Sasha7b9Work/Linia/doc/РД/Описание регистров.docx

Измеритель тока (блок коллектора)

Источник 3 кВ (блок коллектора)

Формирователь развёртки (блок коллектора)

ИЗМЕРИТЕЛЬ ТОКА (БЛОК КОЛЛЕКТОРА)

Диапазоны измерителя тока (сентябрь 2026)

| Вид развертки | Предел | Диапазон | № | Q2 : Q4 | Коэф-т отклонения | Ку | Q0, Q1 | Q7 | Дискрет
Реж. Большого тока | Только импульсы 10, 20, 50, 100 мкс | 400 A 2.5 мОм (5 мОм //5 мОм) | 400 А | 1 | 101 | 40 А/дел. | 1 | 00 | 0
| | | 200 А | 2 | | 20 А/дел. | 2 | 01
| | | 100 А | 3 | | 10 А/дел. | 4 | 10
| | | 50 А | 4 | | 5 А/дел. | 8 | 11
| | | 20 А | 5 | | 2 А/дел. | 20 | 01 | 1
| | | 10 А | 6 | | 1 А/дел. | 40 | 10
| | | 5 А | 7 | | 0,5 А/дел. | 80 | 11
| | 10 А (20 А) 50 мОм | | | запрещенный диапазон
Режим Высокого напряжения | SIN, АС, Импульсы ≥0,2 мс | | 10 А | 8 | 100 | 1 А/дел. | 2 | 01 | 0
| | | 5 А | 9 | | 0,5 А/дел. | 4 | 10
| | | 2 А | 10 | | 0,2 А/дел. | 10 | 00 | 1
| | | 1 А | 11 | | 0,1 А/дел. | 20 | 01
| | | 0,5 А | 12 | | 50 мА/дел. | 40 | 10
| | 200мА 5 Ом | 0,2 А | 13 | 011 | 20 мА/дел. | 1 | 00 | 0
| | | 0,1 А | 14 | | 10 мА/дел. | 2 | 01
| | | 50 мА | 15 | | 5 мА/дел. | 4 | 10
| | | 20 мА | 16 | | 2 мА/дел. | 10 | 00 | 1
| | | 10 мА | 17 | | 1 мА/дел. | 20 | 01
| | | 5 мА | 18 | | 0,5 мА/дел. | 40 | 10
| DC, SIN, АС, Имп.. ≥0,2 мс | 2мА 500 Ом | 2 мА | 19 | 010 | 0,2 мА/дел. | 1 | 00 | 0
| | | 1 мА | 20 | | 0,1 мА/дел. | 2 | 01
| | | 0,5 мА | 21 | | 50 мкА/дел. | 4 | 10
| | | 0,2 мА | 22 | | 20 мкА/дел. | 10 | 00 | 1
| | | 0,1 мА | 23 | | 10 мкА/дел. | 20 | 01
| | | 50 мкА | 24 | | 5 мкА/дел. | 40 | 10
| DC, SIN, АС | 20мкА 50 кОм | 20 мкА | 25 | 001 | 2 мкА/дел. | 1 | 00 | 0
| | | 10 мкА | 26 | | 1 мкА/дел. | 2 | 01
| | | 5 мкА | 27 | | 0,5 мкА/дел. | 4 | 10
| | | 2 мкА | 28 | | 0,2 мкА/дел. | 10 | 00 | 1
| | | 1 мкА | 29 | | 0,1 мкА/дел. | 20 | 01
| | | 0,5 мкА | 30 | | 50 нА/дел. | 40 | 10
| Только DC | 200нА 5 МОм | 0,2 мкА | 31 | 000 | 20 нА/дел. | 1 | 00 | 0
| | | 0,1 мкА | 32 | | 10 нА/дел. | 2 | 01
| | | 50 нА | 33 | | 5 нА/дел. | 4 | 10
| | | 20 нА | 34 | | 2 нА/дел. | 10 | 00 | 1
| | | 10 нА | 35 | | 1 нА/дел. | 20 | 01
| | | 5 нА | 36 | | 0,5 нА/дел. | 40 | 10

В диапаз. 10 А поддиапазон 20 А запрещен. В диапазоне напряжения 3 кВ макс. диапаз. тока 50 мА (5 Ом).

В диапаз. 300 В макс. диапазон тока – 0,5 А (50 мОм). В диапаз. 30 В макс. диапаз. тока – 10 А (50 мОм).

Напряжение на Rш ≤ 1В. Порог OVLI,1 = 3В. Стабилизаторы +8В и -8В

В диапазоне 400 А доп. поддиапазон 5 А (Ку = 80). В режиме DC максимальный диапазон тока 2 мА (500 Ом). Дополнительный ОУ (TLV) перед ADA4946.

В режиме DC необходима дополнительная фильтрация, поэтому Q6 д.б. установлен в 1.

С учетом запаса на калибровку, каждый предел измерения (400А, 20А, 0,2А … 200нА) соотв. коду 16ти разр. АЦП = 29440. Это позволяет рассчитать величину дискрета в каждом диапазоне.

Назначение разрядов регистров в измерителе тока.

Разряд | Значения разрядов и их комбинации | Функциональное назначение
Q0:Q1 коэффициент | 00 | Установка коэффициента *1.
| 01 | Установка коэффициента *2.
| 10 | Установка коэффициента *4.
| 11 | Установка коэффициента *8.
Q2:Q4 пределы | 000 | Предел: 200 нА.
| 001 | Предел: 20 мкА.
| 010 | Предел: 2 мА.
| 011 | Предел: 200 мА.
| 100 | Предел: 20 А.
| 101 | Предел: 200 А.
Q5 | 0 | Блокировка сигнала “OVLI,1” о превышении порогового уровня тока в режимах “Коллектор в обрыве” и “Стоп”. (В шине – сигнал “unOVLI,1”).
| 1 | Для всех остальных режимов.
Q6 | 0 | Для всех режимов кроме DC.
| 1 | Доп. ёмкость в режиме DC.
Q7 коэффициент | 0 | Установка коэффициента *1.
| 1 | Установка коэффициента *10.

ИСТОЧНИК 3кВ (БЛОК КОЛЛЕКТОРА)

Разряд | Значения разрядов и их комбинации | Функциональное назначение
Q0 полярность | 0 | Положительная полярность выходного сигнала.
| 1 | Отрицательная полярность выходного сигнала.
Q3:Q1 пределы | 000 | Обрыв коллектора
| 001 | Предел: ±30 В. (Rподгруз – 2шт. ~ по 15 кОм)(R13,R19)
| 010 | Предел: ±300 В. (Rподгруз – 2шт. ~ по 470 кОм)(R17,R18)
| 011 | Предел: ±3000 В. (Rподгруз – 1шт. ~ 18 МОм)(R33)
Q4 режим | 0 | Выбор режима AC.
| 1 | Выбор режима DC, SIN, IMP
Q5 фильтр | 0 | Сглаживающий фильтр отключен.
| 1 | Сглаживающий фильтр включен.
Q6 | 0 | Совместном включении диапазона источника 300 В и диапазона измерителя 200 мА ( 0 – выкл, 1 – вкл) (Вкл. Резистора защиты 15 Ом)
| 1
Q7 | 0 | Совместное включении диапазона источника 30 В и диапазона измерителя 200мА ( 0 – выкл, 1 – вкл) (Вкл. Резистора защиты 1,5 Ом)
| 1

1 - В режиме AC значение бита Q0 = 0.

2 - В режиме DC значение бита Q5 = 1, в остальных режимах Q5 = 0.

3 - Положения переключателя +50В / ±3000В / -50В устанавливаются вручную.

В положении ±3000В возможна программная установка ±30В, ±300В и ±3000В.

4 - В режиме "Обрыв коллектора" - разомкнуты все ВХОДНЫЕ реле и реле разряда конденсатора. (Q4 =0, Q0=0, Q3:Q1 = 000, Q5 = X)

ФОРМИРОВАТЕЛЬ РАЗВЁРТКИ (БЛОК КОЛЛЕКТОРА)

Q0 | | | | -
Q1 | | | | -
Q2 | | | | Множитель: x20
Q3 | | | | Множитель: x5
Q4 | | | | Множитель: x1
Q5 | | | | Множитель: ÷5
Q6 | | | | Множитель: ÷1.25
Q7 | | | | Множитель: ÷5 или ÷250
№ | диапазон | Коэффициент отклонения | Q7 :250, :5 | Q5Q6 :2;:1,25;:1 | Q4Q3Q2 x1;x5;x20 | Код ЦАП | Коэффициенты
1 | 5000V | 500V/дел | 0 | 00 | 100 | 819 | :250, :2, x1, :5
2 | 2000V | 200 V/дел | 0 | 11 | 100 | 1280 | :250, :1,25, x1, :3,2
3 | 1000V | 100 V/дел | 0 | 01 | 100 | 2048 | :250, :1, x1, :2
4 | 500V | 50 V/дел | 0 | 01 | 100 | 4095 | :250, :1, x1, :1
5 | 200V | 20 V/дел | 0 | 01 | 010 | 2048 | :250, :1, x5, :2
6 | 100V | 10 V/дел | 0 | 01 | 010 | 4095 | :250, :1, x5, :1
7 | 50V | 5 V/дел | 1 | 00 | 100 | 1638 | :5, :2, x1, :2,5
8 | 20V | 2 V/дел | 1 | 01 | 100 | 2048 | :5, :1, x1, :2
9 | 10V | 1 V/дел | 1 | 01 | 100 | 4095 | :5, :1, x1, :1
10 | 5V | 0,5 V/дел | 1 | 11 | 010 | 2048 | :5, :1,25, x5, :2
11 | 2V | 0,2 V/дел | 1 | 01 | 010 | 4095 | :5, :1, x5, :1
12 | 1V | 0,1 V/дел | 1 | 01 | 001 | 2048 | :5, :1, x20, :2
13 | 0,5V | 0,05 V/дел | 1 | 01 | 001 | 4095 | :5, :1, x20, :1

На диапазоне 5000 В максимально допустимое напряжение 3500 В!! (Шкала – 5 кВ)

Примечание:

Входной диапазон АЦП = 1,9 В (Uref = 4,098).

При КADA = 0,7 предельное значение измеряемого сигнала на входе ADA составляет 2,7 В.

Запас на цифровую калибровку равен 27% (Диапазон входной сигнала ADA 1,4 В, по отношению к диапазону АЦП 1,9 В, составляет 1,4/1,9×100% = 73%)

Дата изменения: 03.03.2026
