Sasha7b9Work/Linia/doc/РД/Описание.docx

Формирователь развёртки XP7 – блок коллектора

REG управляющий регистр

DDAC динамический – управление с Orange Pi

DAC измерителя напряжения

ADC измерителя напряжения

Измеритель тока XP6 – блок коллектора

REG управляющий регистр

DAC

ADC измеритель тока

Источник напряжения 3kV – блок коллектора

REG управляющий регистр

Источник напряжения 50V XP10 – блок коллектора

DDAC динамический – управление с Orange Pi

База XP4

REG управляющий регистр

DAC1

DAC2

ADC

Подложка XP5

REG управляющий регистр

DAC1

DAC2

ADC

Коммутатор XP12

REG управляющий регистр

Диапазоны АЦП

Измеритель тока (блок коллектора)

Режим большого тока:
