Sasha7b9Work/Linia/doc/РД/ИППП3/Aлгоритм   Линия-2/Cигналы упр.каждым блоком _2.docx

Сигналы управления

№ | Наименование блока | ADC | DAC | РегистрУпр.
1 | Источник напряжения 3kV | ─ | ─ | 24р.
2 | Коммутатор | ─ | ─ | 16 р.
3 | Формирователь развертки и Измеритель напряжения | 18 р. | 12 р.Дин. 12 р. | 24-32 р.
5 | Источник-измеритель (канал базы) | 16 р. | 12 р. 12 р. | 32 р.
6 | Источник-измеритель (дополнительный канал) | 16 р. | 12 р. 12 р. | 32 р.
7 | Измеритель тока Опторазвязка – 10 кВ (на микросхемах TFDU6103-TR3) – 6 линий связи. | 16 р. | ─ | 16 р.
8 | Источник напряжения 50В (Формирователь импульсов 200 А) | | 12р. Дин. | 8 р
9 | Энкодер, Старт, Стоп,Индикатор измерения, Индикатор Вкл., USB-2шт.
10 | Задняя панель: Старт, Сигнал “Измерение”, Годен/Негоден,Ethenet

1Источникнапряжения 3 кВ

1 GNDn 2 CLKRgV- 3 CLKRgV+ 4 GNDn 5 DATRgV- 6 DATRgV+ 7 GNDn 8 Enb_RgV 9 +5Vn 10 +5Vn | GNDn – GND неизолированная, +5Vn – +5V неизолированные, CLKRgV– тактовые импульсы регистра V DATRgV–данные в регистр V EnbRgV – разрешение записи в регистр источника напряжения 3 кВ.

Коммутатор

1 GNDn 2 CLK RgK- 3 CLK RgK+ 4 GNDn 5 DAT RgK- 6 DAT RgK+ 7 GNDn 8 EnbRgK 9 +5Vn 10 +5Vn 11 3000vE 12 200-E 13 200+E 14 20-E 15 20+E 16 | CLKRgК – тактовые импульсы регистра К DATRgК–данные в регистр К EnbRgK – разрешение записи в регистр коммутатора 3000vE, 200-E, 200+E, 20-E, 20+E – сигналы управления с переключателя

Плата Формирователя разверткии Измерителя напряжения

Формирователь развертки

1й разъем
1 | DAT DA1-
2 | DAT DA1+
3 | GNDn
4 | CLK DA1-
5 | CLK DA1+
6 | +5Vn
7 | DATRgDU-
8 | DATRgDU+
9 | +5Vn
10 | CLK RgDU -
11 | CLK RgDU +
12 | +5Vn
13 | LINE-
14 | LINE+
15 | GNDn
16 | ENS
17 | Enb DA1
18 | EnbRgF
19 | Enb DU
20 | LIMIT

Измеритель напряжения

Конт-роллер | 2й разъем в измерителе
| Изме-ритель | Сигналы
21 | 1 | OVLW
22 | 2 | GNDn
23 | 3 | RUN ADU-
24 | 4 | RUN ADU+
25 | 5
26 | 6 | +5Vn
27 | 7 | +5Vn
28 | 8 | GNDn
29 | 9 | DAT ADU-
30 | 0 | DAT ADU+
31 | 11 | GNDn
32 | 12 | CLKADU-
33 | 13 | CLKADU+
34 | 14 | GNDn
35 | 15 | RUN ADU-
36 | 16 | RUN ADU+
37
38
39
40

LINE - меандр 50 Гц (идет в контроллер),

OVLW ??- сигнал перегрузки по мощности с формирователя (идет в контроллер),

LIMIT - сигнал перегрузки общий, формируется контроллером (перегрузка любого из модулей).

ENS - используется для управления работой трансформатора на основе временной

диаграммы для каждого режима работы

DA1- Первый динамический DAC,

DATDA1- данные для DA1,

CLKDA1 -такт. импульсы для DA1,

ENBDA1 – выбор DA1

RgF- регистр формирователя

DU-DAC измерителя U,

DATRgDU - данные для регистраRgFиDU

CLKRgDU- такт.имп. для регистра RgFи DU,

EnbRgF – выбор RgF,

EnbDU - выбор DU

DATDU– данныеDU,

ADU – ADC в измерителеU

RUN ADU-пускADU

CLK ADU–такт.имп. ADU,

DATADU -данные отADU. (идет в контроллер)

Канал базы(Источник-измеритель)

1й разъем
1 | GNDn
2 | DATRgDB-
3 | DATRgDB+
4 | GNDn
| CLKRgDB-
6 | CLKRgDB+
7 | GNDn
8 | Enb D1В
9 | Enb D2В
10 | EnbRgВ
11 | +5Vn
12 | RUN-ADB
13 | RUN+ADB
14 | +5Vn
15 | CLKADB -
16 | CLKADB +
17 | +5Vn
18 | DATADB-
19 | DATADB+
20 | +5Vn

Конт-роллер | 2й разъем в базе
| База | Сигналы
21 | 1 | GNDn
22 | 2 | IMPb+/-v
23 | 3 | GNDn
24 | 4 | IMPb-
25 | 5 | IMPb+
26 | 6 | GNDn
27 | 7 | OVLВ
28 | 8 | LIMIT
29 | 9 | 3/50V
30 | 10

DATRgDBданные для регистра и DACов 1 и 2блока базы,

CLKRgDB– тактовые импульсы для регистра и DACов 1 и 2блока базы,

EnbD1В – выбор DAC 1 блока базы,

EnbD2В – выбор DAC 2 блока базы,

EnbRgВ– выбор регистра базы,

RUN+B– пускADC блока базы,

CLKADB– тактовые импульсы ADC блока базы,

DATADB – данные ADC из блока базы,

IMPb+/-v– импульсы в канале базы в режиме высокого напряжения положительные и отрицательные(0,2, 0,5 1,0 мс),

При отсутствии сигнала IMP+/-B , на этом проводе должен быть высокий уровень,

IMPВ- –параф.имп. в реж.Большого тока,

IMPВ+– параф.имп. в реж.Большого тока,

OVLB - сигнал перегрузки блока базы,

LIMITсигнал перегрузки общий, формируется контроллером (перегрузка одного из модулей).

3/50 – режим высокого напряжения /режим большого тока

Дополнительный канал (Подложки Источник-измеритель)

1 GNDn 2 DATRgDР- 3 DATRgDР+ 4 GNDn 5 CLKRgDР- 6 CLK RgDР+ 7 GNDn 8 Enb D1Р 9 Enb D2Р 10 EnbRgР 11 +5Vn 12 RUN-ADР 13 RUN+ADР 14 +5Vn 15 CLK ADР - 16 CLK ADР + 17 +5Vn 18 DATADР- 19 DATADР+ 20 +5Vn | Конт-роллер 2йразъем в подложке Под-ложка 21 1 GNDn 22 2 23 3 GNDn 24 4 25 5 26 6 GNDn 27 7 OVLР 28 8 LIMIТ 29 9 30 10 | DATRgDР данные для регистра и 1 и 2 DAC-овдополнительного блока, CLKRgDР – тактовые импульсы для регистра и 1 и 2DACовдоп. блока, EnbD1Р – выбор DAC 1 доп. блока, EnbD2Р – выбор DAC 2 доп.блока, EnbRgР – выбор регистра доп. блока, RUN+Р– пускADCдоп.блока, CLKADР– тактовые импульсы ADC доп. блока, DATADР – данные ADC издоп.блока, OVLР - сигнал перегрузки доп.блока, LIMITсигнал перегрузки общий, формируется контроллером (перегрузка одного из модулей).

Измеритель тока

1 GNDn 2 DAT RgI- 3 DAT RgI+ 4 GNDn 5 CLK RgI- 6 CLK RgI+ 7 GNDn 8 EnbRgI 9 RUN-ADI- 10 RUN+ADI+ 11 GNDn 12 CLK ADI- 13 CLK ADI+ 14 +5Vn 15 DAT ADI- 16 DAT ADI+ 17 +5Vn 18 OVLI,1 19 SPEED 20 +5Vn | DATRgI– данные для регистра CLKRgI– тактовые импульсы для регистра EnbRgI– выбор 2го динамического DACa, RUN-ADI–пуск АЦП измерителя тока CLKADI–такт. имп. АЦП измерителя тока DATADI–вых. данные АЦП измерителя тока OVLI,1–сигнал перегрузки по току (I,1) SPEED–сигнал включения высокой скорости передачи

Источник напряжения 50 В

1 | GNDn
2 | DATDA2-
3 | DATDA2+
4 | GNDn
5 | CLKDA2-
6 | CLKDA2+
7 | GNDn
8 | EnbDA2
9 | +5Vn
10 | IMPc-
11 | IMPc+
12 | +5Vn
13 | LIMIT
14 | OVLI,2
15 | 50E+
16 | 50E-
17 | EIMP
18
19 | +5Vn
20 | GNDn

DATDA2- – данные 2го динамического DACa,

CLKDA2- – тактовые импульсы2го динамического DACa,

EnbDA2 – выбор 2го динамического DACa,

IMPc- –параф.имп. в реж.Большого тока,

IMPc+ –параф.имп. в реж.Большого тока,

EIMP - В режиме Большого тока сигнал EIMP, длительностью от 5 до 10 мс, должен вырабатываться контроллером не реже чем через 5 ÷ 10 секунд в паузах между импульсами, которые в этом режиме должны составлять не менее 0,4 сек. То-есть 5÷10 мс в течение 400 мс. В режиме Высокого напряжения сигнал EIMPпостоянно остается низким (логич. ноль).

50E-,50E+ - формируются STM32F4

ПЕРЕДНЯЯ ПАНЕЛЬ

Энкодер 1 +5Vn 2 А 3 В 4 GNDn | Старт, Стоп, Индикаторы 1 Старт 2 GNDn 3 Стоп 4 GNDn 5 +Vdmeas 6 GNDn 7 GNDn 8 +VdВкл.сети | Кнопка «Сброс» | USB – 2шт.

Задняя панель:

Ethenet | 1 Старт 2 GNDn 3 Сигн. «Измерение» 4 GNDn 5 Годен/Негоден
