Sasha7b9Work/Linia/doc/РД/ИППП3/Aлгоритм   Линия-2/4_Сигналы Линии(фрагмент).docx

Основные сигналы схемы

1. Start, Stop - сигналы кнопок START, STOP – начало и завершение измерения ВАХ

Эти сигналы приходят с внешней панели прибора. Для работы в схеме

предусмотреть подтягивающие резисторы на питание 3.3 В ( ORANGE)

Энкодер расположен на передней панели. Он соединен с платой контроллера 2- сигнальными проводами и проводом GND. Выбрать свободные порты (4 pin.) GP40PIN для подключения кнопок и энкодера.

2. DAT_F0 - <DAT_F3 - выходные данные памяти FIFO

3. req_rd – запрос на чтение данных из памяти FIFO, формируется компьютером, когда FIFO полное

4. full (ff) – флаг FIFO , ff – FIFO полное. Если ff=0, то в FIFO записывать нельзя

5. empty(ef) – флаг FIFO, ef – сигнализирует что FIFO пустое. Если ef=1, то из FIFO

можно прочитать данные.

6. Tx ,Rx – сигналы передачи последовательного интерфейса (RS232). Используется для

передачи установок от Host контроллера Slave контроллеру, передачи

сообщений от Slave контроллера Host контроллеру.

Использовать 2 pin. GP40PIN

pin 8 – Tx;

pin. 10 – Rx.

7. SPI1_CLK, SPI1_MOSI – сигналы последовательного интерфейса (SPI), которые

используются для установки кодов 2-х динамических ЦАП,

устанавливаемых энкодером.

Использовать 2 pin. GP40PI

pin. 23 – SPI1_CLK;

pin. 19 – SPI1_MOSI

SPI2_CLK, SPI2_MOSI – сигналы последовательного интерфейса (SPI), которые

используются для установки кодов 2-го ЦАП,

устанавливаемого энкодером.

Использовать 2 pin. GP40PI

pin. 35 – SPI1_CLK;

pin. 31– SPI1_MOSI

8. Enb_PC – сигнал готовности для ПЛИС, все операции по установкам, выполняемых

Host контролером завершены. – лог. “1 “.

Использовать 1 pin. GP40PI

9. RDY – сигнал готовность передач по интерфейсу RS232. Лог. “1” – линия свободна,

можно передавать. Лог. “0” - один из контроллеров передает данные.

10. Run_ADC – сигнал запуска АЦП – ( отдельные сигналы 4-х АЦП)

11. Enb1 – Enb12 – сигнал выбора программируемых устройств блоков прибора.

Формируется STM32F4.

12. ENS – используется для управления работой трансформатора на основе временной

диаграммы( для каждого режима работы своя)

ENS – лог. “ 1 “ - выполняетя аналого- цифровое преобразование;

ENS – лог. “ 0 “ - аналого- цифровое преобразование завершено и можно

выполнять чтение массива;

13. LIMIT – сигнал ограничения, вырабатывается ПЛИС, для его формирования Slave

контроллер использует сигналы OVB, OVI, OVP, OVLP, OVLI. Сообщение о перегрузке посылается Host контроллеру и ПЛИС

14. LINE - (SBOR) – подается с формирователя в виде парофазного сигнала на ПЛИС.

Получен из сигнала “Сеть”.

15 . DAT_AD1 – DAT_ADC4 – выходы последовательных данных АЦП. Парофазные

сигналы поступают синхронно с тактовыми сигналами

чтения АЦП CLK_ADC

16. CLK_ADC1 - CLK_ADC4 - тактовый сигнал чтения АЦП. CLK_ADC – 19 импульсов

с задержкой 3 мкс. относительно сигнала RUN

17. req_wr – сигнал запроса записи в память FIFO (внутренний сигнал ПЛИС)

18. A0, A1 - адресные входы сдвиговых регистров ПЛИС для записи установок для

формирования временной диаграммы.

19. Clk_rg – тактовый сигнал для записи последовательных данных в сдвиговый регистр

ПЛИС

20. Wr_rg – сигнал записи данных из сдвигового регистра в регистр ПЛИС

21 Dat_rg – данные для записи в сдвиговый регистр

22. Enb_STM – сигнал готовности STM32, все операции программирования регистров и

ЦАП выполнены.

23. +50 200 A, -50 200 A, +50 20 A, -50 20 A, 3000 V – сигналы переключателя

24. opn/cls - сигнал датчика крышки

25. OVI - сигнал перегрузки модуля ~~источника~~ измерителя тока

26. OVB - сигнал перегрузки модуля базы

27. OVP - сигнал перегрузки модуля подложки

28. OVLP - сигнал перегрузки по мощности с формирователя

OVLI - сигнал перегрузки по по току с источника 200А

29. Запись данных в DAC и регистры блоков прибора выполняется по последовательному

интерфейсу сигналами CLK1_DAC, DAT1_DAC, CLK2_DAC, DAT2_DAC. Выбор программируемых узлов в блоке осуществляется сигналами разрешения E1- E12 ( лог. “1”).

Динамические DAC (2 DAC) управляются компьютером по шине SPI сигналами

SPI1_CLK, SPI1_MOSI, SPI2_CLK, SPI2_MOSI. (формирователь развертки и ~~формирователь импульсов~~ – Источник напряжения 200А)

Согласно регистровой схеме измерителя (табличный вариант) количество сигналов разрешения следующее:

- блок базы – 2 сигнала разрешения для выбора DAC, 1 сигнал разрешения для выбора

управляющего регистра;

- блок затвора – 2 сигнала разрешения для выбора DAC, 1 сигнал разрешения для

выбора управляющего регистра;

- формирователь развертки и измеритель напряжения - 2 сигнала разрешения для

выбора управляющего регистра;

- источник напряжения - 1 сигнал разрешения для выбора управляющего регистра;

- измеритель тока - 1 сигнал разрешения для выбора управляющего регистра;

- формирователь импульсов (Источник напряжения 200А) - 1 сигнал разрешения для выбора управляющего регистра;

- коммутатор - 1 сигнал разрешения для выбора управляющего регистра;

Всего требуется 12 сигналов разрешения E1- E12. Эти сигналы формируются

STM32F4.

Сигналы для импульсного режима

а) Режим Высокого напряжения в канале С:

- парные импульсы ENS Imp+ и ENS Imp- (развертка положительным напряжением в канале С)

- парные импульсы ENS Imp- и ENS Imp+ (развертка отрицательным напряжением в канале С).

Второй импульс в этих парах для размагничивания трансформатора.

б) Режим Высокого напряжения в канале В:

- IMP+B (развертка положительным напряжением в канале В),

- IMP-B (развертка отрицательным напряжением в канале В).

в) Режим Большого тока в канале С:

- парафазный сигнал IMP+ (развертка положительным напряжением в канале С)

- парафазный сигнал IMP- (развертка отрицательным напряжением в канале С).

В режиме Большого тока в паузах между импульсами (400 мс) необходим дополнительный сигнал EIMP (активный 0), длительностью от 5 до 10 мс, с интервалом 0,4 ÷ 10 сек. В режиме Высокого напряжения сигнал EIMP постоянный низкий уровень.

г) Режим Большого тока в канале В:

- парафазный сигнал IMВ+ (развертка положительным напряжением в канале В),

- парафазный сигнал IMВ- (развертка отрицательным напряжением в канале В).

EIMP ─ низкий уровень.

Регистровая схема измерителя (табличный вариант)

№ | Наименование блока | ADC | DAC | Регистр упр. | Импульсы синхронные с сигналом стробирования
1 | Источник напряжения | ─ | ─ | 24р.
2 | Коммутатор | ─ | ─ | 16 р.
3 | Формирователь развертки и Измеритель напряжения | 16 р. | 12 р. Динамич. 12 р. | 24-32 р.
5 | Источник-измеритель (канал базы) | 16 р. | 12 р. 12 р. | 32 р.
6 | Источник-измеритель (дополнительный канал) | 16 р. | 12 р. 12 р. | 32 р.
7 | Измеритель тока Опторазвязка – 10 кВ (на микросхемах TFDU6103-TR3) – 6 линий связи. | 16 р. | ─ | 16 р.
8 | Формирователь импульсов 200 А | | 12р Динамич. | 8 р | 100, 50, 20, 10мкс
