Sasha7b9Work/Linia/doc/РД/ИППП3/Aлгоритм   Линия-2/Cигналы упр.каждым блоком 20062025.docx

Сигналы управления

№ | Наименование блока | ADC | DAC | Регистр Упр.
1 | Источник напряжения 3kV | ─ | ─ | 24р.
2 | Коммутатор | ─ | ─ | 16 р.
3 | Формирователь развертки и Измеритель напряжения | 18 р. | 12 р. Дин. 12 р. | 24-32 р.
5 | Источник-измеритель (канал базы) | 16 р. | 12 р. 12 р. | 32 р.
6 | Источник-измеритель (дополнительный канал) | 16 р. | 12 р. 12 р. | 32 р.
7 | Измеритель тока | 16 р. | ─ | 16 р.
8 | Источник напряжения 50В | | 12р. Дин. | 8 р
9 | Энкодер, Старт, Стоп, Индикатор измерения, Индикатор Вкл., USB-2шт.
10 | Задняя панель: Старт, Сигнал “Измерение” , Годен/Негоден, Ethenet

12. ENS – используется для управления работой трансформатора на основе временной

диаграммы( для каждого режима работы своя)

~~ENS~~ ~~–~~ ~~лог~~~~.~~ ~~“ 1 “ -~~ ~~выполняетя аналого- цифровое преобразование~~~~;~~

~~ENS~~ ~~–~~ ~~лог~~~~.~~ ~~“ 0 “ -~~ ~~аналого- цифровое преобразование завершено и можно~~

~~выполнять чтение массива~~~~;~~

13. LIMIT – сигнал ограничения, вырабатывается ПЛИС, для его формирования Slave

контроллер использует сигналы OVB, OVI, OVP, OVLP, OVLI. Сообщение о перегрузке посылается Host контроллеру и ПЛИС

25. OVLI,1 - сигнал перегрузки ~~модуля и~~~~сточника~~ измерителя тока

26. OVLB - сигнал перегрузки модуля базы

27. OVLP - сигнал перегрузки модуля подложки

28. OVLW - сигнал перегрузки по мощности от формирователя развертки

OVLI,2 - сигнал перегрузки по по току от источника 50 B

LIMIT сигнал перегрузки общий, формируется ПЛИС (перегрузка одного из модулей) для мгновенного (аппаратного) выключения всех модулей (блоков).

Сигналы для импульсного режима

а) Режим Высокого напряжения в канале С:

- парные импульсы ENS Imp+ и ENS Imp- (развертка положительным напряжением в канале С)

- парные импульсы ENS Imp- и ENS Imp+ (развертка отрицательным напряжением в канале С).

Второй импульс в этих парах для размагничивания трансформатора.

б) Режим Высокого напряжения в канале В:

- IMP+B (импульс соответствует положительной волне напряжения в канале С),

- IMP-B (импульс соответствует отрицательной волне напряжения в канале С).

в) Режим Большого тока в канале С:

- парафазный сигнал IMP+ (развертка положительным напряжением в канале С)

- парафазный сигнал IMP- (развертка отрицательным напряжением в канале С).

В режиме Большого тока в паузах между импульсами (400 мс) необходим дополнительный сигнал EIMP (активный 0), длительностью от 5 до 10 мс, с интервалом 0,4 ÷ 10 сек. В режиме Высокого напряжения сигнал EIMP постоянный низкий уровень.

г) Режим Большого тока в канале В:

- парафазный сигнал IMВ+ (развертка положительным напряжением в канале В),

- парафазный сигнал IMВ- (развертка отрицательным напряжением в канале В).

EIMP ─ низкий уровень.

1 Источник напряжения 3 кВ

1 GNDn 2 CLK RgV- 3 CLK RgV+ 4 GNDn 5 DAT RgV- 6 DAT RgV+ 7 +3Vn 8 Enb_RgV 9 +5Vn 10 +5Vn | GNDn – GND неизолированная, +5Vn – +5V неизолированные, CLK RgV – тактовые импульсы регистра V DAT RgV – данные в регистр V Enb RgV – разрешение записи в регистр источника напряжения 3 кВ.

Коммутатор

1 GNDn 2 CLK RgK- 3 CLK RgK+ 4 GNDn 5 DAT RgK- 6 DAT RgK+ 7 +3Vn 8 Enb RgK 9 +5Vn 10 +5Vn 11 3000vE 12 200-E 13 200+E 14 20-E 15 20+E 16 | CLK RgК – тактовые импульсы регистра К DAT RgК – данные в регистр К Enb RgK – разрешение записи в регистр коммутатора 3000vE, 200-E, 200+E, 20-E, 20+E – сигналы управления с переключателя для управления режимами работы измерителя

Плата Формирователя развертки и Измерителя напряжения

Формирователь развертки

1й разъем
1 | DAT DA1-
2 | DAT DA1+
3 | GNDn
4 | CLK DA1-
5 | CLK DA1+
6 | +5Vn
7 | DAT RgDU-
8 | DAT RgDU+
9 | +5Vn
10 | CLK RgDU -
11 | CLK RgDU +
12 | +5Vn
13 | LINE-
14 | LINE+
15 | GNDn
16 | ENS
17 | Enb DA1
18 | Enb RgF
19 | Enb DU
20 | LIMIT

Измеритель напряжения

Конт-роллер | 2й разъем в измерителе
| Изме-ритель | Сигналы
21 | 1 | OVLW
22 | 2
23 | 3
24 | 4
25 | 5
26 | 6 | +3Vn
27 | 7 | +5Vn
28 | 8 | GNDn
29 | 9 | DAT ADU-
30 | 10 | DAT ADU+
31 | 11 | GNDn
32 | 12 | CLK ADU-
33 | 13 | CLK ADU+
34 | 14 | GNDn
35 | 15 | RUN ADU-
36 | 16 | RUN ADU+
37
38
39
40

LINE - меандр 50 Гц (идет в контроллер),

OVLW ?? - сигнал перегрузки по мощности с формирователя (идет в контроллер),

LIMIT - сигнал перегрузки общий, формируется контроллером (перегрузка любого из модулей).

ENS - используется для управления работой трансформатора на основе временной

диаграммы для каждого режима работы

DA1 - Первый динамический DAC,

DAT DA1 - данные для DA1 ,

CLK DA1 - такт. импульсы для DA1,

ENB DA1 – выбор DA1

RgF - регистр формирователя

DU - DAC измерителя U,

DAT RgDU - данные для регистра RgF и DU

CLK RgDU - такт. имп. для регистра RgF и DU,

Enb RgF – выбор RgF,

Enb DU - выбор DU

DAT DU – данные DU,

ADU – ADC в измерителе U

RUN ADU - пуск ADU

CLK ADU – такт. имп. ADU,

DAT ADU - данные от ADU. (идет в контроллер)

Канал базы (Источник-измеритель)

1й разъем
1 | GNDn
2 | DAT RgDB-
3 | DAT RgDB+
4 | GNDn
5 | CLK RgDB-
6 | CLK RgDB+
7 | GNDn
8 | Enb D1В
9 | Enb D2В
10 | Enb RgВ
11 | +5Vn
12 | RUN-ADB
13 | RUN+ADB
14 | +5Vn
15 | CLK ADB -
16 | CLK ADB +
17 | +5Vn
18 | DAT ADB-
19 | DAT ADB+
20 | +3Vn

Конт-роллер | 2й разъем в базе
| База | Сигналы
21 | 1 | GNDn
22 | 2 | IMPb+/-v
23 | 3 | GNDn
24 | 4 | IMPb-
25 | 5 | IMPb+
26 | 6 | GNDn
27 | 7 | OVLВ
28 | 8 | LIMIT
29 | 9 | 3/50V
30 | 10

DAT RgDB данные для регистра и DACов 1 и 2 блока базы,

CLK RgDB – тактовые импульсы для регистра и DACов 1 и 2 блока базы,

Enb D1В – выбор DAC 1 блока базы,

Enb D2В – выбор DAC 2 блока базы,

Enb RgВ – выбор регистра базы,

RUN+B – пуск ADC блока базы,

CLK ADB – тактовые импульсы ADC блока базы,

DAT ADB – данные ADC из блока базы,

IMPb+/-v – импульсы в канале базы в режиме высокого напряжения (однофазные)

─ IMP+B (импульс соответствует положительной волне напряжения в канале С),

─ IMP-B (импульс соответствует отрицательной волне напряжения в канале С). См. диаграммы.

При отсутствии сигнала IMPb+/-v , на этом проводе должен быть высокий уровень,

IMPВ- – парафазн. имп. в реж.Большого тока,

IMPВ+ – парафазн. имп. в реж.Большого тока,

OVLB - сигнал перегрузки блока базы,

LIMIT сигнал перегрузки общий, формируется контроллером (перегрузка одного из модулей).

3/50V – режим Высокого напряжения/режим Большого тока, формируется программно для выбора между IMPb+/-v и IMPb-( IMPb+)

Дополнительный канал (Подложки Источник-измеритель)

1 GNDn 2 DAT RgDР- 3 DAT RgDР+ 4 GNDn 5 CLK RgDР- 6 CLK RgDР+ 7 GNDn 8 Enb D1Р 9 Enb D2Р 10 Enb RgР 11 +5Vn 12 RUN-ADР 13 RUN+ADР 14 +5Vn 15 CLK ADР - 16 CLK ADР + 17 +5Vn 18 DAT ADР- 19 DAT ADР+ 20 +3Vn | Конт-роллер 2й разъем в подложке Под-ложка 21 1 GNDn 22 2 23 3 GNDn 24 4 25 5 26 6 GNDn 27 7 OVLР 28 8 LIMIТ 29 9 30 10 | DAT RgDР данные для регистра и 1 и 2 DAC-ов дополнительного блока, CLK RgDР – тактовые импульсы для регистра и 1 и 2 DACов доп. блока, Enb D1Р – выбор DAC 1 доп. блока, Enb D2Р – выбор DAC 2 доп. блока, Enb RgР – выбор регистра доп. блока, RUN+Р – пуск ADC доп. блока, CLK ADР – тактовые импульсы ADC доп. блока, DAT ADР – данные ADC из доп. блока, OVLР - сигнал перегрузки доп. блока, LIMIT сигнал перегрузки общий, формируется контроллером (перегрузка одного из модулей).

Измеритель тока

1 GNDn 2 DAT RgI- 3 DAT RgI+ 4 GNDn 5 CLK RgI- 6 CLK RgI+ 7 GNDn 8 Enb RgI 9 RUN-ADI- 10 RUN+ADI+ 11 GNDn 12 CLK ADI- 13 CLK ADI+ 14 +5Vn 15 DAT ADI- 16 DAT ADI+ 17 +5Vn 18 OVLI,1 19 SPEED 20 +3Vn | DAT RgI – данные для регистра CLK RgI – тактовые импульсы для регистра Enb RgI – выбор записи в регистр, RUN-ADI – пуск АЦП измерителя тока CLK ADI – такт. имп. АЦП измерителя тока DAT ADI – вых. данные АЦП измерителя тока OVLI,1 – сигнал перегрузки по току (I,1) SPEED – сигнал включения высокой скорости передачи

Источник напряжения 50 В (200 А)

1 | GNDn
2 | DAT DA2-
3 | DAT DA2+
4 | GNDn
5 | CLK DA2-
6 | CLK DA2+
7 | GNDn
8 | Enb DA2
9 | +5Vn
10 | IMPc-
11 | IMPc+
12 | +5Vn
13 | LIMIT
14 | OVLI,2
15 | 50E+
16 | 50E-
17 | EIMP
18
19 | +3Vn
20 | GNDn

DAT DA2- – данные 2го динамического DACa,

CLK DA2- – тактовые импульсы 2го динамического DACa,

Enb DA2 – выбор 2го динамического DACa,

IMPc- – параф.имп. в реж.Большого тока,

IMPc+ – параф.имп. в реж.Большого тока,

EIMP - В режиме Большого тока сигнал EIMP, длительностью порядка 20 мс, должен вырабатываться контроллером синхронно с импульсами, паузы между которыми в этом режиме должны составлять не менее 0,4 сек, как показано на рисунке ниже.

В режиме Высокого напряжения сигнал EIMP должен быть постоянно низким (логич. ноль).

ПЕРЕДНЯЯ ПАНЕЛЬ

Энкодер 1 +5Vn 2 А 3 В 4 GNDn | Старт, Стоп, Индикаторы 1 Старт 2 GNDn 3 Стоп 4 GNDn 5 +Vd meas 6 GNDn 7 GNDn 8 +Vd Вкл.сети | Кнопка «Сброс» | USB – 2шт.

Задняя панель:

Ethernet | 1 Старт 2 GNDn 3 Сигн. «Измерение» 4 GNDn 5 Годен/Негоден
