Sasha7b9Work/Linia/sources/ServerHTTP/readme.txt

Этот сервер нужно запускать на linux, чтобы он принимал сообщения от программы Linia.
