Sasha7b9Work/Linia/doc/_OrangePi/ОС/_Установка_старая/Загрузка по нажатию на ярлык/README.md

Linia2.desktop положить в /home/mnipi/Desktop
local.pkexec.linia2.policy - в /usr/share/polkit-1/actions/

Для автоматической загрузки при старте системы скопировать Linia2.desktop в /home/mnipi/.config.autostart
