Sasha7b9Work/Linia/doc/_OrangePi/ОС/_Установка_старая/links.txt

*** После установки ***
- Обновление загрузчика и прошивки
    # Вам понадобится другая SD-карта с рабочей системой
    sudo nand-sata-update
    sudo update-initramfs -u
- Патч для NVMe
    apt install orangepi5plus-nvme-fix
- !!! ВНИМИНИЕ !!! ни в коем случае не делать установку последнего ядра
    apt install linux-image-current-rockchip64
- Содержимое /etc/apt/sources.list.d/sources.list
    deb http://ports.ubuntu.com/ noble main restricted universe multiverse
    deb http://ports.ubuntu.com/ noble-updates main restricted universe multiverse
    deb http://ports.ubuntu.com/ noble-security main restricted universe multiverse
    Остальные не трогать (только ubuntu.sources вызывает сообщения об ошибках при apt update)

https://habr.com/ru/companies/timeweb/articles/861844/
https://github.com/schneid-l/u-boot-orangepi5
https://github.com/Joshua-Riek/ubuntu-rockchip
https://www.armbian.com/orange-pi-5-plus/
https://joshua-riek.github.io/ubuntu-rockchip-download/boards/orangepi-5-plus.html

*** Расширение раздела на весь диск ***
    apt install gparted

*** Запись образа *.img на карту ***
    balena etcher

*** Как сделать запуск приложения через ярлык под рутом ***
    sudo visudo

    добавить строку
    mnipi ALL = (root) NOPASSWD: /home/mnipi/Linia/sources/generated/Linia2/Linia2
    mnipi ALL = (root) NOPASSWD: /home/mnipi/Linia.sh

    в .desktop файл использовать
    Exec=sudo /home/mnipi/Linia/sources/generated/Linia2/Linia2
    
*** Включить spi, uart ***
    в утилите armbian-config включить соотвествующие интерфейсы
        rk3588-spi0-m2-cs0-cs1-spidev
        rk3588-uart6-m1
    Права на использование SPI, UART:
        1. usermod -a -G spi $USER
           usermod -a -G dialout $USER
           или
        2. sudo nano /etc/rc.local
            перед exit 0: добавить
           sudo chmod 666 /dev/gpiochip*
           sudo chmod 666 /dev/spidev*
    перезагрузить
    
*** Автологин ***
    XFCE:
    sudo nano /etc/lightdm/lightdm.conf
    [Seat:*]
    autologin-user=mnipi
    autologin-user-timeout=0

*** Автозапуск на старте ***
        создать файл ~/.config/autostart/linia.desktop:
    [Desktop Entry]
    Type=Application
    Name=linia
    Exec=sudo /home/mnipi/Linia.sh
    Hidden=false
    NoDisplay=false

        ~/Linia.sh:
    #!/bin/bash
    cd /home/mnipi/Linia/sources/generated/Linia2
    sudo ./Linia2

*** Ярлык ***
        ~/Desktop/Linia.destop:
    [Desktop Entry]
    Version=1.0
    Type=Application
    Name=Linia
    Comment=
    Exec=sudo /home/mnipi/Linia.sh
    Icon=
    Path=/home/mnipi/Linia/sources/generated/Linia2
    Terminal=true
    StartupNotify=false

*** Настройка сети без сохранения при выключении ***
    #!/bin/bash
    cat << EOF | sudo tee /etc/ssh/sshd_config > /dev/null
    Include /etc/ssh/sshd_config.d/*.conf
    Port 22
    AddressFamily inet
    ListenAddress 0.0.0.0
    PermitRootLogin yes
    PasswordAuthentication yes
    UsePAM yes
    AllowTcpForwarding yes
    X11Forwarding no
    AcceptEnv LANG LC_*
    Subsystem sftp /usr/lib/ssh/sftp-server
    EOF
    sudo ip addr flush dev enP3p49s0
    sudo ip link set enP3p49s0 up
    sudo ip addr add 192.168.1.100/24 dev enP3p49s0
    sudo ip route add default via 192.168.1.1
    echo "nameserver 8.8.8.8" | sudo tee /etc/resolv.conf > /dev/null
    sudo systemctl restart ssh
