Sasha7b9Work/Linia/doc/РД/Техническое задание на разработку ИППП4.docx

Категории тестируемых элементов:

диод – D:
ВАХ в прямом включении перехода Ia=F(Ua пр),
ВАХ в обратном включении перехода Ia = F(Ua обр);

резистор – R:
ВАХ резистора Ia=F(Ua);

конденсатор – С:
утечка конденсатора Ia=F(Ua);

трёхполюсный биполярный npn-транзистор (NPN):
IcVc - выходная характеристика транзистора Ic=F(Uc), при Ue=0, Ib от 1 до 10 мкА, 10 шагов, Uc от 1 до 10 В, Ic <= 75 mA,
Vce_for – пробивное напряжение коллектор-эмиттер в прямом включении (ОЭ) Ic=F(Uc), при Ue=0, база в обрыве (Ib=0), Uc от 0 до 50В, Ic<=30мкФ

трёхполюсный биполярный pnp-транзистор (PNP):
IcVc – Ib от -10 до -100 мкА,

трёхполюсный МОП-транзистор с n-каналом (NMOS);

трёхполюсный МОП-транзистор с p-каналом (PMOS);

четырёхполюсный биполярный npn-транзистор (NPN4);

четырёхполюсный биполярный pnp-транзистор (PNP4);

четырёхполюсный МОП-транзистор с n-каналом (NMOS4);

четырёхполюсный МОП-транзистор с p-каналом (PMOS4).
