Sasha7b9Work/Linia/doc/Отчёты/Подготовка Orange Pi 5 Plus к работе.docx

Подготовка платформы Orange Pi 5 Plus к работе.

В качестве операционной системы для установки выбрана Armbian Linux v6.12 на основе Ubuntu 24.04 XFCE от 22.11.2025. Причиной выбора явилось то, что данная система поддерживает всю необходимую функциональность платформы, обладает не самой плохой производительностью среди аналогичных операционных систем, а также допускает установку оболочки Chicago 95 для отображения графического интерфейса ПО «Линия 2» в минималистичном стиле Windows 95.

1. Возможности операционной системы Armbian на платформе Orange Pi 5 Plus.

Операционная система Armbian на платформе Orange Pi 5 Plus поддерживает все возможности Linux Ubuntu 24.04 Desktop, включая установку всех поддерживаемых приложений (Chrome, Open Office и т.д.).

Поддерживает имеющиеся на плате:

- 3 порта USB, допускающих подключение различных устройств с интерфейсом USB – мыши, клавиатуры, модули Wi-Fi и т.д.;

- разъём HDMI для подключения дисплея;

- разъём m2 для подключения диска SSD c интерфейсом NVME;

- слот для установки загрузочной карты micro-SD;

- разъём GPIO.

2. Установка операционной системы и ПО «Линия 2» на Orange Pi 5 Plus.

Для установки ОС на Orange Pi 5 Plus достаточно сделать копию с заранее подготовленной загрузочной карты micro-SD (с помощью программы Win32DiskImager) и установить её в слот на плате. После включения питания (и следующей после этого загрузки ОС) автоматически загружается ПО «Линия 2».

3. Подготовка загрузочной карты micro-SD.

Скачать загрузочный образ операционной системы со страницы Orange Pi 5 Plus сайта armbian.com (https://www.armbian.com/orange-pi-5-plus/, https://dl.armbian.com/orangepi5-plus/Noble_current_xfce).

С помощью программы Win32DiskImager записать образ на micro-SD карту объёмом 64 ГБ.

После включения питания начнётся загрузка системы.

После первой загрузки установить графическую оболочку Chicago 95. Для этого нужно выполнить следующую последовательность команд:

cd ~

git clone https://github.com/grassmunk/Chicago95

cd Chicago95

./installer.py

Установить ПО «Линия 2». Для этого нужно выполнить следующую последовательность команд:

cd ~

git clone https://github.com/Sasha7b9Work/Linia

cd Linia/sources/scripts/ThirdParty/lin/

./install_software.sh

./make_build.sh

cd ~

cd Linia/sources/scripts/cb_lin/

./install_soft.sh

./soft_arm64.sh

./full_build.sh

Загрузочная карта подготовлена и её можно использовать как для тиражирования, так и для работы.
