Sasha7b9Work/Linia/doc/РД/ИППП3/Aлгоритм   Линия-2/Aлгоритм измерения ВАХ диода .docx

Измерение ВАХ диода

В качестве примера приведена последовательность операций после появления сигнала ИЗМЕРЕНИЕ (кнопка «ИЗМЕРЕНИЕ» или внешний запуск).

Рассмотрим режим «Большой ток» (БТ).

На этапе подготовки к измерению необходимо:

1БТ - записать регистры блоков, например в следующем порядке:

- измеритель тока,

- формирователь развертки и измеритель напряжения (ЦАП, который входит в состав измерителя напряжения в качестве делителя сигнала, записывать одновременно с регистром),

- канал В,

- канал S,

- коммутатор

(в порядке обсуждения: коммутатор подключает гнезда В и S к выходам соответствующих каналов, только если заданы какие-нибудь параметры по этим каналам).

На этапе подготовки к измерениям в «динамические» ЦАПы (№1 в блоке формирователя развертки и №2 в блоке источника напряжения 50 В) ничего не записывают.

2БТ Проанализировать установленную полярность испытательных импульсов.

Если установлен диапазон +50В, то напряжение питания, регулируемое в этом режиме «динамическим» ЦАПом №1, должно на ≈15 В превышать напряжение испытательного импульса, формируемое ЦАПом №2.

Если установлен диапазон -50В, то напряжение питания, регулируемое в этом режиме «динамическим» ЦАПом №1, должно быть приблизительно на -25 В ниже отрицательного напряжения испытательного импульса, формируемого ЦАПом №2.

Определяют коды, которые должны быть записаны в «динамические» ЦАПы №1 и №2 для формирования 1го, 2го, 3го и всех последующих испытательных импульсов для получения искомой ВАХ диода, состоящей из 10ти, 20ти, 50ти или 100 точек, указанных оператором.

Величина дискрета для каждого из этих ЦАПов будет определена позже. Поскольку испытательные импульсы в режиме БТ формируют без синхронизации с сетью 50 Гц, можно сразу записать соответствующие коды в ЦАПы №1 и №2.

3БТ С этого момента начинают формировать интервал задержки между испытательными импульсами, величиной 0,4÷0,5сек, который используется для заряда конденсаторов до напряжения согласно ЦАП №1 и для охлаждения испытательной цепи и тестируемого диода.

После окончания интервала задержки ПЛИС должна сформировать импульс требуемой длительности из ряда 10 мкс, 20 мкс, 50 мкс, 100 мкс, и за 1 мкс до его окончания сигнал RUN для запуска 4-х АЦП.

После стробирования 1й точки ВАХ, в ЦАПы №1 и №2 записывают коды, соответствующие 2-му испытательному импульсу, а затем формируют интервал задержки между испытательными импульсами, величиной 0,4÷0,5сек для заряда конденсаторов.

Процесс измерения ВАХ по точкам длится до считывания с АЦП последней указанной оператором точки. Затем, измерения прекращают, если однократный режим, или начинают следующий цикл, если оператор выбрал многократный режим.

ЦАП_№2 ─ устанавливает напряжение канала С в режиме «Большого тока».

1 Проверить:

- соответствие диапазона измерения тока (канал С) выбранному типу развертки;
