Sasha7b9Work/Linia/doc/РД/ИППП3/Библиотека тестов/Структура  библиотеки.docx

Структура библиотеки стандартных тестов (Линия-2)

Режим Высокого напряжения
npn | | | pnp | | | n-МОП | | | р-МОП
Вид развертки | | | Вид развертки | | | Вид развертки | | | Вид развертки
SIN | DC | IMP | SIN | DC | IMP | SIN | DC | IMP | SIN | DC | IMP
Тесты | Тесты | Тесты | Тесты | Тесты | Тесты | Тесты | Тесты | Тесты | Тесты | Тесты | Тесты

Режим Высокого напряжения
БТИЗ(npn) | | | БТИЗ(pnp) | | | Двухполюсник
Вид развертки | | | Вид развертки | | | Вид развертки
SIN | DC | IMP | SIN | DC | IMP | SIN | DC | IMP
Тесты | Тесты | Тесты | Тесты | Тесты | Тесты | Тесты | Тесты | Тесты

Режим Большого тока
npn | pnp | n-МОП | р-МОП
Вид развертки | Вид развертки | Вид развертки | Вид развертки
IMP | IMP | IMP | IMP
Тесты | Тесты | Тесты | Тесты

Режим Большого тока
БТИЗ(npn) | БТИЗ(pnp) | Двухполюсник
Вид развертки | Вид развертки | Вид развертки
IMP | IMP | IMP
Тесты | Тесты | Тесты
