Sasha7b9Work/Linia/doc/РД/ИППП3/Aлгоритм   Линия-2/Aлгоритм  работы общий .docx

Алгоритм работы

1 Режимы работы и функциональные возможности анализатора

С точки зрения диапазонов и мощности испытательных сигналов, анализатор имеет два режима работы:

- режим «Высокого напряжения» (от 0 В до 3000 В), когда испытательный сигнал мощностью до 150 Вт формируют синхронно с переменным напряжением сети (50 Гц) с помощью трансформатора;

- режим «Большого тока» (от 0 В до 50 В) когда испытательный сигнал формируют в виде импульсов мощностью до 10 кВт с помощью конденсатора без привязки к сети (50 Гц).

В каждом из этих режимов анализатор обеспечивает два режима (алгоритма) проведения измерений:

- режим однократных измерений, запуск кнопкой «ИЗМЕРЕНИЕ» остановка по окончанию развертки. В этом режиме продолжительность измерения ВАХ минимальна, возможна автоматизация измерений (по внешнему запуску).

- режим многократных измерений (режим “Характериографа”), когда оператор визуально отслеживает изменение ВАХ при регулировке вручную напряжения испытательного сигнала, мощности, рассеиваемой на объекте испытаний в течение времени наблюдения, температуры объекта испытаний и т.д.

В режиме многократных измерений сигналы «СТАРТ», «Окончание развертки» и амплитуду испытательного сигнала канала С в режиме «Высокого напряжения» контроллер формирует по повороту рукоятки энкодера вправо или влево, возможен останов по нажатию на кнопку «СТОП».

В режиме однократных измерений сигнал «ИЗМЕРЕНИЕ» вырабатывается нажатием на кнопку «ИЗМЕРЕНИЕ» (внешним сигналом ПУСК), а в режиме многократных измерений его формирует контроллер при повороте ручки энкодера по часовой стрелке больше чем на 1 тик.

Нажатие на кнопку «СТОП» в режиме, как многократных измерений, так и однократных измерений ведет к прерыванию развертки ВАХ.

При этом:

- в режиме многократных измерений график и таблица должны соответствовать результатам предыдущего измерения ВАХ,

- в режиме однократных измерений график и таблица отображают точки ВАХ (фрагмент ВАХ) измеренные до прерывания развертки.

Поворот рукоятки энкодера по часовой стрелке ведет к увеличению напряжения канала С (увеличению кода в ЦАП №1 или ЦАП №2, см. далее). Поворот против часовой стрелки – соответственно к уменьшению напряжения канала С (уменьшению кода в ЦАП №1 или ЦАП №2).

При медленном вращении рукоятки напряжение канала С изменяется медленно, например на 0,5% (1%) от диапазона (код полного диапазона – 12-ть бит). При ускоренном вращении рукоятки напряжение изменяется быстрее, например на 2% (3%) от диапазона. При быстром вращении рукоятки напряжение изменяется большими шагами, например на 5% (10%) от диапазона. Величину шага определим экспериментально, по ощущениям оператора.

Кроме того, величина шага изменения напряжения в канале С (линейно) зависит от соотношения между установленным диапазоном источника напряжения и установленным диапазоном измерителя напряжения канала С. Ориентировочные значения в процентах, приведенные выше, относятся к случаю, когда значения этих диапазонов совпадают.

При уменьшении напряжения канала С (кода в в ЦАП №1 или ЦАП №2), за счет поворота ручки энкодера против часовой стрелки, до нуля развертку ВАХ заканчивают и измерение прекращают. На графике и в таблице – нули.

С точки зрения организации работы контроллера и компьютера, анализатор имеет два режима работы:

Режим «Ожидание» (режим ″отображения информации″), когда оператор работает с результатами предыдущего измерения (график, таблица, файл моделей измерения и т.д.), производит подключение/отключение объекта испытаний и установку параметров следующего измерения (теста). В этом режиме все каналы отключены от силовых гнезд C, В, S и формируют сигналы нулевого уровня.

Режим «Измерение» (режим ″накопления информации″) ─ измерение ВАХ объекта испытаний (диода или транзистора). [РЭ на ИППП-3 часть 2, главы 3, 4].

После включения питания анализатор находится в режиме ″Ожидание″.

В этом режиме возможна установка оператором «желаемых» диапазонов измерения в каналах С, В, S, и интересующего режима коммутатора с помощью соответствующих виртуальных панелей управления или путем выбора готового теста.

Указанные оператором «Желаемые» диапазоны и другие установки превратятся в «Реальные» только после записи соответствующих кодов в регистры и ЦАПы всех блоков согласно принципу «холодного переключения».

Моменты, когда возможна запись в регистры и в ЦАПы, определяет контроллер на основании сигналов «LINE» и «Сбор», с учетом задержки на время “дребезга” контактов.

Анализатор содержит 4 источника испытательных сигналов (канал С -200 Вт и 10 кВт, канал В – 20 Вт, канал S – 4 Вт), которые, при неправильном включении режима работы, способны вывести из строя не только объект испытаний, но и сам анализатор.

Поэтому алгоритм управления должен обеспечить:

- правильный выбор момента записи кодов в регистры и ЦАПы,

- проверку соответствия установленного режима анализатора и режимов каналов С, В, S,

- проверку отсутствия противоречий между «желаемыми» установками режимов измерителей и источников в каналах.

Принцип «холодного переключения»

Чтобы предотвратить разрушение анализатора, процесс записи новых кодов в регистры всех блоков должен удовлетворять принципу «холодного переключения», согласно которому переключение герконов (замыкание и размыкание) допустимо производить только при нулевом значении коммутируемого сигнала.

Поскольку момент записи в регистры и моменты начала (окончания) испытательного сигнала определяются контроллером, т.е. программно, принцип «холодного переключения» должен выполняться благодаря грамотной разработке и последующей увязке между собой отдельных частей программного обеспечения анализатора (ПЛИС, микропроцессор, компьютер).

Подобный принцип желательно использовать и при смене кода в ЦАПах любого канала – новое значение испытательного сигнала (новый код) устанавливают только при нулевом значении источника сигнала в канале С (на обмотках трансформатора, в паузе между импульсами), во всех режимах этого канала, включая режим DC. (В режиме DC постоянное напряжение сохраняется на сглаживающем конденсаторе.)

Длинные промежутки времени, когда можно производить запись в регистры и ЦАПы, расположены между короткими интервалами времени соответствующими сигналам «ENS» ( до 10 мс), когда только и может возникнуть испытательный сигнал.

Интервалы времени, когда можно производить запись, длятся от 40-60 мс в режиме «Высокого напряжения», до 400 мс в режиме «Большого тока». За это время можно записать все что надо во все регистры и ЦАПы.

После включения анализатора в сеть, в регистры и ЦАПы всех блоков необходимо записать нулевые коды, чтобы выходные напряжения всех источников (всех каналов) были равны нулю.

При появлении сигнала «ИЗМЕРЕНИЕ» вначале записывают коды, соответствующие режиму, установленному на виртуальной панели управления, в регистры всех каналов.

Можно предложить следующий порядок записи регистров:

- коммутатор,

- измеритель тока,

- формирователь развертки и измеритель напряжения,

- канал В,

- канал S.

- источник напряжения 3000В.

Запись кодов в ЦАПы выполняют через 4-5 мс после записи в регистры, поскольку дребезг контактов у герконов длится до 5 мс.

Порядок записи кодов в ЦАПы по сигналу «ИЗМЕРЕНИЕ» можно предложить следующий следующий:

1- измеритель напряжения, 2- формирователь развертки, 3- источник напряжения 50 В, 4- канал В, 5 - канал S.

После записи кодов в ЦАПы, через интервал не менее 1 мс в канале С (в канале В) можно начинать формирование развертки ВАХ с помощью сигналов:

- ENS Sin+/-, ENS АC, ENS DC+/-, ENS Imp+/-, IMPb+/-v, ─ в режиме «Высокого напряжения»,

- Impс+/-, Impb+/-i ─ в режиме «Большого тока».

Виды разверток в канале С рассмотрены далее.

Для формирования некоторых видов разверток, запись кодов в основные ЦАПы надо осуществлять в процессе измерения. К ним относятся следующие ЦАПы.

ЦАП_№1 в блоке формирователя развертки ─ устанавливает напряжение канала С в режиме «Высокого напряжения».

ЦАП_№2 в блоке источника напряжения 50 В ─ устанавливает напряжение канала С в режиме «Большого тока».

В режиме многократных измерений этими ЦАПами управляют вручную с помощью энкодера, а в режиме однократных измерений значения кодов формируют программно.

ЦАП_№3 в канале В ─ устанавливает ток базы или напряжение затвора тестируемого транзистора при измерении семейства ВАХ.

ЦАП_№4 в канале S ─ устанавливает ток или напряжение при измерении семейства ВАХ, связанного с воздействием на подложку или «карман» тестируемой полупроводниковой структуры.

В остальных ЦАПах (измеритель напряжения, канал В, канал S) изменение кодов в процессе измерения не предусмотрено.

Запись новых кодов в основные ЦАПы (№1, №2, №3, №4,) в процессе измерения выполняют только на тех интервалах времени, которые удовлетворяют определенным условиям:

- 1 испытательный сигнал в канале С имеет нулевое значение,

- 2 испытательный сигнал в канале В, при тестировании транзистора, имеет стационарное (не импульсное) значение, даже на импульсных развертках (см. Принцип «холодного переключения»).

В режиме «Высокого напряжения» такие интервалы соответствуют:

- отсутствию сигналов ENS Sin+/-, ENS АC, ENS Imp+/- на развертках Sin+, Sin-, AC, Imp+, Imp-,

- отсутствию сигнала СБОР на развертках DC+, DC-,

[файл _Fорм.испыт.сигн. Испр.диагр.(диод,тр-р) от 07.10.2025].

В режиме «Большого тока» такие интервалы соответствуют отсутствию сигналов IMPC+i / IMPC-i в режиме диода (10, 20, 50 и 100 мкс) и в режиме транзистора, импульсы в канале В IMPb+i / IMPb-i, например, как показано на рисунке ниже. [файл 3е доп.Имп.разв.для тест.транзистора от 10.10.2025].

Рисунок 1. Диаграммы сигналов IMPc +/-(10мс), IMPB+/- и EIMP (20мс) при тестировании ТРАНЗИСТОРА с помощью импульсной развертки в режиме «Большой ток». (Сигнал EIMP уже не актуален, но из рисунка пока не изъят)

А) При формировании ступенчатой развертки 2й очереди в каналах В и S необходимо записывать в соответствующий ЦАП новые значения кода в процессе проведения измерений.

Б) При некоторых видах разверток, например логарифмической развертки 2й очереди, упоминаемой далее, может понадобиться запись кода в один из регистров в процессе проведения измерений, когда анализатор работает в режиме однократных измерений или многократных измерений, а в канале С формируется любой из возможных видов развертки.

Для соблюдения принципа «холодного переключения» и учитывая сценарии А) и Б), общее правило записи новых кодов в регистры и ЦАПы будет следующим.

Величину задержки между окончанием испытательного сигнала в канале С и моментом начала записи кода в регистры и ЦАПы формируют для каждого вида развертки с помощью сигналов ENS или Сбор, в зависимости от того какой из них заканчивается при данной развертке позже.

Интервал между соседними одноименными сигналами ENS или Сбор для разных разверток колеблется от 40 мс до 400 мс.

Далее рассмотрены особенности построения алгоритма управления анализатором в различных режимах работы и при различных видах развертки.

2 Развертки ВАХ, общая информация.

Развертка, которая используется для измерения одной линии ВАХ, является разверткой 1й очереди. Развертка, которая позволяет измерить «семейство ВАХ», то есть несколько линий ВАХ полученных с помощью развертки 1й очереди, является разверткой 2й очереди.

По длительности одна ступень развертки 2й очереди соответствует полной развертке (полному циклу) 1й очереди. После окончания развертки 1й очереди включают следующую ступень развертки 2й очереди.

Как правило, развертку 1й очереди формируют в канале С, а развертку 2й очереди ─ в канале В.

Развертка 1й очереди в канале С может быть непрерывной, например в режиме SIN+\-(синусоидальная), или ступенчатой, например, в режиме DC или в импульсном режиме.

Ступенчатую развертку в канале В формируют программно, она может быть линейной или логарифмической (например при измерении β).

Ступенчатую развертку в канале С формируют линейную в режиме постоянного (сглаженного) и импульсного испытательного сигнала в режиме однократных измерений (программно) и ─ произвольную в режиме многократных измерений (вручную).

Развертку 2й очереди в каналах В и S, как правило, формируют ступенчатой, при этом все линии в семействе ВАХ раздельные и подтверждаются при повторных измерениях.

В некоторых случаях, например при измерении коэффициента β биполярных транзисторов, развертку 1й очереди целесообразно формировать в канале В, а развертку 2й очереди, при необходимости, в канале С.

3 Развертки в канале С в режиме «Высокого напряжения»

1 Полусинусоида (+SIN и -SIN) или пульсирующее напряжение используется в качестве развертки ВАХ при тестировании объектов средней мощности. Получают путем однополупериодного выпрямления напряжения сети 50 Гц после мощного выходного (понижающего/повышающего) трансформатора.

Достоинства ─ высокая скорость измерения ВАХ.

Недостатки – большое выделение тепла в объекте тестирования и в самом измерителе при увеличении мощности испытательного сигнала, – искажения ВАХ в виде «петли» при тестировании высокоомных объектов.

На рисунке 1 в качестве примера приведена развертка пульсирующим (выпрямленным) сигналом SIN+.

Рисунок 1. Развертка SIN+

Из диаграмм, приведенных на рис.1 в файле [_Fорм.испыт.сигн.Испр.диагр. (диод,тр-р) от 07.10.2025] видно, что для разверток SIN+, Sin- и AC сигнал ENS длится на 5 мс дольше, чем сигнал Сбор. Следовательно, для соблюдения принципа «холодного переключения», на этих развертках задержка записи в регистры (и в ЦАПы) должна быть организована с задержкой относительно среза сигнала ENS.

2 Постоянное напряжение (+DC и -DC) формируется путем сглаживания полусинусоиды с помощью конденсатора, как показано на рисунке 2. Ступенчатую развертку ВАХ постоянным напряжением осуществляют вручную с помощью энкодера или программно. Эту развертку используют при тестировании высокоомных объектов.

Достоинства ─ высокая точность, отсутствие искажений, в виде «петли».

Недостатки – большое выделение тепла в объекте тестирования и в самом измерителе при увеличении мощности испытательного сигнала.

При программном формировании развертки, контроллер рассчитывает величину шага исходя из заданных уровней «Старт» и «Стоп» и заданного количества шагов, например 100.

Измерение мгновенных значений напряжения при развертке DC осуществляют на сглаженном участке, см. рисунок 2, приблизительно через 2-2,5 мс после вершины синусоиды, это 140й – 150й RUN. Чтобы снизить влияние случайных помех и наводок запоминают 16-ть последовательных мгновенных значений, например от 140го до 156го, и усредняют их.

Рисунок 2. Ступенчатая развертка DC+, N – количество ступеней.

Для разверток DC+, DC-, когда сигнал ENS накрывает множество периодов сети, задержка записи в регистры (и в ЦАПы) должна быть организована с задержкой относительно среза сигнала Сбор, который является «внутренним» сигналом ПЛИС.

3 Импульсная развертка в канале С используется для тестирования мощных диодов или других двухполюсников.

Ступенчатую развертку ВАХ импульсным напряжением осуществляют вручную с помощью энкодера, в режиме многократного запуска, или программно в режиме однократного запуска (см РП на ИППП-3).

Достоинства ─ минимальное выделение тепла в объекте тестирования и в самом измерителе при увеличении мощности испытательного сигнала.

Недостатки – невысокая скорость измерения ВАХ (0,4 – 1 сек на точку), наличие динамических погрешностей из-за быстрого изменения формы испытательного сигнала в момент измерения.

В режиме «Высокого напряжения» импульсы в канале С формируют с помощью сигналов ENS Imp и трансформатора из напряжения сети, как показано на рисунке 3.

В данном случае, задержка записи в регистры (и в ЦАПы) должна быть организована относительно среза второго импульса ENS Imp+.

Рисунок 3. Диаграммы сигналов ENS Ipm+ в режиме «Высокого напряжения»

Начальный «Старт» и конечный «Стоп» фрагменты ступенчатой импульсной развертки в канале С показаны на рисунке 4.

При программном формировании развертки, контроллер рассчитывает величину шага (добавляемого к коду в ЦАПе) исходя из заданных уровней «Старт» и «Стоп» и заданного количества шагов, например 100.

Измерение мгновенных значений напряжения при импульсной развертке в канале С осуществляют через 100 мкс после вершины синусоиды (102 RUN).

Рисунок 4. Ступенчатая развертка Ipm+ в канале С в режиме «Высокого напряжения»,

N – количество ступеней.

Два режима работы анализатора ВАХ.

1 Режим «Ожидание» (режим ″отображения информации″): оператор работает с результатами предыдущего измерения (график, таблица, файл моделей измерения и т.д.) или производит подключение/отключение объекта испытаний и установку параметров следующего измерения (теста). В этом режиме все каналы должны формировать сигналы нулевого уровня и должны быть отключены от силовых гнезд C, В, S.

2 Режим «Измерение» (режим ″накопления информации″) ─ измерение ВАХ объекта испытаний (диода или транзистора). [РЭ на ИППП-3 часть 2, главы 3, 4].

После включения питания анализатор находится в режиме ″Ожидание″.

В этом режиме возможна установка «желаемых» диапазонов измерения в каналах С, В, S, и режима коммутатора с помощью соответствующих виртуальных панелей управления.

«Желаемые» диапазоны и другие установки превратятся в «Реальные» только после записи соответствующих кодов в регистры и ЦАПы каждого блока согласно принципу «холодного переключения».

Моменты, когда возможна запись в регистры и в ЦАПы, определяет контроллер на основании сигналов «LINE» и «Сбор», с учетом обязательной задержки начала измерений, после записи кодов в регистры, на время “дребезга” контактов.

Запись новых данных в «динамические» ЦАПы (2 шт) осуществляется в процессе (режиме) измерения, запись данных в остальные ЦАПы – только в режиме ″накопления информации″ («холодная запись»).

Моменты записи новых данных в «динамические» ЦАПы также определяет контроллер, поскольку длительность полного цикла формирования испытательного сигнала, включая паузу, также кратна периоду сети.

Режим “Измерение” включает два независимых режима измерения ВАХ:

- режим многократных измерений ВАХ (режим многократной развертки);

- режим однократных измерений ВАХ (режим однократной развёртки).

В режиме многократных измерений график ВАХ на экране анализатора динамически отслеживает плавную регулировку, ручкой “РЕГУЛИРОВКА Uc,%”, максимального напряжения развертки. В этом режиме можно визуально оценить поведение ВАХ в зависимости от максимального напряжения развертки и других влияющих факторов, например, времени, температуры и д.р. Режим многократных измерений включается поворотом ручки “РЕГУЛИРОВКА Uc,%”, по часовой стрелке.

Прекращение измерений в режиме многократных измерений происходит либо при уменьшении ручкой “РЕГУЛИРОВКА Uc,%”, максимального напряжения развертки до нулевого уровня, либо при нажатии на кнопку СТОП. В последнем случае на экране анализатора должно отображаться последнее измеренное значение ВАХ, которое может быть использовано для проведения расчетов, сохранения в электронном виде или передачи на внешний компьютер.

В режиме однократных измерений измерение ВАХ происходит либо при нажатии на кнопку “ИЗМЕРЕНИЕ”, либо по внешнему сигналу, поступающему на вход “ПУСК” анализатора. В этом режиме измерение ВАХ происходит быстрее, чем в режиме повторяющейся развертки. После окончания развертки анализатор переходит в режим “Ожидание”.

Запуск режима однократной развертки внешним сигналом позволит использовать анализатор в составе автоматизированной системы, включающей, например, зондовую установку. Результаты измерений сохраняются в отдельном файле.
