Sasha7b9Work/Linia/doc/РД/ИППП3/Aлгоритм   Линия-2/Концепц.постр.анализатора ВАХ.docx

2.1 Концепция построения и алгоритм работы анализатора ВАХ ПП

Концепция построения силового анализатора ВАХ ПП основана на трех базовых принципах:

- в режиме высокого напряжения (до нескольких тысяч Вольт), измерение ВАХ обеспечивается с помощью формирования испытательного сигнала синхронного с переменным напряжением сети (50 Гц) с помощью трансформатора;

- в режиме большого тока, (до нескольких сотен Ампер) измерение ВАХ обеспечивается с помощью формирования импульсов испытательного сигнала с помощью конденсатора;

- измерение ВАХ с помощью испытательного сигнала с ненулевым спектром, например, с помощью импульсов синусоидальной или иной формы, обеспечивается путем измерения мгновенных значений сигналов тока и напряжения, воздействующих на электроды объекта подверженного испытаниям (ОПИ).

Кроме того, в концепцию построения силового анализатора ВАХ ПП включены следующие условия.

Алгоритм работы силового анализатора основан на использовании переменного напряжения сети частотой 50ºГц для формирования испытательного сигнала развертки в диапазонах 30 В, 300 В и 3000 В с минимальными потерями энергии на промежуточные преобразования. Поэтому, все процессы формирования и измерения испытательных сигналов на электродах ОПИ должны быть синхронизированы с переменным напряжением сети.

Для исключения остаточного намагничивания сердечника трансформатора формирующего испытательный сигнал, изменение режима его работы производится с интервалом кратным периоду сети.

Переключение электромеханических реле и герконов осуществляется только при отсутствии сигналов тока или напряжения в замыкаемой (размыкаемой) цепи – так называемое “холодное переключение”.

Для выполнения этого условия, алгоритм работы анализатора должен включать следующие интервалы задержки:

- интервал задержки для синхронизации момента времени, начиная с которого разрешается переключение реле, с переменным напряжением сети, так как длительность полного цикла формирования испытательного сигнала должна быть кратна периоду сети.

- интервал задержки на время “дребезга” контактов реле.

- интервал задержки для синхронизации начала развертки (начала измерений) с переменным напряжением сети.

Общая продолжительность перечисленных интервалов задержки (на синхронизацию с сетью до переключения реле, на время “дребезга” контактов и на синхронизацию с сетью перед началом измерений) не может быть менее периода сети. То есть, при частоте 50τГц и длительности периода 20τмс, величина задержки составит от 20 до 40ºмс. Кроме того, в режиме DC, алгоритм работы анализатора должен учесть задержку, связанную с конечным значением времени нарастания напряжения в измерительной цепи, которое увеличивается с увеличением сопротивления внутреннего датчика тока и сопротивления ОПИ.

При неоднократном переключении реле в процессе измерения ВАХ, затраты времени, с учетом перечисленных интервалов задержки, значительно возрастают. Поэтому, согласно выработанной концепции, режим работы измерительных каналов, связанный с переключением реле, изменяют только до начала формирования развертки.

Это отличает алгоритм работы силового анализатора ВАХ ПП от алгоритма работы анализаторов ВАХ ПП малой мощности, формирующих сигнал развертки без привязки к частоте сети, и затрудняет реализацию в силовом анализаторе алгоритма автоматического выбора пределов измерения, связанного с неоднократным переключением герконов.

Временные диаграммы испытательного сигнала в канале С в разных режимах развертки, поясняющие алгоритм работы силового анализатора ВАХ, представлены на рисунке 2.2.

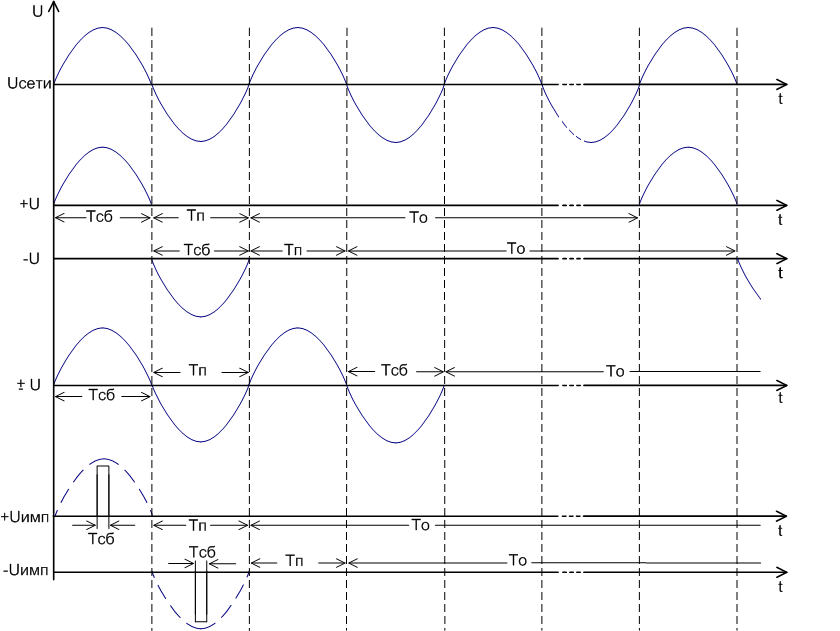
[picture p90: figure]

Здесь: Uсети – переменное напряжение сети; +U, -U – однополярные импульсы испытательного сигнала синусоидальной формы положительной и отрицательной полярности; ± U – двухполярный испытательный сигнал синусоидальной формы; +Uимп, -Uимп – однополярные импульсы испытательного сигнала прямоугольной формы положительной и отрицательной полярности; Тсб – интервал времени, в течение которого осуществляется сбор измерительной информации; Тп – длительность выпрямленной полуволны; То – интервал времени, в течение которого осуществляется обработка данных (время ожидания).

Рисунок 2.2 - Временные диаграммы испытательного сигнала в канале С в зависимости от режима развертки.

Силовой анализатор должен обеспечить защиту измерительной цепи и ОПИ от перегрузки по току, напряжению и мощности, а также обеспечить запоминание и сохранение измеренных данных (кривой ВАХ) и режима измерения, в случае пробоя ОПИ в процессе измерений.

При развертке ВАХ с помощью испытательного сигнала сложной формы, например, синусоидальным напряжением, выпрямленным синусоидальным напряжением, сглаженным напряжением с пульсациями или импульсами возрастающей амплитуды, измерение мгновенных значений сигналов тока и напряжения во всех каналах анализатора необходимо осуществлять в один и тот же момент времени.

Канал С содержит два широкополосных АЦП с устройствами выборки/хранения на входе, один из которых предназначен для измерения мгновенных значений напряжения развертки, а другой – мгновенных значений выходного тока, протекающего через ОПИ. Каналы В и S содержат по одному широкополосному АЦП с устройством выборки/хранения, который может использоваться для измерения либо тока, либо напряжения.

Каналы B и S формируют постоянное значение испытательного сигнала (тока или напряжения), при измерении единственной линии (графика) ВАХ, или ступенчато нарастающий испытательный сигнал, при измерении семейства ВАХ.

После включения питания и после окончания процесса измерения анализатор автоматически устанавливается в режим “Ожидание”, который предназначен для выбора и установки режимов его работы, подключения или отключения ОИ, работы с таблицей, с файлами и т.д. В этом режиме все каналы отключены от силовых гнезд C, В, S и формируют сигналы нулевого уровня.

Функциональная схема силового анализатора ВАХ, разработанная согласно принятой концепции, представлена на рисунке 2.3. В качестве ОПИ показан биполярный транзистор, подключенный к каналам C, B, E по двухпроводной схеме.

Рисунок 2.3 – Функциональная схема силового анализатора ВАХ ПП.

Силовой анализатор ВАХ ПП содержит три измерительных канала C, B, S и канал нулевого потенциала E (канал эмиттера). Это обеспечивает измерение ВАХ двух-, трех- и четырехполюсников. Формирование и измерение напряжений в измерительных каналах осуществляется относительно нулевого потенциала канала Е.

Режим “Измерение”, когда на гнездах C, В, S присутствует испытательный сигнал, может быть разделен на два независимых режима измерения ВАХ:

- режим характериографа или режим многократных измерений ВАХ (режим многократной развертки);

- режим однократных измерений ВАХ (режим однократной развёртки).

В режиме характериографа график ВАХ на экране анализатора динамически отслеживает плавную регулировку, ручкой “РЕГУЛИРОВКА Uc,%”, максимального напряжения развертки. В этом режиме можно визуально оценить поведение ВАХ в зависимости от максимального напряжения развертки и других влияющих факторов, например, времени, температуры и д.р. Режим характериографа включается поворотом ручки “РЕГУЛИРОВКА Uc,%”, по часовой стрелке.

Прекращение измерений в режиме характериографа происходит либо при уменьшении ручкой “РЕГУЛИРОВКА Uc,%”, максимального напряжения развертки до нулевого уровня, либо при нажатии на кнопку СТОП. В последнем случае на экране анализатора отображается последнее измеренное значение ВАХ, которое может быть использовано для проведения расчетов, сохранения в электронном виде или передачи на внешний компьютер.

В режиме однократных измерений измерение ВАХ происходит либо при нажатии на кнопку “ИЗМЕРЕНИЕ”, либо по внешнему сигналу, поступающему на вход “ПУСК” анализатора, после чего результат измерения отображается на экране анализатора. В этом режиме измерение ВАХ происходит быстрее, чем в режиме характериографа. После окончания развертки анализатор переходит в режим “Ожидание”.

2.2 Функциональная схема канала коллектора

Канал C (канал коллектора) включает формирователь развертки, источник напряжения 3000 В, выполненный на основе трансформатора, источник напряжения 50 В, выполненный на основе конденсатора и измерители мгновенных значений напряжения Uc и тока Ic, показанные в составе канала C на функциональной схеме анализатора рис. 2.3.

В зависимости от выбора режима измерения ВАХ, в частности, режима высокого напряжения или режима большого тока, источник напряжения реализует различные методы формирования испытательного сигнала.

При формировании испытательного сигнала в режиме высокого напряжения, источник напряжения реализует схему формирования испытательного сигнала с помощью трансформатора, а при формировании испытательного сигнала в режиме большого тока, – с помощью конденсатора. Эти режимы устанавливают с помощью переключателя типа “PUSH - PULL”, расположенного на передней панели анализатора.

Однополярный испытательный сигнал развертки в режиме высокого напряжения формируют в виде полуволн напряжения синусоидальной формы, в виде последовательности импульсов возрастающей амплитуды прямоугольной формы, разделенных интервалами длительностью не менее трех периодов сети, и в виде нарастающих ступеней постоянного напряжения с пульсациями. Постоянное напряжение получают выпрямлением переменного напряжения сети и сглаживания с помощью конденсатора.

В режиме большого тока канал С обеспечивает формирование испытательного сигнала развертки только в виде последовательности импульсов напряжения возрастающей амплитуды прямоугольной формы, разделенных интервалами длительностью не менее 0,5 секунды.

Развертка ВАХ формируется за счет изменения напряжения испытательного сигнала по некоторому закону в течение времени измерения ВАХ. Поэтому, испытательный сигнал в виде синусоиды или полусинусоиды, когда испытательное напряжение изменяется в процессе измерения от минимума до максимума и обеспечивает измерение координат множества точек ВАХ, представляет собой уже сформированную развертку.

Чтобы сформировать развертку ВАХ с помощью испытательного сигнала, представленного в виде постоянного напряжения, необходимо обеспечить изменение его уровня в течение времени измерения ВАХ, например, путем регулировки вручную или под управлением компьютера по линейному закону.

При формировании испытательного сигнала в виде импульсов прямоугольной формы, измерение мгновенных значений тока и напряжения, используемых в качестве координат измеряемой точки ВАХ, производится на плоском участке вершины импульса (перед её окончанием).

Развертку ВАХ импульсами прямоугольной формы обеспечивают путем формирования последовательности импульсов возрастающей амплитуды, путем её регулировки вручную или под управлением компьютера по линейному закону.

При измерении ВАХ, значения испытательного напряжения канала С воздействующего на ОПИ, и выходного тока канала С протекающего через ОПИ определяют с помощью цифровых измерителей напряжения и тока, согласно функциональной схеме канала С, представленной на рисунке 2.4.

Цепи питания изолированных узлов: ОВВ – общий высоковольтный, +ºВВ – положительный высоковольтный,ºВВ – отрицательный высоковольтный. Uр – напряжение развертки

Рисунок 2.4 – Функциональная схема канала С

Изолированный источник питания служит для питания изолированных узлов измерителя тока и содержит отдельный сетевой трансформатор с напряжением изоляции до 10ºкВ. Общий провод изолированного источника питания (ОВВ) подключен к выходу источника напряжения развертки, выходное напряжение Uр которого изменяется в диапазоне ±3000ºВ.

Повторитель напряжения, выполненный на ОУ, исключает погрешность падения напряжения на датчике тока за счет протекания входного тока измерителя напряжения и обеспечивает измерение напряжения непосредственно на коллекторе (стоке) ОПИ во всем диапазоне напряжений.

Источник напряжения развертки обеспечивает формирование испытательного сигнала при измерении ВАХ в режиме высокого напряжения (±3000ºВ, ±10ºА) или в режиме большого тока (±50ºВ, ±100ºА).

На рисунке 2.5 представлена структурная схема канала С, на которой частично раскрыто внутреннее устройство блоков, упомянутое ранее.

Рисунок 2.5 – Функциональная схема канала С

Независимо от вида формируемой развертки, трансформаторный источник напряжения обладает сравнительно большим внутренним сопротивлением и величина выходного напряжения воздействующего на ОПИ весьма заметно зависит от величины выходного тока, протекающего через ОПИ. Поэтому, значение испытательного напряжения при любом виде развертки устанавливают не в вольтах, а в процентах от верхнего предела установленного диапазона напряжения развертки.

Измеритель тока преобразует в цифровой код мгновенные значения падения напряжения, выделяющегося на датчике тока в результате протекания через него того же тока, который протекает через ОПИ. Измерение падения напряжения (тока) осуществляется относительно общего высоковольтного провода, объединенного с выходом источника напряжения развертки, как показано на рисунках 2.4, 2.5. Гальваническая изоляция (до 10ºкВ) измерителя тока обеспечивается с помощью оптоинтерфейса, который выполнен на 2-х изолированных платах.

Установку диапазона измерения тока в режиме высокого напряжения осуществляют согласно ряду 1, 100, 10000º… путем переключения датчиков тока (резисторов) с помощью электромеханических контактов (герконов). В режиме большого тока используется один шунт (диапазон 200 A), полярность тока через который определяется положением упомянутого ранее переключателя “PUSH - PULL”, как показано на рисунке 2.5

При формировании испытательного сигнала в режиме высокого напряжения, источник напряжения реализует схему формирования испытательного сигнала с помощью 2-х трансформаторов, приведенную на рисунках 2.5 иº2.6.

Первый трансформатор обеспечивает изоляцию испытательного сигнала и электронной схемы его регулирования от сети. Искажения синусоидальной формы, присущие сетевому напряжению, устраняют с помощью полосового фильтра см. рис. 2.6.

Сигнал синусоидальной формы поступает через электронный переключатель (рис. 2.6) на регулируемый усилитель мощности, который используется для плавной регулировки амплитуды испытательного напряжения и обеспечивает максимальную мощность испытательного сигнала до 250ºВА.

Рисунок 2.6 – Схема формирования испытательного сигнала напряжения

с помощью 2-х трансформаторов.

Электронный переключатель на входе регулируемого усилителя мощности позволяет воплотить концепцию защиты силового канала (канала коллектора) от перегрузки без применения комплекта переключаемых токоограничивающих резисторов, что существенно снижает материальные затраты.

Согласно разработанному методу ограничения выходного тока (мощности) испытательного сигнала напряжения, измеритель тока, кроме выполнения своей основной функции, сравнивает в аналоговом виде значение выходного тока с пороговым уровнем. При превышении выходным током канала С предельного значения установленного диапазона в 2,5 раза, электронный переключатель подключает вход усилителя к общему проводу, как показано на рисунке 2.6.

Задержка срабатывания цепи управления переключателем составляет около 2х микросекунд. Таким образом, источник напряжения канала С защищен как от последствий внезапного пробоя установленного ОПИ, так и от ошибочных действий оператора.

Разработанный метод используется также для защиты каналов В и S от высокого напряжения при внезапном пробое ОПИ, что очень важно при тестировании современных высоковольтных MOSFET и IGBT транзисторов. Для этого каналы В и S, снабжены соответствующими детекторами превышения предельного значения установленного диапазона напряжения.

Схема коммутации испытательного сигнала с помощь электромеханических реле в диапазонах напряжения 30 В, 300 В и 3000 В, показана на рисунке 2.6 и выполнена на однополюсных реле (герконах).

В режиме высокого напряжения, источник напряжения развертки формирует испытательный сигнал синусоидальной формы путем однополупериодного выпрямления переменного напряжения регулируемой амплитуды с выхода трансформатора, как показано на рисунке 2.6, что соответствует требованиям стандартов по методам испытаний силовых полупроводниковых приборов.

Для формирования однополярного испытательного сигнала в некотором диапазоне, замыкают соответствующий электромеханический ключ, а для формирования сигнала синусоидальной формы – оба ключа, подсоединенные к соответствующему отводу вторичной обмотки выходного трансформатора. Схема обеспечивает одновременное переключение диапазонов напряжения испытательного сигнала и переключение его полярности, что позволяет сократить количество используемых реле.

В режиме большого тока испытательный сигнал формируют с помощью конденсатора. Схема формирования испытательного сигнала напряжения, в виде импульсов положительной полярности, с помощью конденсатора представлена на рисункеº2.7.

Рисунок 2.7 – Схема формирования испытательного сигнала напряжения

с помощью конденсатора.

Напряжение со вторичной обмотки трансформатора выпрямляется с помощью диода VD и заряжает электролитический конденсатор С большой емкости. Разряд конденсатора током, протекающим через ОПИ, происходит с помощью мощного МОП транзистора, который работает в линейном режиме под управлением ОУ.

Прямоугольные импульсы регулируемой амплитуды положительной полярности, поступающие на вход ОУ и управляющие работой всего устройства, вырабатывает блок формирования, показанный на рисункеº2.6.

Благодаря обратной связи, ОУ поддерживает в течение импульса напряжение Uн на истоке МОП транзистора, а значит и на ОПИ, в соответствии с амплитудой выходного импульса блока формирования учитывая коэффициент усиления ОУ (К=R2/R1).

Таким образом, испытательный сигнал, воздействующий на ОПИ, формируют в виде прямоугольных импульсов, время нарастания которых определяется быстродействием ОУ и МОП транзистора, а параметры плоской вершины – соответствующими параметрами ОУ и генератора импульсов.

Максимальное значение тока Iн, протекающего через ОПИ, определяется емкостью конденсатора Сн, длительностью формируемого импульса, допустимой величиной изменения напряжения на конденсаторе в течение импульса (допустимой величиной разряда конденсатора) и параметрами МОП транзистора.

Особые требования предъявляются к параметрам электролитического конденсатора Сн, который должен обеспечить не только требуемое значение разрядного тока в течение длительности импульса при допустимом значении падения напряжения на внутреннем сопротивлении конденсатора, но и низкое тепловое сопротивление, для рассеивания выделяемой на нем тепловой энергии.

Выбор вида развертки в канале С осуществляют путем включения одного из семи переключателей:

Режим формирования испытательного сигнала напряжения в диапазоне напряжения ±50 В при выходном токе до 200 А с помощью конденсатора.

В этом режиме силовая цепь источника напряжения состоит из накопительного конденсатора, полевого МОП-транзистора и нагрузки, в качестве которой обычно выступает ОПИ.

В течение прямоугольного импульса напряжения, поступающего на затвор МОП транзистора, происходит разряд накопительного конденсатора. Точное значение напряжения на нагрузке обеспечивается с помощью глубокой ООС, которой охвачены МОП транзистор и ОУ с высоким коэффициентом усиления. Схема разработанного источника канала коллектора, формирующего мощные импульсы напряжения с помощью конденсатора, приведена ранее на рисунке 2.7.

Величина протекающего прямоугольного импульса тока определяется напряжением формируемого импульса и сопротивлением нагрузки. Для снижения рассеиваемой мощности в каждом из элементов силовой цепи источника напряжения и в нагрузке, которая также является элементом этой цепи, сокращают длительность импульсов и увеличивают их скважность. Например, скважность формируемых импульсов длительностью 100 мкс при длительности интервала между ними 1 с, составит 10000.

Максимальный постоянный ток используемого МОП транзистора (IXFN 180N20) в ключевом режиме равен 180 А, а его максимальный импульсный ток - 720 А. При этом, допустимая длительность импульса ограничена температурой кристалла, которая определяется рассеиваемой на транзисторе мощностью. То-есть, допустимое значение импульсного тока через транзистор зависит от длительности импульсов, их скважности и падения напряжения на канале транзистора в течение импульса.

При формировании с помощью МОП транзистора прямоугольных импульсов заданной амплитуды, транзистор работает не в ключевом, а в линейном режиме. Падение напряжения на канале МОП транзистора в течение импульса определяется разностью между напряжением питания и напряжением на нагрузке.

Для формирования, с помощью МОП транзистора прямоугольных импульсов напряжения заданной амплитуды и большой мощности (большого тока), необходимо дополнительно осуществлять регулировку напряжение питания транзистора, чтобы обеспечить снижение рассеиваемой на нем мощности, то есть более “комфортные” условия для МОП транзистора.

Напряжение питания транзистора необходимо регулировать так, чтобы обеспечить работу транзистора в линейном режиме, при формировании импульса напряжения заданной амплитуды на внешней нагрузке, конкретное сопротивление которой неизвестно. То есть, напряжение питания МОП транзистора должно, по сути дела, отслеживать и амплитуду импульсов напряжения, которую изменяют по известному закону для развертки измеряемой ВАХ, и амплитуду импульсов тока, которая определяется сопротивлением нагрузки в измеряемой точке ВАХ.

В общем случае, сопротивление нагрузки, например ОПИ, изменяется по нелинейному закону вплоть до короткого замыкания в случае пробоя или неправильного подключения. При этом, если разогрев кристалла транзистора за время импульса превысит допустимый порог, произойдет его необратимый пробой, и силовой анализатор, в состав которого входит этот транзистор, выйдет из строя.
