Sasha7b9Work/Linia/doc/РД/ИППП3/Aлгоритм   Линия-2/1b_Fорм.испыт.сигн. Испр.диагр.(диод,тр-р) .docx

1 Виды разверток ВАХ, форма испытательных сигналов, в режиме «Высокого напряжения» (±30 В, ±300 В, ±3000 В)

Постоянное напряжение (+DC и -DC), в виде ступенчатой развертки ВАХ используется при тестировании высокоомных объектов.

Достоинства ─ высокая точность, отсутствие искажений, в виде «петли».

Недостатки – большое выделение тепла в объекте тестирования и в самом измерителе при увеличении мощности испытательного сигнала.

Полусинусоида (+SIN и -SIN) или пульсирующее напряжение используется в качестве развертки ВАХ при тестировании объектов средней мощности. Получают путем однополупериодного выпрямления напряжения сети 50 Гц.

Достоинства ─ высокая скорость измерения (полная ВАХ за 10 мс), возможность увеличения максимального тока через объект (мгновенной мощности на объекте) за счет сокращения времени воздействия максимального тока (форма сигнала) и за счет увеличения скважности сигнала (однополупериодное выпрямление). Скважность испытательного сигнала дополнительно увеличивают за счет удлинения интервала между полусинусоидами, как в ИППП-3. Благодаря отображению запомненного графика ВАХ, это не приводит к мерцанию изображения.

Недостатки – размытие графика ВАХ наводками из сети, появление искажений ВАХ в виде «петли» (искажения сигналов тока и напряжения по фазе), особенно в диапазоне малых токов и больших напряжений.

Знакопеременный пульсирующий сигнал (АС) состоит из пары полусинусоид (+SIN и -SIN), которые суммируются путем поочередного однополупериодного выпрямления. Знакопеременная развертка ВАХ используется для тестирования стабилитронов. Этой развертке присущи те же достоинства и недостатки, что и предыдущей.

Импульсный испытательный сигнал (+IMP и -IMP) используется для ступенчатой развертки ВАХ по точкам.

Эта развертка позволяет:

- при формировании импульсов в канале С тестировать мощные диоды,

- при формировании импульсов в канале В тестировать мощные транзисторы

во всем диапазоне допустимых токов и напряжений, благодаря кратковременному выделению мощности. Длительность импульсов составляет:

- 0,2 мс в диапазоне 0 ÷ ±30 В,

- 0,5 мс в диапазоне 0 ÷ ±300 В,

- 1 мс в диапазоне 0 ÷ ±3000 В).

Недостатки – низкая скорость измерения ВАХ, поскольку за время воздействия импульса измеряется только одна точка ВАХ. Поэтому количество точек ВАХ в этом режиме ограничивают (20, 50 или 100 точек).

Импульсную развертку ВАХ используют в режиме «Высокого напряжения» и в режиме «Большого тока».

Развертка ВАХ в режиме «Большого тока» (±50 В, ±200 А)

В этом режиме используют импульсный испытательный сигнал (+IMP и -IMP), причем есть возможность выбора длительности импульсов исходя из мощности, а также скоростных и тепловых (скорость нагрева) особенностей тестируемого объекта из ряда: 10 мкс, 20 мкс, 50 мкс, 100 мкс.

При тестировании мощных диодов импульсы формируют в канале коллектора (С).

При тестировании биполярных (полевых) транзисторов – в канале базы (затвора).

2 Формирование сигналов питания первичной обмотки трансформатора в режиме «Высокое напряжение» с помощью контроллера

При всех видах развертки на первичную обмотку трансформатора подают, с помощью электронного ключа, отрезки синусоидального напряжения регулируемого по амплитуде и синхронного с напряжением сети 50 Гц.

Моменты времени, когда начинается и заканчивается каждый отрезок синусоидального напряжения, определяются сигналом «ENS» (Ворота), поступающим на вход управления электронным ключом.

Сигнал «ENS» должен вырабатываться контроллером согласно определенным правилам подачи напряжения питания на трансформатор, выполненный на электромагнитном сердечнике, для каждого вида развертки.

Правила подачи напряжения на первичную обмотку трансформатора.

1 Включать/выключать трансформатор (подавать сигнал на первичную обмотку или выключать этот сигнал) можно только в моменты, когда ток через трансформатор равен нулю. Эти моменты соответствуют максимальному напряжению на первичной обмотке.

2 Во избежание магнитного насыщения сердечника, положительный сигнал подаваемый на трансформатор должен компенсироваться точно таким же по форме отрицательным сигналом. Пример – синусоида.

Окончательная форма сигнала развертки и его полярность определяются для каждого вида развертки соответствующим выпрямительным диодом, установленным в источнике напряжения после трансформатора.

Правила формирования сигнала «ENS» (Ворота)

ENS определяет интервалы времени, в которые на объект тестирования подается испытательный сигнал. Для безопасности персонала, контактирующего с объектом, и сохранения работоспособности самого объекта при его подключении этот сигнал можно формировать, начиная с момента появления сигнала «СТАРТ» и можно прекращать после появления сигнала «СТОП».

Контроллер, для каждого вида развертки, должен вырабатывать сигнал «Сбор», в течение которого производится дискретизация (оцифровка и запоминание) испытательных сигналов на тестируемом объекте.

Сигналы «ENS» и «Сбор» формируют на основе меандра «Line» частотой 50 Гц (период 20 мс), который соответствует синусоидальному напряжению сети и вырабатывается формирователем напряжения развертки из гальванически развязанного напряжения сети амплитудой 40 В.

Длительность сигнала «Сбор» составляет 10 мс для всех видов разверток. Это должно обеспечить считывание и запоминание 200-т точек ВАХ.

Чтобы получить на сигнале длительностью 10 мс 200 выборок, выборки должны следовать через 10 мс/200 = 0,05 мс (50 мкс), при этом частота дискретизации будет составлять 1/0,05 мс = 20 кГц.

Отбор точек ВАХ, которые используются для формирования изображения на экране монитора и для отображения ВАХ в виде таблицы в режимах +DC, -DC выполняется программно, например от 115-й до 125-й.

В режимах +IMP, -IMP для формирования ВАХ используется 102-я выборка испытательного сигнала, соответствующая 102-му сигналу RUN.

Рисунок 1 Формирование разверток Sin+, Sin-, AC, DC+, DC- в режиме «Высокое напряжение» расположен на следующей странице.

Рисунок откорректирован 07.10.2025

Задачи контроллера по формированию импульсов в реж. «Высокое напряжение»

Откорректировано 07.10.2025

Интервал ENS определяет длительность испытательных импульсов на развертках +IMP, -IMP. В режиме высокого напряжения сигнал ENS должен «вырезать кусочек» (интервал) из синусоидального напряжения 50 Гц, причем этот интервал должен располагаться на вершине синусоиды, где напряжение велико, а скорость изменения сигнала мала. Этому условию для импульсов любой длительности в режиме высокого напряжения удовлетворяет момент появления 102-го сигнала RUN (5,1 мс от начала сигнала Сбор).

Амплитуду испытательного импульса определяют как мгновенное значение напряжения после установления вершины импульса, практически перед её окончанием. Сигнал RUN формируют с периодом 50 мкс, что вполне сопоставимо с длительностью испытательных импульсов (200 мкс), следовательно, требуется жесткая привязка сигнала ENS к сигналам RUN, моменты формирования которых заданы сигналами Сбор и Line.

Требования к соответствию момента окончания ENS и моменту запуска АЦП сигналом RUN сформулированы далее для режима Большого тока. Эти требования, для единообразия, целесообразно распространить и на режим Высокого напряжения.

Рисунок 2 Формирование разверток ENS Imp+ и ENS Imp- в режиме «Высокое напряжение».

Сигналы ENS Imp+ и ENS Imp-, показанные на рисунке могут поступать как в канал коллектора (С), при тестировании диодов, так и в канал базы (В), при тестировании транзисторов.

Рисунок 3 Растянутое изображение участка с выделенными номерами сигналов RUN.

Чтобы различать импульсные сигналы управления, в зависимости от места назначения (каналы С или В), от режима работы канала С (“Высокое напряжение” или “Большой ток”) и от полярности напряжения в канале С, приняты следующие наименования для этих сигналов:

- ENS Imp+ / ENS Imp- канал С, полярность +/-, режим Высокого напряжения,

- IMPC+i / IMPC-i канал С, полярность +/-, режим Большого тока,

- IMPb+v / IMPb-v канал B, полярность +/-, режим Высокого напряжения,

- IMPb+i / IMPb-i канал B, полярность +/-, режим Большого тока.

4 Задачи контроллера по формированию импульсов в канале С (коллектор, сток),

и в каналах В (база) и G (затвор) в режиме «Большого тока» (±50 В, ±200 А).

В режиме «Большого Тока» в канале С отсутствует синусоидальное напряжение, поэтому импульсы можно было бы формировать не привязываясь к сигналу «Line», однако алгоритм оцифровки и последующей обработки графика ВАХ в импульсном режиме целесообразно выполнить единообразно для режимов Высокого напряжения и Большого тока.

102-й момент дискретизации определяется 102-м сигналом RUN. Выборка напряжения на вершине испытательного импульса должна быть осуществлена перед его окончанием, чтобы напряжение вершины импульса, по возможности, установилось.

В режиме Большого тока длительность испытательных импульсов (100 мкс, 50 мкс, 20 мкс, 10 мкс) сравнима или меньше, чем интервал дискретизации (50 мкс) и сигнал ENS надо сформировать так, чтобы он закончился после того фронта 102-го сигнала RUN, который формирует запуск АЦП (сигн. СNV), например через 2,5 ÷ 3 мкс.

Для этого можно сформировать две последовательности сигналов RUN. Первую по началу сигнала Сбор (RUN 1), а вторую (RUN 2), путем задержки RUN 1 на 2,5 ÷ 3мкс. В дальнейшем RUN 2 использовать для запуска АЦП, а RUN 1 – для формирования ENS в импульсном режиме.

Рисунок 4 Формирование сигналов ENS Imp+ (ENS Imp-) в режиме «Большой ток».

Рисунок 5 Растянутое изображение участка с выделенными номерами сигналов RUN

в режиме «Большой ток».
