Sasha7b9Work/Linia/doc/РД/ИППП3/Aлгоритм   Линия-2/3е доп.Имп.разв.для тест.транзистора.docx

3е дополнение по формированию импульсной развертки

Формирование импульсной развертки для тестирования транзисторов

в режиме «ВЫСОКОЕ НАПРЯЖЕНИЕ»

При тестировании транзисторов с помощью импульсной развертки в режиме «Высокое напряжение», формирование импульсов (тока или напряжения) осуществляется в канале В, при этом в канале С формируют мощный пульсирующий сигнал (выпрямленная синусоида). Соответствие полярности этих сигналов задают в канале В (прямая или обратная).

Момент измерения ВАХ должен соответствовать вершине синусоиды, где скорость изменения испытательного сигнала близка к нулю. Если сигнал «СБОР» формировать так же, как при развертке синусоидальным сигналом (200 точек ВАХ на полу-синусоиде), то ее вершине приблизительно будет соответствовать 100-й сигнал RUN.

Чтобы этот же сигнал RUN (100-й) попал на установившееся значение вершины импульса (т.е. перед ее окончанием) интервал (задержка) между соответствующим фронтом LINE и моментом формирования импульса в канале В (IPMb+v или IPMb-v) должен удовлетворять следующему условию:

- при длительности 200 мкс, задержка д.б. равна 5 мс - 0,2 мс + 0,005 мс = 4,805 мс;

- при длительности 500 мкс, задержка д.б. равна 5 мс - 0,5 мс + 0,005 мс = 4,505 мс;

- при длительности 1 мс, задержка д.б. равна 5 мс - 1 мс + 0,005 мс = 4,005 мс.

Эти же значения задержки были указаны в файле «2е дополн. по формир.имп.разв.» от 23.09.2025г при формировании импульсов в канале С, при тестировании Диода.

Сигнал IPMb+v (IPMb-v) для канала В при тестировании транзистора отличается от сдвоенного сигнала ENS Imp+ (ENS Imp-) для канала С при тестировании диода тем, в канале В не требуется присутствие второго (размагничивающего) импульса. Диаграммы этих сигналов при тестировании транзистора представлены на рисунках 1 и 2.

Рисунок 1. Диаграммы сигналов IPMb+v и ENS Imp+ при тестировании npn транзистора с помощью импульсной развертки в режиме «Высокое напряжение».

Рисунок 2. Диаграммы сигналов IPMb-v и ENS Imp- при тестировании pnp транзистора с помощью импульсной развертки в режиме «Высокое напряжение».

Таким образом, при использовании импульсной развертки для тестирования транзистора в режиме «Высокое напряжение», необходимо формировать развертку сразу в двух каналах. В канале В – импульсную, а в канале С – пульсирующую синусоидальную.

Формирование импульсной развертки для тестирования транзисторов

в режиме «БОЛЬШОЙ ТОК»

По договоренности с Тимофеем.

В режиме Большого тока, для транзистора и для диода.

Импульсы микросекундного диапазона (10 – 100 мкс) должны заканчиваться через 1 мкс после переднего (нарастающего) фронта сигнала RUN.

При тестировании транзисторов в режиме «Большого Тока» в канале С формируют постоянное напряжение, поэтому испытательные импульсы IMPВ- и IMPВ+ для канала В можно не привязываясь к сигналу «Line».

~~Это позволяет формировать испытательный импульс следующим образом:~~

~~- при длительности импульса 10~~ ~~мкс~~~~, передний фронт (~~~~Rising~~ ~~Edge~~~~) сигнала~~ ~~RUN~~ ~~должен начинаться через 8,5~~ ~~мкс~~ ~~после фронта формируемого импульса;~~

~~- при длительности импульса 20~~ ~~мкс~~~~, фронт сигнала~~ ~~RUN~~ ~~должен начинаться через 18,5~~ ~~мкс~~ ~~после фронта формируемого импульса;~~

~~- при длительности импульса 50~~ ~~мкс~~~~, фронт сигнала~~ ~~RUN~~ ~~должен начинаться через~~ ~~48,5~~ ~~мкс~~ ~~после фронта формируемого импульса;~~

~~- при длительности импульса 100~~ ~~мкс~~~~, фронт сигнала~~ ~~RUN~~ ~~должен начинаться через 98,5~~ ~~мкс~~ ~~после фронта формируемого импульса.~~

Данное правило распространяется на формирование импульсов в канале В и в канале С (формирователь развертки).

Интервал между импульсами в режиме «Большого тока» не менее 400 мс (возможны доп. значения 600 мс, 800 мс, 1000 мс). Сигнал EIMP формируют согласно диаграммам, представленным на рисунках 3 и 4.

Эти же значения задержки были указаны в файле «2е дополн. по формир.имп.разв.» от 23.09.2025г при формировании импульсов в канале С, при тестировании Диода.

Рисунок 3. Диаграммы сигналов IMPc +/- (10мкс ÷ 100мкс) и EIMP (20мс) при тестировании ДИОДА с помощью импульсной развертки в режиме «Большой ток».

Рисунок 4. Диаграммы сигналов IMPc +/- (10мс), IMPB+/- и EIMP (20мс) при тестировании ТРАНЗИСТОРА с помощью импульсной развертки в режиме «Большой ток».
