Sasha7b9Work/Linia/doc/РД/ИППП3/Aлгоритм   Линия-2/Foрм.имп. контроллером, уточн.1 и 2.docx

Уточнение задач контроллера по формированию

импульсных разверток (от 23.04.25).

В файле (Fорм.испыт.сигн.с пом.контроллера) были изложены задачи по формированию импульсных разверток в канале С.

Импульсы в канале С используются при тестировании двухполюсников (диодов). При тестировании транзисторов в режиме импульсной развертки, импульсы должны формироваться в канале базы (затвора).

1 В режиме «Высокого напряжения».

Для формирования импульсного испытательного сигнала в канале базы (затвора) контроллер должен сформировать специальные импульсы для этих каналов, соответствующие по длительности и по положению на временной оси («Line») импульсам ENS Imp+ и ENS Imp-, но без дополнительных сигналов (импульсов) предназначенных для размагничивания сердечника трансформатора.

Импульсные сигналы, для каналов базы и затвора можно назвать Imp+B, Imp-B и Imp+G, Imp-G, опуская приставку ENS, поскольку здесь отсутствуют размагничивающие импульсы. Сигналы Imp+B, Imp-B (не парафазные) поступают на плату базы, а сигналы Imp+G, Imp-G (не парафазные) ─ на плату затвора.

Все упомянутые сигналы представлены на рисунке 2 в файле (Fорм.испыт.сигн.с пом.контроллера). Длительность импульсов (на рисунке ENS Imp+ и ENS Imp-) в этом режиме определяется выбранным диапазоном выходного напряжения, т.е. программно:

- в диапазоне ±30 В длительность д.б. 0,2 мс,

- в диапазоне ±300 В длительность д.б. 0,5 мс,

- в диапазоне ±300 В длительность д.б. 1,0 мс.

2 В режиме «Большого тока».

В режиме Большого тока длительность испытательных импульсов 100 мкс, 50 мкс, 20 мкс, 10 мкс устанавливается программно оператором.

Этот сигнал должен поступать в виде парафазного сигнала на 3 платы:

- источник большого тока,

- канал базы,

- канал затвора.

Импульсный сигнал, формируемый в этом режиме, можно обозначить просто IMP, поскольку сигнал ENS в этом режиме не формируется.

Правила формирования этого сигнала, с привязкой к сигналу RUN, изложены ранее в файле (Fорм.испыт.сигн.с пом.контроллера) рисунки 4 и 5.

Важным условием является то, что этот сигнал должен заканчиваться через 2,5 ÷ 3 мкс после того фронта RUN, который формирует запуск АЦП (сигнал СNV).

Уточнение 2 от 24.04.2025.

В режиме «тестирование диода» импульсы 100 мкс, 50 мкс, 20 мкс, 10 мкс (активн.1) должны поступать только на плату «источника большого тока».

В режиме «тестирование транзистора» импульсы 100 мкс, 50 мкс, 20 мкс, 10 мкс (активн.1) должны поступать на плату «канал базы» и на плату «канал затвора». При этом на плату «источника большого тока» на проводе, по которому в другом режиме передавались импульсы, должен присутствовать высокий уровень «лог.1».

Режимы «тестирование диода» и «тестирование транзистора» задаются программно.
