Sasha7b9Work/Linia/doc/РД/_Archiv/Что такое Линия 2/Oписание структ.измер.,Регистр.схема.docx

Описание структуры измерителя.

Измеритель содержит программноуправляемые узлы:

- канал (С) коллектора,

- канал (В) базы,

- дополнительный (S) канал (подложки),

- коммутатор,

- блок питания и устройство подключения (уст-во контактирующее).

Канал коллектора (стока)

Обеспечивает проведение измерений в двух режимах режим «Высокого напряжения» (0 В – ±3000 В, 0,05 А- 5 А) и режим «Большого тока» (0-±50 В, ±200 А).

В режиме «Высокого напряжения» три диапазона напряжения:

- 0 В – ±30 В (Iмакс 5 А),

- 0 В – ±300 В (Iмакс 0,5 А) и

- 0 В – ±3000 В (Iмакс 0,05 А).

В этом режиме, согласно ТЗ, измеритель должен обеспечить питание тестируемого объекта напряжением:

1) Пульсирующим напряжением (полученным путем однополупериодного выпрямления переменного напряжения частотой 50 Гц).

2) Постоянным напряжением (полученным путем однополупериодного выпрямления напряжения частотой 50 Гц с его последующим сглаживанием с помощью конденсатора),

3) Импульсным напряжением.

Все сигналы положительной и отрицательной полярностей значением от 0 до 3000 В.

Кроме того, измеритель должен обеспечить питание тестируемого объекта синусоидальным (знакопеременным) напряжением частотой 50 Гц в том же диапазоне напряжений и токов – в ТЗ это требование пропущено (отсутствует).

В режиме «Большого тока»: диапазон напряжения 0÷ +50 В и 0÷ -50 В с максимальным током ±200 А, соответственно (согласно ТЗ).

В канале коллектора разбиение диапазонов тока и напряжения измерителей на поддиапазоны осуществляется в соотношении 1: 2: 5: 10 и т.д.

Канал коллектора (стока) содержит:

- Формирователь развертки (1/2 платы),

- Измеритель напряжения (1/2 платы),

- Источник напряжения (3÷4 платы),

- Измеритель тока (3 платы),

- Формирователь импульсов (2 платы).

Конструктивно Формирователь развертки и Измеритель напряжения выполнены на одной плате.

Формирователь развертки – формирует вид (форму) развертывающего напряжения для питания выходного трансформатора в режиме «ВЫСОКОЕ НАПРЯЖЕНИЕ».

Источник напряжения усиливает сигнал сформированный формирователем развертки для питания выходного трансформатора (~200 Вт), к выходам которого подсоединена схема формирующая испытательный сигнал путем выбора диапазона напряжения (30 В, 300 В или 3000 В), полярности (+/-) выпрямленного сигнала и подключения сглаживающего (накопительного) конденсатора для получения испытательного сигнала в виде постоянного напряжения.

Таким образом: Формирователь развертки, и источник напряжения обеспечивают параметры испытательного сигнала в режиме «Высокого напряжения».

_____________________________________________________________________________________________________________________________

Формирователь импульсов обеспечивает параметры испытательного сигнала в режиме «Большого тока» в виде импульсов напряжения амплитудой от 0 до ±50 В с максимальным током до 200 А.

Энергию для формирования мощных импульсов длительностью 100 мкс, 50 мкс, 20 мкс и 10 мкс запасают с помощью двух батарей электролитических конденсаторов, по 4400 мкФ с максимальным напряжением 200 В (В43640А2228М000).

Сила (величина) тока через нагрузку определяется сопротивлением нагрузки и амплитудой формируемого импульса.

___________________________________________________________________________________________________________________________________________

Измеритель напряжения осуществляет измерение в диапазоне от 0,5 В до 5000 В, который разбит на поддиапазоны в соотношении 1:2:5:10.

______________________________________________________________________________________________________________________________________

Измеритель тока гальванически развязан относительно других цепей (7-10 кВ).

Измеритель тока выполнен в экранированной коробке, выложенной изнутри изоляционным пластиком.

В ИППП3 опторазвязка выполнена на микросхемах TFDU6103-TR3 (6 каналов связи). Оптопары расположены попарно на расстоянии 2,5 см друг от друга.

Аналоговая часть измерителя выполнена на одной плате и соединена с коллектором (стоком) тестируемого транзистора, рабочее напряжение на плате достигает ±3000 В относительно корпуса. На двух платах, разнесенных на 2,5 см, выполнен опто- интерфейс, который обеспечивает связь с контроллером

Гальваническая развязка цепей питания измерителя тока (10 кВ) обеспечивается с помощью специального трансформатора, который запитан от сети переменного тока ~230 В, 50 Гц.

Измеритель напряжения и Измеритель тока работают в обоих режимах (режим «Высокого напряжения» и режим «Большого тока»).

Канал базы (затвора)

Обеспечивает проведение измерений:

- в режиме формирования сигнала тока, при тестировании биполярных транзисторов,

- и в режиме формирования сигнала напряжения, при тестировании полевых транзисторов.

В режиме формирования сигнала тока обеспечивает:

1) Формирование силы постоянного тока положительной и отрицательной полярностей значением от 0 до 2 А (5 А в импульсе);

2) Измерение мгновенных значений выходного напряжения с базовой погрешностью до ±2 %. Диапазоны выходного сигнала и диапазоны измерения в соотношении 1: 10: 100.

При этом максимальное выходное напряжение не превышает 8÷10 В ?????

В режиме формирования сигнала напряжения обеспечивает:

1) Формирование напряжения постоянного тока положительной и отрицательной полярностей значением от 0 до 10 В (30 В )(5 А в импульсе);

2) Измерение мгновенных значений выходного тока с базовой погрешностью до ±2 %. Диапазоны выходного сигнала и диапазоны измерения в соотношении 1: 10: 100.

При этом максимальный выходной ток не превышает 2 А (5 А в импульсе) при напряжении до 4 В и не превышает 0,1 А при напряжении до 30 В.

Из ТЗ п. 7.2.4 Измеритель обеспечивает защиту тестируемого объекта от повреждения при превышении установленного диапазона измеряемого тока или напряжения в канале базы!!!!!

Дополнительный канал (подложки)

Обеспечивает проведение измерений:

- в режиме формирования сигнала тока,

- и в режиме формирования сигнала напряжения.

В режиме формирования сигнала тока обеспечивает:

- формирование силы постоянного тока положительной и отрицательной полярностей значением от 0 до 20 мА (в диапазоне напряжения 0-30 В);

- измерение мгновенных значений выходного напряжения с базовой погрешностью до ±2 %. Диапазоны выходного сигнала и диапазоны измерения в соотношении 1: 10: 100.

Выходное напряжение до 30 В.

В режиме формирования сигнала напряжения обеспечивает:

- формирование напряжения постоянного тока положительной и отрицательной полярностей значением от 0 до 30 В (в диапазоне тока 0-20 мА);

- измерение мгновенных значений выходного тока с базовой погрешностью до ±2 %. Диапазоны выходного сигнала и диапазоны измерения в соотношении 1: 10: 100.

Выходной ток не превышает 20 мА при напряжении до 30 В.

Измеритель обеспечивает защиту тестируемого объекта от повреждения при превышении установленного диапазона измеряемого тока или напряжения в дополнительном канале

Коммутатор

Обеспечивает выбор режима измерения параметров транзистора путем соответствующей коммутации каналов С и В к выводам объекта тестирования.

Регистровая схема измерителя Линия 2

1 ФОРМИРОВАТЕЛЬ РАЗВЕРТКИ

а) ЦАП AD5443 Функция – регулирование выходного напряжения канала С.

б) Управляющий регистр – 8 разрядов Лог. уровни 0 и +5 В.

Формирователь развертки – предназначен для формирования вида (формы) развертывающего напряжения для питания выходного трансформатора в режиме «ВЫСОКОЕ НАПРЯЖЕНИЕ».

В режиме «ВЫСОКОЕ НАПРЯЖЕНИЕ» выходное напряжение Регулируемого трансформатора преобразуют с помощью Источника напряжения в испытательный сигнал канала коллектора (С), путем выбора диапазона и полярности выпрямления.

2 ИЗМЕРИТЕЛЬ НАПРЯЖЕНИЯ (Диапазоны измерения от 0,5 В до 5000 В (1:2:5:10)).

а) АЦП AD7691

б) ЦАП AD5443. Функция – переключение диапазонов измерения.

в) Управляющий регистр – 8÷16 разрядов. Логические уровни 0 и +5 В.

3 ИСТОЧНИК НАПРЯЖЕНИЯ.

а) Управляющий регистр – 16 разрядов. Логические уровни 0 и +5 В.

Содержит мощный усилитель сигнала, сформированного формирователем развертки, для питания выходного трансформатора и схему выбора диапазона и полярности выпрямленного сигнала выходного трансформатора.

4 ИЗМЕРИТЕЛЬ ТОКА (опторазвязка 7 кВ)

а) АЦП AD7691

в) Управляющий регистр – 16 разрядов. Лог. уровни 0 и +5 В.

Измеритель тока выполнен в экранированной коробке, выложенной изнутри изоляционным пластиком.

В ИППП3 опторазвязка выполнена на микросхемах TFDU6103-TR3 (6 каналов связи). Микросхемы попарно расположены на расстоянии на 2,5 см напротив друг друга.

Аналоговая часть измерителя выполнена на одной плате и соединена с выводом коллектора (стока) тестируемого транзистора. Рабочее напряжение на плате достигает ±3000 В относительно корпуса.

На двух платах в ИППП3 выполнен опторазвязанный интерфейс, который обеспечивает связь с АЦП AD7691 синхронно с другими преобразователями в каналах С, В и S. Платы интерфейса разнесены между собой на 2,5 см.

Гальваническая развязка цепей питания измерителя тока (10 кВ) обеспечивается с помощью специального трансформатора, который запитан от сети переменного тока ~230 В, 50 Гц.

5 ФОРМИРОВАТЕЛЬ ИМПУЛЬСОВ (2 платы).

а) ЦАП AD5531 Функция – регулирование напряжения выходных импульсов канала С в режиме Большого тока

б) Управляющий регистр – 8 разрядов. Лог. уровни 0 и +5 В.

Кроме того, контроллер должен сформировать импульсы длительностью 100 мкс, 50 мкс, 20 мкс и 10 мкс .

Они должны быть привязаны к определенному моменту стробирования АЦП, например, к моменту под номером 102 в последовательности из 200 стробирований.

Эти импульсы должны быть сформированы так, чтобы соответствующий момент стробирования появлялся за 1 мкс до их окончания.

Формирователь импульсов предназначен для формирования испытательного сигнала в режиме «Большого тока» в виде импульсов напряжения амплитудой от 0 до ±50 В.

Энергия для формирования мощных импульсов длительностью 100 мкс, 50 мкс, 20 мкс и 10 мкс запасается с помощью двух батарей электролитических конденсаторов, по 4400 мкФ с максимальным напряжением 200 В (В43640А2228М000).

Максимальный ток через внешнюю нагрузку, например тестируемый транзистор, до ±200 А в соответствии с полярностью формируемого импульса.

Сила (величина) тока через нагрузку определяется сопротивлением нагрузки и амплитудой формируемого импульса.

6 КАНАЛ БАЗЫ. Выполнен как источник-измеритель.

а) АЦП AD7691

б) ЦАП AD5531 Функция – установка выходного тока или напряжения.

в) ЦАП AD5300 Функция – установка допустимого порога выходного сигнала напряжения (тока).

г) Управляющий регистр – 24÷32 разряда. Логические уровни 0 и +5 В.

7 КАНАЛ ЗАТВОРА (ДОПОЛНИТЕЛЬНЫЙ КАНАЛ (S)). Выполнен как источник-измеритель.

С точки зрения регистровой схемы дополнительный канал полностью аналогичен каналу базы.

а) АЦП AD7691

б) ЦАП AD5531 Функция – установка выходного напряжения или тока.

в) ЦАП AD5300.

Функция – установка допустимого порога выходного сигнала тока (напряжения).

г) Управляющий регистр – 24÷32 разряда. Логические уровни 0 и +5 В.

8 КОММУТАТОР

Коммутатор выполнен на герконах, управляемых сигналами от контроллера согласно выбранному режиму измерения.

а) Управляющий регистр – 8 разрядов. Логические уровни 0 и +5 В.

Используемые микросхемы

AD7691 Напряжение питания и VREF +5 В.

(тот же что и был в ИППП-3)

18-битный аналого-цифровой преобразователь последовательного приближения .

- Разрешение 18 бит без пропущенных кодов
- Максим. Частота выборки: 250 kSPS
- Линейность (INL): ±0,75 LSB тип., ±1,5 LSB макс. (±6 ppm от полной шкалы)
- Динамический диапазон: 102 дБ при 250 kSPS
- Динамический диапазон при передискретизации: 125 дБ при 1 kSPS
- Разрешение без шума: 20 бит при 1 kSPS
- Эффективное разрешение: 22,7 бит при 1 kSPS
- SINAD: 101,5 дБ тип. на 1 кГц
- Коэффициент гармонических искажений (THD): −125 дБ тип. на 1 кГц
- Истинно дифференциальный входной сигнал: ±VREF
- Входной диапазон: 0 В – VREF при VREF до VDD на обоих входах
- Отсутствие задержки конвейерной обработки
- Питание от одного источника: 2,3 В – 5 В
- Совместимость с логическими уровнями 1,8 В / 2,5 В / 3 В / 5 В
- Запатентованный последовательный интерфейс
- Совместимость с SPI/QSPI/MICROWIRE™/DSP
- Возможность каскадного соединения нескольких АЦП
- Опциональный индикатор занятости (busy)
- Энергопотребление:
  - 1,35 мВт при 2,5 В и 100 kSPS
  - 4 мВт при 5 В и 100 kSPS
  - 1,4 мкВт при 2,5 В и 100 SPS
  - Ток в режиме ожидания: 1 нА

AD7691 — это 18-битный аналого-цифровой преобразователь (АЦП) с зарядовым перераспределением и последовательным приближением, работающий от одного источника питания с напряжением от 2,3 В до 5 В. Он содержит высокоскоростной маломощный 18-битный АЦП, внутренний тактовый генератор для преобразования и универсальный последовательный интерфейс.

При фронте CNV происходит выборка разности напряжений между входами IN+ и IN−, которые изменяются в противофазе в пределах от 0 В до VREF. Опорное напряжение VREF подается извне и может достигать значения напряжения питания. Энергопотребление устройства линейно зависит от скорости выборки.

Последовательный интерфейс, совместимый с SPI, поддерживает каскадное соединение нескольких АЦП на одной 3-проводной шине через вход SDI, а также предоставляет опциональный индикатор занятости. Устройство поддерживает интерфейсы с логическими уровнями 1,8 В, 2,5 В, 3 В и 5 В через отдельное питание VIO.

AD5443 Основная функция – регулировка выходного напряжения канала С

(тот же что и был в ИППП-3)

12-битный цифро-аналоговый преобразователь с выходом по току обеспечивает режим 4хквадрантного умножения с полосой пропускания 10 МГц.

- Питание от 2,5 В до 5,5 В
- Последовательный интерфейс до 50 МГц
- Умножительная полоса пропускания 10 МГц
- Частота обновления 2,5 MSPS
- Линейность (INL) ±1 младший значащий бит (LSB) для 12-битного ЦАП
- Входное опорное напряжение ±10 В
- Низкая энергия выбросов < 2 нВ·с
- Рабочий температурный диапазон −40°C … +125°C
- Компактный 10-выводный корпус MSOP
- Пин-совместимость с 8-, 10- и 12-битными ЦАП с выходом по току
- Гарантированная монотонность
- Четырехквадрантное умножение
- Сброс при включении питания и защита от пониженного напряжения (brownout detection)
- Поддержка каскадного соединения (daisy-chain mode)
- Функция чтения данных (readback)
- Типичное потребление энергии — 0,4 мкА

Устройство работает от источника питания с напряжением от 2,5 В до 5,5 В.

ЦАП использует двойной буфер и 3-проводной последовательный интерфейс, совместимый со стандартами SPI, QSPI™, MICROWIRE и большинством DSP-интерфейсов. Функция чтения данных (readback) дает возможность считывания содержимого регистра ЦАП через вывод SDO.

При включении питания внутренний сдвиговый регистр и защелки заполняются нулями, и выходное значение устанавливается в нулевой уровень. Полный масштаб выходного тока определяется внешним опорным напряжением VREF. Встроенный обратный резистор RFB обеспечивает температурную стабильность и формирует выходное напряжение при использовании с внешним высокоточным преобразователем ток-напряжение.

AD5300 (тот же что и был в ИППП-3)

Одноканальный 8-битный ЦАП

- Микромощный режим: 140 мкА при 5 В
- Пониженное энергопотребление: 200 нА при 5 В, 50 нА при 3 В
- Питание от 2,7 В до 5,5 В
- Гарантированная монотонность по конструкции
- Опорное напряжение формируется от источника питания
- Сброс при включении питания (Power-On Reset) в 0 В
- Три режима пониженного энергопотребления
- Низкопотребляющий последовательный интерфейс с входами на триггерах Шмитта
- Встроенный выходной буфер-усилитель, работающий в режиме rail-to-rail
- Возможность прерывания по сигналу SYNC

AD5300 — это одноканальный 8-битный цифро-аналоговый преобразователь (ЦАП) с буферизированным выходом по напряжению, работающий от одиночного источника питания 2,7 В – 5,5 В и потребляющий 115 мкА при 3 В. Встроенный высокоточный выходной усилитель позволяет достигать полного размаха выходного сигнала (rail-to-rail).

AD5300 использует 3-проводной последовательный интерфейс, работающий с тактовой частотой до 30 МГц и совместимый со стандартами SPI®, QSPI™, MICROWIRE™ и DSP.

Опорное напряжение формируется от источника питания, что обеспечивает максимальный динамический диапазон выходного сигнала. Встроенная схема сброса при включении питания гарантирует, что выходное напряжение ЦАП устанавливается в 0 В и остается на этом уровне до первой корректной записи данных в устройство.

Функция понижения энергопотребления позволяет снизить потребляемый ток до 200 нА при 5 В и предоставляет возможность программного выбора выходной нагрузки в этом режиме. Переключение в режим пониженного энергопотребления осуществляется через последовательный интерфейс.

При напряжении 5 В потребляемая мощность составляет 0,7 мВт, а в режиме энергосбережения — всего 1 мкВт.

AD5531 (тот же что и был в ИППП-3)

14-битный цифро-аналоговый преобразователь

- Последовательный ввод,
- Максимальный диапазон выходного напряжения ±10 В
- Чтение данных (readback) SPI-интерфейс
- Функция сброса (Clear) на заданное пользователем напряжение.

AD5531 — это 14-битный цифро-аналоговый преобразователь (ЦАП) с последовательным вводом и выходным напряжением. Он использует универсальный 3-проводной интерфейс, совместимый со стандартами SPI®, QSPI™, MICROWIRE™ и DSP. Данные передаются в устройство в 16-битном последовательном формате. Последовательные данные доступны на выводе SDO.

Функция чтения данных (readback) позволяет считывать содержимое регистра ЦАП через вывод SDO. Выход ЦАП буферизуется усилителем с коэффициентом усиления 2 и привязывается к потенциалу на выводе DUTGND.

Сигнал LDAC можно использовать для асинхронного обновления выходного значения ЦАП. Вывод PD (power-down) позволяет перевести ЦАП в режим пониженного энергопотребления, а вывод CLR позволяет сбросить выходное напряжение к заданному пользователем уровню — потенциалу на DUTGND.

ADG433 Четырехканальный аналоговый коммутатор SPST

(те же что и были в ИППП-3)

### Особенности:

- Максимальное напряжение питания: 44 В
- Аналоговый диапазон сигналов: ±15 В
- Низкое сопротивление открытого канала: <24 Ом
- Минимальное энергопотребление: 3,9 мкВт
- Низкий ток утечки: <0,25 нА
- Высокая скорость переключения:
  - Время включения (tON): <165 нс
  - Время выключения (tOFF): <130 нс
- Переключение с разрывом (break-before-make)
- Совместимость с TTL/CMOS логикой

### Применения:

- Автоматизированное тестовое оборудование
- Высокоточные системы сбора данных
- Системы выборки и хранения (sample & hold)

ADG433 — это монолитный CMOS-коммутатор, содержащий четыре независимых ключа с архитектурой SPST (однополюсный, однонаправленный). Устройство изготовлено по усовершенствованному процессу LC²MOS, который обеспечивает низкое энергопотребление при высокой скорости переключения и низком сопротивлении открытого канала.

Профиль сопротивления остается практически неизменным во всем диапазоне аналоговых сигналов, что обеспечивает высокую линейность и низкие искажения.

ADG433 содержит четыре независимых ключа SPST с разной логикой управления. Два ключа включаются логическим 0, а два других работают по инверсной логике (включаются логической 1).

Каждый ключ одинаково хорошо проводит сигнал в обоих направлениях в состоянии ON и блокирует сигнал в состоянии OFF. В конструкции реализовано переключение с разрывом (break-before-make), предотвращающее перекрытие сигналов при работе в составе мультиплексоров.

ADG433 обладает низким уровнем инжекции заряда, что минимизирует скачки напряжения при изменении состояния цифровых входов.
