Sasha7b9Work/Linia/doc/РД/ИППП3/Aлгоритм   Линия-2/Концепц.постр.анализатора ВАХ 2.docx

2.1 Концепция построения и алгоритм работы анализатора ВАХ ПП

Концепция построения силового анализатора ВАХ ПП основана на трех базовых принципах:

- в режиме высокого напряжения (до нескольких тысяч Вольт), измерение ВАХ обеспечивается с помощью формирования испытательного сигнала синхронного с переменным напряжением сети (50 Гц) с помощью трансформатора;

- в режиме большого тока, (до нескольких сотен Ампер) измерение ВАХ обеспечивается с помощью формирования импульсов испытательного сигнала с помощью конденсатора;

- измерение ВАХ с помощью испытательного сигнала с ненулевым спектром, например, с помощью импульсов синусоидальной или иной формы, обеспечивается путем измерения мгновенных значений сигналов тока и напряжения, воздействующих на электроды ПОТ.

Кроме того, в концепцию построения силового анализатора ВАХ ПП включены следующие условия.

Алгоритм работы силового анализатора основан на использовании переменного напряжения сети частотой 50ºГц для формирования мощного испытательного сигнала развертки с минимальными потерями энергии на промежуточные преобразования. Поэтому, все процессы формирования и измерения испытательных сигналов на электродах ПОТ должны быть синхронизированы с переменным напряжением сети.

Для исключения остаточного намагничивания сердечника трансформатора формирующего испытательный сигнал, изменение режима его работы производится с интервалом кратным периоду сети.

Переключение электромеханических реле и герконов осуществляется только при отсутствии сигналов тока или напряжения в замыкаемой (размыкаемой) цепи – так называемое “холодное переключение”.

Для выполнения этого условия, алгоритм работы анализатора должен включать следующие интервалы задержки. Интервал задержки для синхронизации момента времени, начиная с которого разрешается переключение реле, с переменным напряжением сети, так как длительность полного цикла формирования испытательного сигнала должна быть кратна периоду сети. Интервал задержки на время “дребезга” контактов реле. Интервал задержки для синхронизации начала развертки (начала измерений) с переменным напряжением сети.

Общая продолжительность перечисленных интервалов задержки (на синхронизацию с сетью до переключения реле, на время “дребезга” контактов и на синхронизацию с сетью перед началом измерений) не может быть менее периода сети. То есть, при частоте 50τГц и длительности периода 20τмс, величина задержки составит от 20 до 40ºмс. Кроме того, алгоритм работы анализатора должен учесть задержку, связанную с конечным значением времени нарастания напряжения в измерительной цепи, которое увеличивается с увеличением сопротивления внутреннего датчика тока (токового шунта) и сопротивления ПОТ.

При неоднократном переключении реле в процессе измерения ВАХ, затраты времени, с учетом перечисленных интервалов задержки, значительно возрастают. Поэтому, согласно выработанной концепции, режим работы измерительных каналов, связанный с переключением реле, изменяют только до начала формирования развертки.

Это отличает алгоритм работы силового анализатора ВАХ ПП от алгоритма работы анализаторов ВАХ ПП малой мощности, формирующих сигнал развертки без привязки к частоте сети, и затрудняет реализацию в силовом анализаторе алгоритма автоматического выбора пределов измерения, связанного с неоднократным переключением герконов.

Временные диаграммы испытательного сигнала в канале С в разных режимах развертки, поясняющие алгоритм работы силового анализатора ВАХ, представлены на рисунке 2.2.


Здесь: Uсети – переменное напряжение сети; +U, -U – однополярные импульсы испытательного сигнала синусоидальной формы положительной и отрицательной полярности; ± U – двухполярный испытательный сигнал синусоидальной формы; +Uимп, -Uимп – однополярные импульсы испытательного сигнала прямоугольной формы положительной и отрицательной полярности; Тсб – интервал времени, в течение которого осуществляется сбор измерительной информации; Тп – длительность выпрямленной полуволны; То – интервал времени, в течение которого осуществляется обработка данных (время ожидания).

Рисунок 2.2 - Временные диаграммы испытательного сигнала в канале С в зависимости от режима развертки.

Силовой анализатор должен обеспечить защиту измерительной цепи и ПОТ от перегрузки по току, напряжению и мощности, а также обеспечить запоминание и сохранение измеренных данных (кривой ВАХ) и режима измерения, в случае короткого замыкания измерительной цепи, например, в результате пробоя ПОТ в процессе измерений.

При развертке ВАХ с помощью испытательного сигнала сложной формы, например, синусоидальным напряжением, выпрямленным синусоидальным напряжением, сглаженным напряжением с пульсациями или импульсами возрастающей амплитуды, измерение мгновенных значений сигналов тока и напряжения во всех каналах анализатора необходимо осуществлять в один и тот же момент времени.

Канал С содержит два широкополосных АЦП с устройствами выборки/хранения на входе, один из которых предназначен для измерения мгновенных значений напряжения развертки, а другой – мгновенных значений выходного тока, протекающего через ПОТ. Каналы В и S содержат по одному широкополосному АЦП с устройством выборки/хранения, который может использоваться для измерения либо тока, либо напряжения.

Каналы B и S формируют постоянное значение испытательного сигнала (тока или напряжения), при измерении единственной линии (графика) ВАХ, или ступенчатонарастающий испытательный сигнал, при измерении семейства ВАХ.

После включения питания и после окончания процесса измерения анализатор автоматически устанавливается в режим “Ожидание”, который предназначен для выбора и установки режимов его работы, подключения или отключения ПОТ, работы с таблицей, с файлами и т.д. В этом режиме все каналы отключены от силовых гнезд C, В, S и формируют сигналы нулевого уровня.

Функциональная схема силового анализатора ВАХ, разработанная согласно принятой концепции, представлена на рисунке 2.3. В качестве ПОТ показан биполярный транзистор, подключенный к каналам C, B, E по двухпроводной схеме.

Рисунок 2.3 – Функциональная схема силового анализатора ВАХ ПП.

Силовой анализатор ВАХ ПП содержит три измерительных канала C, B, S и канал нулевого потенциала E (канал эмиттера). Это обеспечивает измерение ВАХ двух-, трех- и четырехполюсников. Формирование и измерение напряжений в измерительных каналах осуществляется относительно нулевого потенциала канала Е.

Режим “Измерение”, когда на гнездах C, В, S присутствует испытательный сигнал, может быть разделен на два независимых режима измерения ВАХ:

- режим многократных измерений ВАХ (режим многократной развертки);

- режим однократных измерений ВАХ (режим однократной развёртки).

В режиме многократных измерений график ВАХ на экране анализатора динамически отслеживает плавную регулировку, ручкой “РЕГУЛИРОВКА Uc,%”, максимального напряжения развертки. В этом режиме можно визуально оценить поведение ВАХ в зависимости от максимального напряжения развертки и других влияющих факторов, например, времени, температуры и д.р. Режим многократных измерений включается поворотом ручки “РЕГУЛИРОВКА Uc,%”, по часовой стрелке.

Прекращение измерений в режиме многократных измерений происходит либо при уменьшении ручкой “РЕГУЛИРОВКА Uc,%”, максимального напряжения развертки до нулевого уровня, либо при нажатии на кнопку СТОП. В последнем случае на экране анализатора отображается последнее измеренное значение ВАХ, которое может быть использовано для проведения расчетов, сохранения в электронном виде или передачи на внешний компьютер.

В режиме однократных измерений измерение ВАХ происходит либо при нажатии на кнопку “ИЗМЕРЕНИЕ”, либо по внешнему сигналу, поступающему на вход “ПУСК” анализатора. В этом режиме измерение ВАХ происходит быстрее, чем в режиме повторяющейся развертки. После окончания развертки анализатор переходит в режим “Ожидание”.

2.2 Функциональная схема канала коллектора

Канал C (канал коллектора) включает формирователь развертки, источник напряжения развертки, выполненный на основе трансформатора, и измерители мгновенных значений напряжения Uc и тока Ic, показанные в составе канала C на функциональной схеме анализатора рисунок 2.3.

В зависимости от выбора режима измерения ВАХ, в частности, режима высокого напряжения или режима большого тока, источник напряжения реализует различные методы формирования испытательного сигнала.

При формировании испытательного сигнала в режиме высокого напряжения, источник напряжения реализует схему формирования испытательного сигнала с помощью трансформатора, а при формировании испытательного сигнала в режиме большого тока, – с помощью конденсатора. Эти режимы переключают с помощью переключателя, показанного на рисунке 2.3.

Однополярный испытательный сигнал в режиме высокого напряжения формируют в виде полуволн напряжения синусоидальной формы, в виде импульсов возрастающей амплитуды прямоугольной формы, разделенных интервалами длительностью не менее трех периодов сети, и в виде постоянного напряжения с пульсациями, полученного путем выпрямления переменного напряжения и сглаживания его с помощью конденсатора.

В режиме большого тока канал С обеспечивает формирование испытательного сигнала только в виде импульсов напряжения возрастающей амплитуды прямоугольной формы.

Развертка ВАХ формируется за счет изменения напряжения испытательного сигнала по некоторому закону в течение времени измерения ВАХ. Поэтому, испытательный сигнал в виде синусоиды или полусинусоиды, когда испытательное напряжение изменяется в процессе измерения от минимума до максимума и обеспечивается измерение координат множества точек ВАХ, представляет собой уже сформированную развертку ВАХ.

Чтобы сформировать развертку ВАХ с помощью испытательного сигнала, представленного в виде постоянного напряжения с пульсациями, необходимо обеспечить изменение его уровня в течение времени измерения ВАХ, например, путем регулировки вручную или под управлением компьютера по некоторому закону.

При формировании испытательного сигнала в виде импульсов прямоугольной формы, измерение мгновенных значений тока и напряжения, используемых в качестве координат измеряемой точки ВАХ, производится на плоском участке вершины импульса перед её окончанием.

Развертку ВАХ импульсами прямоугольной формы обеспечивают путем формирования последовательности импульсов возрастающей или ниспадающей амплитуды, путем её регулировки вручную или под управлением компьютера по некоторому закону.

При измерении ВАХ, значения испытательного напряжения канала С воздействующего на ПОТ, и выходного тока канала С протекающего через ПОТ определяют с помощью цифровых измерителей напряжения и тока, согласно функциональной схеме канала С, представленной на рисунке 2.4.

Цепи питания изолированных узлов: ОВВ – общий высоковольтный, +ºВВ – положительный высоковольтный,ºВВ – отрицательный высоковольтный. Uр – напряжение развертки

Рисунок 2.4 – Функциональная схема канала С

Изолированный источник питания служит для питания изолированных узлов измерителя тока и содержит отдельный сетевой трансформатор с напряжением изоляции до 10ºкВ. Общий провод изолированного источника питания (ОВВ) подключен к выходу источника напряжения развертки, выходное напряжение Uр которого изменяется в диапазоне ±3000ºВ.

Повторитель напряжения, выполненный на ОУ, исключает погрешность падения напряжения на датчике тока за счет протекания входного тока измерителя напряжения и обеспечивает измерение напряжения непосредственно на коллекторе (стоке) ПОТ во всем диапазоне напряжений.

Независимо от вида формируемой развертки, трансформаторный источник напряжения обладает сравнительно большим внутренним сопротивлением, поэтому величина выходного напряжения воздействующего на ПОТ весьма заметно зависит от величины выходного тока, протекающего через ПОТ. Поэтому, значение испытательного напряжения при любом виде развертки устанавливают не в вольтах, а в процентах от верхнего предела установленного диапазона напряжения развертки.

Измеритель тока преобразует в цифровой код мгновенные значения падения напряжения, выделяющегося на датчике тока в результате протекания через него того же тока, который протекает через ПОТ. Измерение падения напряжения (тока) осуществляется относительно общего высоковольтного провода, объединенного с выходом источника напряжения развертки, как показано на рисунке 2.4. Гальваническая изоляция (10ºкВ) измерителя тока обеспечивается с помощью оптоинтерфейса, который выполнен на 2-х изолированных платах.

Установку диапазона измерения тока согласно ряду 1, 100, 10000º… осуществляют с помощью датчика тока, выполненного в виде набора резисторов, переключаемых с помощью электромеханических контактов (герконов).

Источник напряжения развертки обеспечивает формирование испытательного сигнала при измерении ВАХ в режиме высокого напряжения (±3000ºВ, ±10ºА) или в режиме большого тока (±50ºВ, ±100ºА).

При формировании испытательного сигнала в режиме высокого напряжения, источник напряжения реализует схему формирования испытательного сигнала с помощью трансформатора, представленную на рисункеº2.5.

В качестве напряжения синусоидальной развертки с частотой сети используется напряжение вторичной обмотки сетевого (изолирующего) трансформатора. Искажения формы, присущие сетевому напряжению, устранены с помощью полосового фильтра.

При проведении измерений, сигнал синусоидальной формы поступает через электронный переключатель на регулируемый усилитель мощности, который используется для плавной регулировки амплитуды испытательного напряжения и обеспечивает максимальную мощность испытательного сигнала до 200ºВА.

Рисунок 2.5 – Схема формирования испытательного сигнала напряжения

с помощью трансформатора.

Электронный переключатель на входе регулируемого усилителя мощности позволяет воплотить разработанную концепцию силового анализатора в части защиты силового канала (канала коллектора) от перегрузки, то есть без применения комплекта переключаемых токоограничивающих резисторов, и реализует новый метод ограничения выходного тока (мощности) испытательного сигнала напряжения.

Согласно разработанному методу, измеритель тока, кроме выполнения своей основной функции, сравнивает в аналоговом виде значение выходного тока с пороговым уровнем, который превышает предельное значение установленного диапазона в два раза. При превышении выходным током канала С предельного значения установленного диапазона в два раза, электронный переключатель подключает вход усилителя к общему проводу, как показано на рисунке 2.5.

Задержка срабатывания цепи управления переключателем составляет несколько микросекунд. Таким образом, источник напряжения канала С защищен как от последствий внезапного пробоя установленного ПОТ, так и от ошибочных действий оператора.

Кроме того, разработанный метод обеспечивает защиту от превышения выходным током допустимого уровня не только в канале С, но и в каналах В и S, что было недостижимо с помощью токоограничивающих резисторов. Для этого каналы В и S, снабжены детекторами превышения предельного значения установленного диапазона выходного напряжения, соответствующего канала.

В режиме высокого напряжения, источник напряжения развертки формирует испытательный сигнал синусоидальной формы путем однополупериодного выпрямления переменного напряжения регулируемой амплитуды с выхода трансформатора, как показано на рисунке 2.5, что соответствует требованиям стандартов по методам испытаний силовых полупроводниковых приборов.

Для формирования однополярного испытательного сигнала в некотором диапазоне, замыкают соответствующий электромеханический ключ, а для формирования сигнала синусоидальной формы – оба ключа, подсоединенные к соответствующему отводу вторичной обмотки выходного трансформатора.

В режиме большого тока испытательный сигнал формируют с помощью конденсатора. Схема формирования испытательного сигнала напряжения, в виде импульсов положительной полярности, с помощью конденсатора представлена на рисункеº2.6.

Рисунок 2.6 – Схема формирования испытательного сигнала напряжения

с помощью конденсатора.

Схема коммутации испытательного сигнала с помощь электромеханических реле в диапазонах напряжения 100ºВ, 500ºВ и 3000ºВ, показана на рисунке 2.5 и выполнена на однополюсных реле (герконах).

Разработанная схема коммутации обеспечивает одновременное переключение диапазонов напряжения испытательного сигнала и переключение его полярности, что позволяет сократить количество используемых реле и исключить протекание тока через включенные последовательно два и более реле.

Напряжение со вторичной обмотки трансформатора выпрямляется с помощью диода VD и заряжает электролитический конденсатор С большой емкости. Разряд конденсатора током, протекающим через ПОТ, происходит с помощью мощного МОП транзистора, который работает не в ключевом, а в линейном режиме под управление ОУ.

Прямоугольные импульсы регулируемой амплитуды положительной полярности, поступающие на вход ОУ и управляющие работой всего устройства, вырабатывает генератор импульсов, показанный на рисункеº2.6.

Благодаря обратной связи, ОУ поддерживает в течение импульса напряжение Uн на истоке транзистора, а значит и на ПОТ, равным амплитуде выходного импульса генератора импульсов.

Таким образом, испытательный сигнал, воздействующий на ПОТ, формируется в виде прямоугольных импульсов, время нарастания которых определяется быстродействием ОУ и МОП транзистора, а параметры плоской вершины – соответствующими параметрами ОУ и генератора импульсов.

Максимальное значение тока Iн, протекающего через ПОТ, определяется емкостью конденсатора С, длительностью формируемого импульса, допустимой величиной изменения напряжения на конденсаторе в течение импульса (допустимой величиной разряда конденсатора) и параметрами МОП транзистора.

Особые требования предъявляются к параметрам электролитического конденсатора С, который должен обеспечить не только требуемое значение разрядного тока в течение длительности импульса при допустимом значении падения напряжения на внутреннем сопротивлении конденсатора, но и низкое тепловое сопротивление, для рассеивания выделяемой на нем тепловой энергии.

Описанный выше режим работы электролитического конденсатора не соответствует стандартным режимам, в которых параметры и надежность конденсаторов гарантируется изготовителем, поэтому, для обеспечения надежности силового анализатора ВАХ при работе в режиме большого тока, требуется проведение экспериментальных исследований с последующим проведением испытаний на надежность для определения предельных значений выходного тока анализатора.

На рисунках 2Х, 2.Н, 2.Г, 2.Ж представлена разработанная схема электрическая принципиальная источника напряжения развертки, который определяет функциональные возможности канала коллектора.

Выбор вида развертки в канале С осуществляют путем включения одного из семи переключателей:

Режим формирования испытательного сигнала напряжения в диапазоне выходного тока до 200 А с помощью конденсатора.

В этом режиме силовая цепь источника напряжения состоит из накопительного конденсатора, полевого МОП-транзистора и нагрузки, в качестве которой обычно выступает объект тестирования.

В течение прямоугольного импульса напряжения, поступающего на затвор МОП транзистора, происходит разряд накопительного конденсатора. Точное значение напряжения на нагрузке обеспечивается с помощью глубокой ООС, которой охвачены МОП транзистор и ОУ с высоким коэффициентом усиления, используемый для формирования прямоугольных импульсов напряжения на затворе транзистора. Схема разработанного источника канала коллектора, формирующего мощные импульсы напряжения с помощью конденсатора, приведена ранее на рисунке 2.6.

Величина протекающего в цепи прямоугольного импульса тока определяется напряжением формируемого импульса и сопротивлением нагрузки. Для снижения рассеиваемой мощности в каждом из элементов силовой цепи источника напряжения и в нагрузке, которая также является элементом этой цепи, сокращают длительность импульсов и увеличивают их скважность. Например, скважность формируемых импульсов длительностью 100 мкс при длительности интервала между ними кратного периоду сети (50 Гц) и равного 60 мс, составит 600.

Максимальный постоянный ток используемого МОП транзистора (IXFN 180N20) в ключевом режиме равен 180 А, а его максимальный импульсный ток - 720 А. При этом, допустимая длительность импульса ограничена температурой кристалла, которая определяется рассеиваемой на транзисторе мощностью. То-есть, допустимое значение импульсного тока через транзистор зависит от длительности импульсов, их скважности и падения напряжения на канале транзистора в течение импульса.

При формировании с помощью МОП транзистора прямоугольных импульсов заданной амплитуды, транзистор работает не в ключевом, а в линейном режиме. Падение напряжения на канале МОП транзистора в течение импульса определяется разностью между напряжением питания и напряжением на нагрузке.

Для формирования, с помощью МОП транзистора прямоугольных импульсов напряжения заданной амплитуды и большой мощности (большого тока), необходимо дополнительно осуществлять регулировку напряжение питания транзистора, чтобы обеспечить снижение рассеиваемой на нем мощности, то есть более “комфортные” условия для МОП транзистора.

Напряжение питания транзистора необходимо регулировать так, чтобы обеспечить работу транзистора в линейном режиме, при формировании импульса напряжения заданной амплитуды на внешней нагрузке, конкретное сопротивление которой неизвестно. То есть, напряжение питания МОП транзистора должно, по сути дела, отслеживать и амплитуду импульсов напряжения, которую изменяют по известному закону для развертки измеряемой ВАХ, и амплитуду импульсов тока, которая определяется сопротивлением нагрузки в измеряемой точке ВАХ.

В общем случае, сопротивление нагрузки, например ПОТ, изменяется по нелинейному закону вплоть до короткого замыкания в случае пробоя или неправильного подключения. При этом, если разогрев кристалла транзистора за время импульса превысит допустимый порог, произойдет его необратимый пробой, и силовой анализатор, в состав которого входит этот транзистор, выйдет из строя.

Для исключения перегрузок элементов силовой цепи, проверка максимального значения выходного тока коллекторного источника и максимальной мощности, рассеиваемой на нагрузке во время импульса, проводилась в режиме ручной регулировки, как напряжения на нагрузке, так и напряжения на канале МОП транзистора. Измерение этих напряжений осуществлялось непосредственно в процессе ручной регулировки с помощью двухканального цифрового осциллографа С1-157/1 в режиме ждущего запуска.

В качестве первой нагрузки были использованы два, включенных параллельно проволочных резистора С5-43В-25 Вт–0.68 Ом, с суммарным сопротивлением 0,34 Ом и суммарной мощностью 50 Вт, а в качестве другой - тонкопленочный резистор МР9100 сопротивлением 0,1 Ом и мощностью 100 Вт, установленный на радиаторе. Длительность импульсов выбрана равной 220 мкс, длительность паузы между импульсами составляла 40 мс (два периода сети 20 мс). При этом, скважность формируемых импульсов составила около 181.

Регулировка напряжения питания силового транзистора осуществлялась с помощь рукоятки “РЕГУЛИРОВКА Uc, %”, расположенной на передней панели анализатора..

Численные результаты измерений для первой нагрузки 0,34 Ом представлены в таблице 5.2, а численные результаты измерений для второй нагрузки 0,1 Ом - в таблице 5.3.

При этом, численные значения установленного напряжения питания в процентах (Uпит, %) считаны с экрана анализатора, а значение напряжения питания в вольтах (Uпит, В) и напряжение на нагрузке Uн в вольтах определены по шкале нанесенной на экран осциллографа С1-157/1. В качестве напряжения питания Uпит указано его начальное значение, так как за время импульса происходит разряд накопительного конденсатора, величина которого пропорциональна величине тока и длительности импульса и обратнопропорциональна емкости накопительного конденсатора.

Напряжение на канале силового МОП транзистора Uтр соответствует разности напряжения питания и напряжения на нагрузке и рассчитано по следующей формуле Uтр = Uпит – Uн. Значение тока через транзистор Iт, мощности, рассеиваемой на транзисторе Ртр и мощности рассеиваемой на нагрузке Рн во время импульса также получены расчетным путем.

Таблица 5.2

Uпит, % | Uпит, В | Uн, В | Uтр, В | Iт, А | Ртр., Вт | Рн, Вт
35 | 20 | 10 | 10 | 29,4 | 294 | 294
40 | 23 | 15 | 5 | 44,1 | 220 | 661
50 | 29,5 | 20 | 10 | 58,8 | 588 | 1176
60 | 35,5 | 25 | 10 | 73,5 | 735 | 1837
70 | 42,5 | 30 | 12 | 88,2 | 1058 | 2646
85 | 49 | 40 | 10 | 117,6 | 1176 | 4704
100 | 57 | 50 | 10 | 147 | 1470 | 7350

Таблица 5.3

Uпит, % | Uпит, В | Uн, В | Uтр, В | Iт, А | Ртр., Вт | Рн, Вт
25 | 11 | 5 | 7 | 50 | 350 | 250
40 | 18 | 11 | 7 | 110 | 770 | 1210
70 | 31 | 20 | 11 | 200 | 2200 | 4000
95 | 40 | 30 | 10 | 300 | 3000 | 9000

Как видно из таблиц 5.1 и 5.2 максимальная амплитуда импульсов выходного тока составила 300 А, что превышает требования технического задания. Мощность рассеиваемая на транзисторе зависит от установленного значения напряжения питания и при максимальном токе составила 3000 Вт. При скважности импульсов равной 181, транзистор установленный на алюминиевой планке, выполняющей также роль радиатора, нагрелся на 8ºС. Изменение температуры определено с помощью цифрового мультиметра DT9208A, снабженного термопарой.

Максимальная мощность испытательного сигнала в импульсе, при амплитудном значении 30 В на нагрузке 0,1 Ом, составила 9000 Вт, что превышает требования технического задания.

При всех значениях тока, время установления импульса напряжения на нагрузке равнялось приблизительно 20 мкс что соответствует параметрам импульса поступающего на затвор транзистора, сформированным с помощью RC-цепочки на входе ОУ. Неравномерность вершины импульса, за счет глубокой ООС, оказалась лучше, чем можно было различить по горизонтальным линиям шкалы, нанесенным на экран ЭЛТ цифрового осциллографа.

В качестве накопительного конденсатора, обеспечивающего большое значение тока формируемых импульсов, используется электролитический конденсатор ALS3-472MF200 емкостью 4700 мкФ и напряжением 200 В.

Максимальное значение переменного тока частотой десять килогерц через этот конденсатор составляет около 19,1 А, при величине внутреннего сопротивления до 33 мОм.

Предметом экспериментальных исследований источника коллекторного напряжения в режиме формирования импульсов напряжения с помощью конденсатора, кроме максимальной величины выходного тока, является также надежность элементов силовой цепи (МОП транзистора и конденсатора) при работе в предельных режимах по току, напряжению и мощности в импульсе. Например, режим работы электролитических конденсаторов существенно отличается от стандартных режимов, в которых изготовители гарантируют их надежность.

Однако, проверка, а тем более исследование надежности силовых элементов, связаны с большими затратами времени. Поэтому, в связи с переносом изготовления макета анализатора на целый год, экспериментальные исследования надежности элементов силовой цепи, не проводились.

Команды оператора

Измерительные

каналы

Компьютер

Дисплей

Программное обеспечение

Анализатор ВАХ

Панель управления, манипулятор “мышь”

Рисунок 2.1 – Обобщенная структурная схема анализатора ВАХ ПП
