Sasha7b9Work/Linia/doc/РД/ИППП3/Aлгоритм   Линия-2/3_ Fорм.исп.сиг.с пом.кон. 29.05_.docx

Дополнение к «Fорм.испыт.сигн.с пом.контроллера от16.04.2025»

От 29.05.2025.

В файле (Fорм.испыт.сигн.с пом.контроллера) изложены задачи по формированию импульсных разверток. Здесь приведены дополнительные требования.

В режиме Высокого напряжения в канале С работает модуль «Источн. напряжения 3 кV».

В режиме Большого тока в канале С работает модуль «Источн. напряжения 200А».

При тестировании диодов импульсы формируют в канале С.

При тестировании транзисторов ─ импульсы формируют в канале В.

Режим Высокого напряжения

Правила формирования в режиме Высокого напряжения парных импульсов в канале С ENS Imp+ и ENS Imp- при развертке положительным напряжением и парных импульсов ENS Imp- и ENS Imp+ при развертке отрицательным напряжением приведены ранее ( файл Fорм.испыт.сигн.с пом.контроллера). Второй импульс, в данном случае, является размагничивающим.

В режиме Высокого напряжения, при формировании импульсной развертки по каналу В, в канале С должно формироваться пульсирующее (выпрямленное) напряжение выбранной полярности. Причем, импульсы в канале В должны соответствовать вершине синусоиды этой полярности. Размагничивающие импульсы в канал базы поступать не должны!!!

На рис.1 приведены временные диаграммы сигналов “ENS Sin+” и “ IMPb+v ” при формировании импульсной развертки (положительной полярности) по каналу В.

Рис.1 Временные диаграммы сигналов “ENS Sin+” и “ IMPb+v ”

Положение импульса IMPb+v на временной оси и его длительность соответствуют положению ENS Imp+, а положение IMPb-v на временной оси и его длительность – импульсу ENS Imp-, соответственно (см. файл Fорм.испыт.сигн.с пом.контроллера).

На рис.2 приведены временные диаграммы сигналов “ENS Sin-” и “ IMPb-v ” при формировании импульсной развертки (отрицательной полярности) по каналу В.

Рис.2 Временные диаграммы сигналов “ENS Sin-” и “ IMPb-v ”

Длительность импульсов IMPb+v и IMPb-v в режиме Высокого напряжения определяется установленным диапазоном выходного напряжения:

- в диапазоне ±30 В - 0,2 мс,

- в диапазоне ±300 В - 0,5 мс,

- в диапазоне ±3000 В - 1,0 мс.

Эти импульсы передают по одному проводу, фронт/спад импульсов в кабеле можно затянуть с помощью резистора 1 кОм, для уменьшения электромагнитного излучения.

Режим Большого тока

В режиме Большого тока длительность испытательных импульсов 100 мкс, 50 мкс, 20 мкс, 10 мкс устанавливает оператор.

Управляющий импульс должен поступать в виде парафазного сигнала на 2 блока:

- источник напряжения 200 А (канал коллектора) («IMPс+», «IMPс-»),

- канал базы («IMPb+», «IMPb-»).

Правила формирования этих сигналов, с привязкой к сигналу RUN, изложены ранее в файле (Fорм.испыт.сигн.с пом.контроллера) рисунки 4 и 5. Однако, название этих сигналов (ENS Imp+ и ENS Imp-) для режима Большого тока в файле было указано неправильно, из-за аналогии с режимом Высокого напряжения.

Далее эти сигналы будут называться («IMPс+», «IMPс-») для канала С и («IMPb+», «IMPb-») для канала В.

Важным условием является то, что эти сигналы должны заканчиваться через 2,5 ÷ 3 мкс после того фронта RUN, который формирует запуск АЦП (сигнал СNV).

В режиме «тестирование диода» импульсы 100 мкс, 50 мкс, 20 мкс, 10 мкс (активн.1) поступают только на плату «Источника большого тока», при этом на канал базы вместо импульсов должен поступать уровень «лог.1», соответствующий вершине импульса.

В режиме «тестирование транзистора» импульсы 100 мкс, 50 мкс, 20 мкс, 10 мкс (активн.1) поступают только на канал базы. В режиме Большого тока, при формировании импульсной развертки по каналу В, в канале С должно формироваться постоянное напряжение выбранной полярности. Для этого на «Источник напряжения 200 А» вместо импульсов должен поступать уровень «лог.1», соответствующий вершине импульса.

Режимы «тестирование диода» и «тестирование транзистора» задает оператор.

На рис.3 показана структурная схема подачи импульсных сигналов на каналы С и В и приведены требования к выходному уровню на линиях передачи при выключении импульсного режима в канале С и в канале В (вершине импульса соответствует уровень логической “1”).

Рис 3 Структура импульсных сигналов для каналов С и В и требования к выходному уровню на линии передачи при выключении импульсного режима в канале С и в канале В

После разработки схемы Э3 канала В, требования к выходному уровню на линии передачи при выключении импульсного режима, могут быть уточнены.

Требования к скважности испытательных сигналов.

В режиме Высокого напряжения, когда мгновенная мощность испытательного сигнала не превышает 150 Вт, испытательный сигнал достаточно формировать с интервалом не менее 1,5 периода сети (30÷40 мс), как было показано на рисунках 1 и 2 в файле (Fорм.испыт.сигн.с пом.контроллера).

В режиме Большого тока, когда мгновенная мощность испытательного сигнала достигает 10 кВт, испытательный сигнал целесообразно формировать с интервалом 20 периодов сети (0,4 сек), чтобы обеспечить достаточно большую скважность.

Баланс нуля мощного ОУ в Источнике напряжения 200 А

В Источнике напряжения 200 А использована аналоговая схема балансировки нуля мощного ОУ, основанная на запоминании выходного напряжения источника при отсутствии импульсов на входе.

Для функционирования этой схемы от контроллера необходим дополнительный сигнал EIMP (активный низкий уровень), включающий на короткое время режим запоминания.

В режиме Большого тока сигнал EIMP, длительностью от 5 до 10 мс, должен вырабатываться контроллером не реже чем через 5 ÷ 10 секунд в паузах между импульсами, которые в этом режиме должны составлять не менее 0,4 сек. То-есть 5÷10 мс в течение 400 мс.

В режиме Высокого напряжения сигнал EIMP постоянно остается низким (логич. ноль).
