Sasha7b9Work/Linia/doc/РД/ИППП3/Aлгоритм   Линия-2/Алг.изм.диода реж. БТ 8.10.26/Aлг. измер. ВАХ диода в реж.БТ.docx

Измерение ВАХ диода в режиме «БТ»

а) В процессе установки оператором режима измерения ВАХ, до появления сигнала ИЗМЕРЕНИЕ, необходимо вести анализ:

- выбранного типа развертки и соответственно ему отображать на панели управления только доступные диапазоны измерения тока в канале С (см. файл- Табл. Изм.Тока Линия2 (10.09.26)),

- выбранного диапазона источника напряжения 3 кВ и выбранного диапазона измерения тока в канале С и в соответствии с ними, готовить данные для записи в регистр источника напряжения 3 кВ (см. файл -Регистр.Табл.Ист. 3кВ..044 (11.09.26)).

В качестве примера приведена последовательность операций после появления сигнала ИЗМЕРЕНИЕ (рукоятка «U%» - режим характериографа - ручное управление амплитудой развертки – многократное измерение ВАХ, кнопка «ИЗМЕРЕНИЕ» или внешний запуск – автоматическое управление амплитудой развертки – однократное измерение ВАХ).

На этапе подготовки к измерению необходимо:

1БТ - записать регистры блоков согласно режиму измерения установленному оператором на этапе а), например, в следующем порядке:

- регистр?, определяющий режим работы ПЛИС,

- измеритель тока,

- формирователь развертки и измеритель напряжения (ЦАП, который входит в состав измерителя напряжения в качестве делителя сигнала, записывать вместе с регистром),

- регистр источника 3 кВ,

- канал В,

- канал S,

- коммутатор

(в порядке обсуждения: коммутатор подключает гнезда В и S к выходам соответствующих каналов, только если заданы какие-нибудь параметры по этим каналам).

На этапе подготовки к измерениям, в «динамические» ЦАПы (№1 в блоке формирователя развертки и №2 в блоке источника напряжения 50 В) ничего не записывают.

2БТ - проанализировать установленную полярность испытательных импульсов.

Если установлен диапазон +50В, то напряжение питания, регулируемое в этом режиме «динамическим» ЦАПом №1, должно на ≈15 В превышать напряжение испытательного импульса, формируемое ЦАПом №2.

(ЦАП №1 проградуирован в % от максимального напряжения установленного диапазона. Код максимального напряжения каждого из диапазонов 30 В, 300 В, 300 В устанавливают при калибровке. Эти коды д.б. записаны в калибровочном файле)

Если установлен диапазон -50В, то напряжение питания, регулируемое в этом режиме «динамическим» ЦАПом №1, должно быть приблизительно на -25 В ниже отрицательного напряжения испытательного импульса, формируемого ЦАПом №2.

Начальные коды ЦАПа №1 для обоих случаев (15 В и 22 В) будут определены экспериментально. Правило изменения кода в ЦАПе №1 в соответствии с кодом в ЦАПе №2 будет выработано позже.

(ЦАП №2 проградуирован в вольтах, максимальное напряжение 50 В. Код максимального напряжения устанавливают при калибровке. Этот код д.б. записан в калибровочном файле)

Определяют коды, которые должны быть записаны в «динамические» ЦАПы №1 и №2 для формирования 1го, 2го, 3го и всех последующих испытательных импульсов, т.е. формируют импульсную ступенчатую развертку для получения искомой ВАХ диода, состоящей из 10ти, 20ти, 50ти или 100 точек, указанных оператором.

Величина дискрета для каждого из динамических ЦАПов будет определена позже.

Сначала записывают код в динамический ЦАП №1.

Этот код должен быть записан не ранее чем через 5 мс после окончания записи кода в регистр источника 3 кВ, (чтобы учесть дребезг контактов герконов см. алгоритм работы общий).

В режиме «БТ» ПЛИС должна формировать сигнал ENS соответствующий режиму +DC или -DC, который обеспечивает непрерывную работу трансформатора, что необходимо для заряда накопительных электролитов в источнике 50 В. (см. файл «5_ Испр.диаграм.-Сигналы Limit»)

Поскольку этот сигнал непрерывный, запись кода в динамический ЦАП №1 можно проводить без привязки к фронту/срезу сигнала ENS.

Через 400 мс после записи кода в ЦАП №1 (за это время должны полностью зарядиться электролитические конденсаторы и появится напряжение на выходном каскаде источника 50 В) можно вести запись кода в ЦАП №2, который установит выходное напряжение источника 50 В.

3БТ - Испытательные импульсы в режиме «БТ» формируют без синхронизации с сетью 50 Гц, поэтому после записи кода в ЦАП №2, можно, после времени установления напряжения в блоке 50 В (50-100 нс), формировать с помощью ПЛИС 1й импульс требуемой длительности из ряда 10 мкс, 20 мкс, 50 мкс, 100 мкс, и за 1 мкс до его окончания сигнал RUN для запуска 4-х АЦП.

После стробирования сигналом RUN 1й точки ВАХ, в ЦАПы №1 и №2 записывают коды, соответствующие 2-му испытательному импульсу и формируют интервал задержки между испытательными импульсами, величиной 0,4÷0,5сек для заряда конденсаторов.

Процесс измерения ВАХ по точкам длится до считывания с АЦП последней указанной оператором точки. Затем, измерения прекращают, если был установлен однократный режим, или начинают следующий цикл, если выбран многократный режим (характериографа).
