Sasha7b9Work/Linia/sources/scripts/arm64/_old/README.md

git# Сборка для Orange Pi 5 Plus (ARM64)

Данная директория содержит скрипты для сборки проекта Linia на одноплатном компьютере Orange Pi 5 Plus с процессором RK3588 (ARM64) под управлением Ubuntu 24.04 и KDE Neon Plasma.

## Последовательность сборки

### 1. Установка зависимостей
```bash
cd sources/scripts/arm64
chmod +x install_soft_arm64.sh
./install_soft_arm64.sh
```

### 2. Полная сборка проекта
```bash
chmod +x full_build_arm64.sh
./full_build_arm64.sh
```

### 3. Запуск приложения

⚠️ **Важно**: Linia2 - это GUI приложение, требующее графическое окружение!

#### Проверка готовности системы:
```bash
chmod +x diagnose_gui.sh
./diagnose_gui.sh
```

#### Автоматический запуск с настройкой дисплея:
```bash
chmod +x run_with_display.sh
./run_with_display.sh
```

#### Ручной запуск:
```bash
cd ../../generated/Linia2
./Linia2
```

#### Если возникает ошибка "Unable to initialize GTK+":

1. **Для локального запуска**: войдите в графическую сессию KDE
2. **Для SSH подключения**:
   ```bash
   ssh -X пользователь@orangepi_ip
   # или для trusted connections:
   ssh -Y пользователь@orangepi_ip
   ```
3. **Для VNC**: установите VNC сервер для удаленного доступа к рабочему столу
4. **Виртуальный дисплей** (для headless серверов):
   ```bash
   sudo apt install xvfb
   export DISPLAY=:99
   Xvfb :99 -screen 0 1024x768x16 &
   cd ../../generated/Linia2 && ./Linia2
   ```

## Устранение проблем

### Общие проблемы сборки
Если при сборке возникают ошибки, проверьте:

1. Установлены ли все зависимости:
   ```bash
   ./install_soft_arm64.sh
   ```

2. Корректность путей к библиотекам
3. Достаточность свободного места на диске

## Особенности ARM64 сборки

- Используется флаг `-march=armv8-a` для оптимизации под ARM64
- Автоматическое определение путей к библиотекам для aarch64
- Поддержка нескольких архитектур в одном CMakeLists.txt
- Отладочная информация о найденных библиотеках

## Проверка архитектуры

Скрипты автоматически определяют архитектуру системы и выводят предупреждения при несоответствии.

## Требования к системе

- Ubuntu 24.04 (или совместимая)
- KDE Neon Plasma
- ARM64/aarch64 архитектура
- Минимум 4 ГБ ОЗУ для сборки
- 2 ГБ свободного места на диске
