Sasha7b9Work/Linia/doc/РД/_Archiv/Что такое Линия 2/Разработка КОНЦЕПЦИИ Ист.напряж..docx

Вопросы Грицеву от 19.03.2025

Варианты конструкции канала С

1 Принцип построения ряда резисторов защиты (сколько штук) ??

2 Диапазоны напряжения в реж. Высокого напряжения (ВН) – 3000 В, 300 В, 30 В.

При мощности трансф. ~150 Вт получим максимальные токи: 50 мА, 0,5 А, 5 А.

Макс.ток герконов ≤2 А при U 7000÷10000 В (реле), ≤5 А при U 250 В, ≤3 А при U 7500 В это значит, что в диапазоне ±30 В придется устанавливать по 2 геркона параллельно!!

(При мощности трансф. ~210 Вт получим максимальные токи: 75 мА, 750 мА, 7,5 А.).

3 Разбиение диапазонов тока в реж. ВН может быть: от 10 нА до 5 А ?? (при макс. усилении Uш в измерителе тока – 40 раз). Диапазона тока 10 А в реж. ВН нет?????

4 Макс. напряжение в реж. Большого тока – 50 В, макс. ток 200 А (500 А)??

5 Диапазоны тока в реж. Большого тока (БТ): 200 А и 20 А (усиление Uш в 10 раз), или

500 А, 200 А (усиление Uш в 2,5 раза) и 5 А (усиление Uш в 100 раз)???

6 Если выбрать максимальный диапазон тока в реж. ВВ - 10 А (на 10 А придется параллелить по 3 геркона, а от трансформатора потребуется мощность 300 Вт), или можно добавить диапазон 15 В (в Л2-56 – 16 В) и 8 доп. герконов (по 4 шт ||).

7
