Sasha7b9Work/Linia/doc/MCU/doc/РД/Schematic/kont_lineJ_1.pdf

C40

C26

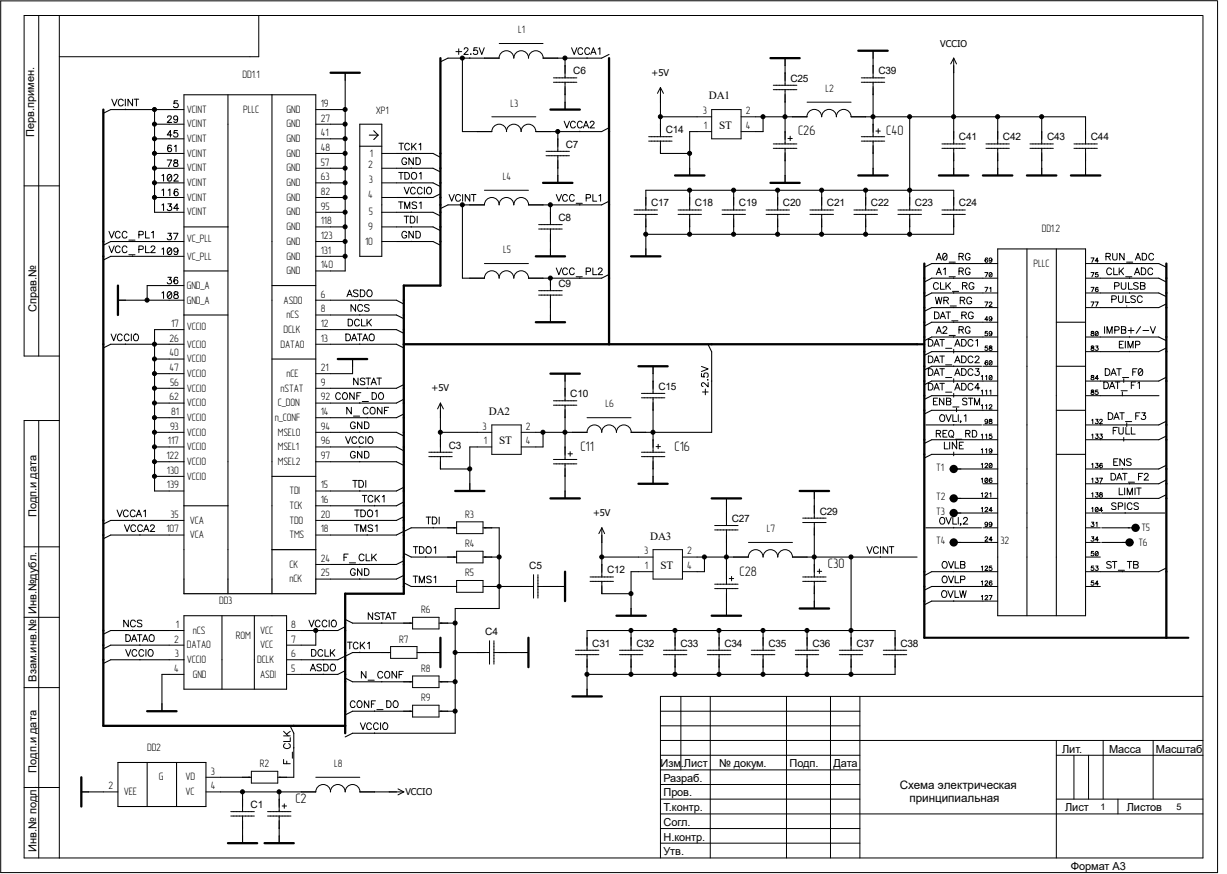
[picture p97: page 1]

VCINT VCINT VCINT VCINT | GND GND GND GND GND GND

VC_PLL | | 123

T6 Подп.и дата Взам.инв.№ Справ.№

17 | | 8
VCCIO VCCIO VCCIO VCCIO VCCIO VCCIO VCCIO VCCIO VCCIO VCCIO VCCIO | 12
26 40 | | 13

47 | nCE nSTAT C_DON n_CONF MSEL0 MSEL1 MSEL2
56 | | 9
62 | | 92
81 | | 14
93 | | 94

Схема электрическая принципиальная | Лит. | Масса | Масштаб

Изм.Лист | № докум. | Подп. | Дата
Разраб.
Пров.
Т.контр. | | | | Лист 1 | Листов 5
Согл.
Н.контр.
Утв.

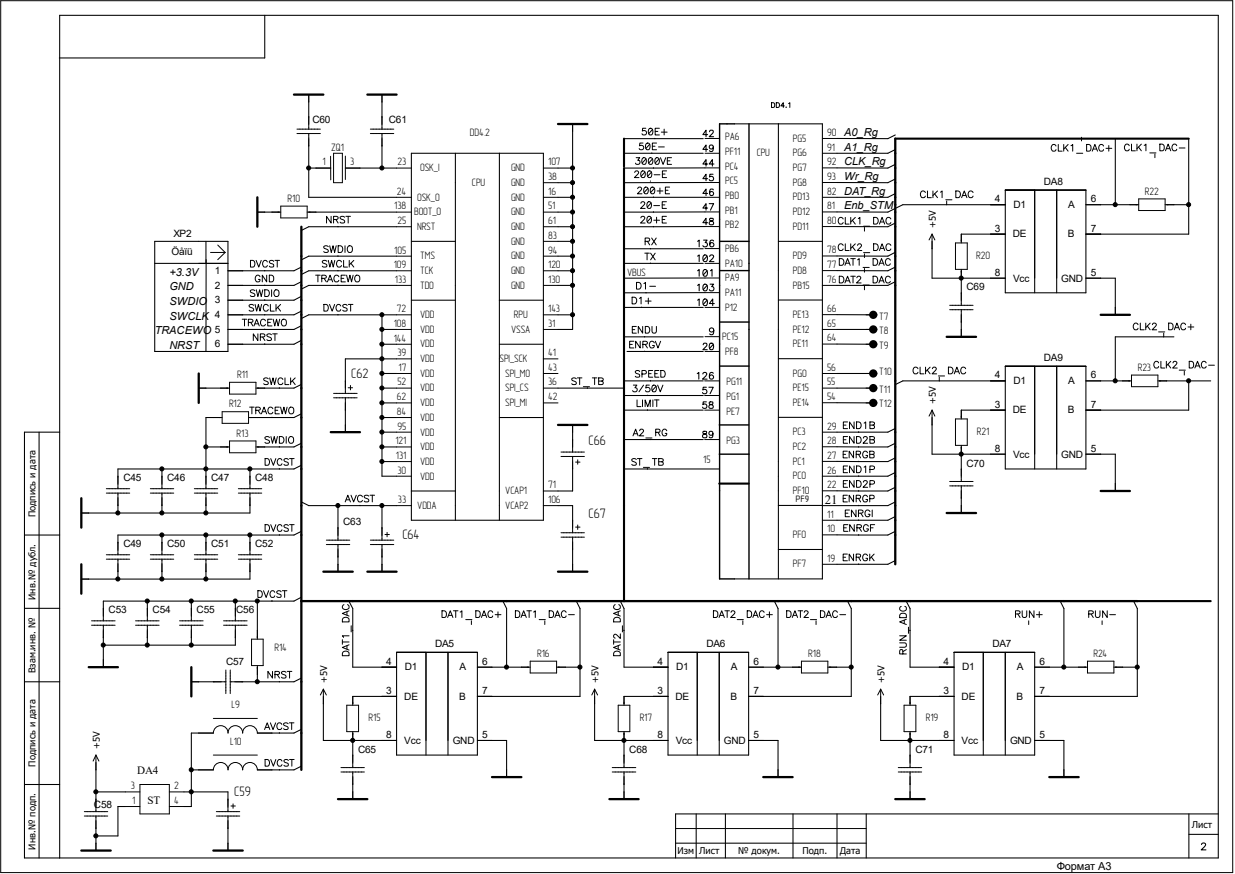
[picture p98: page 2]

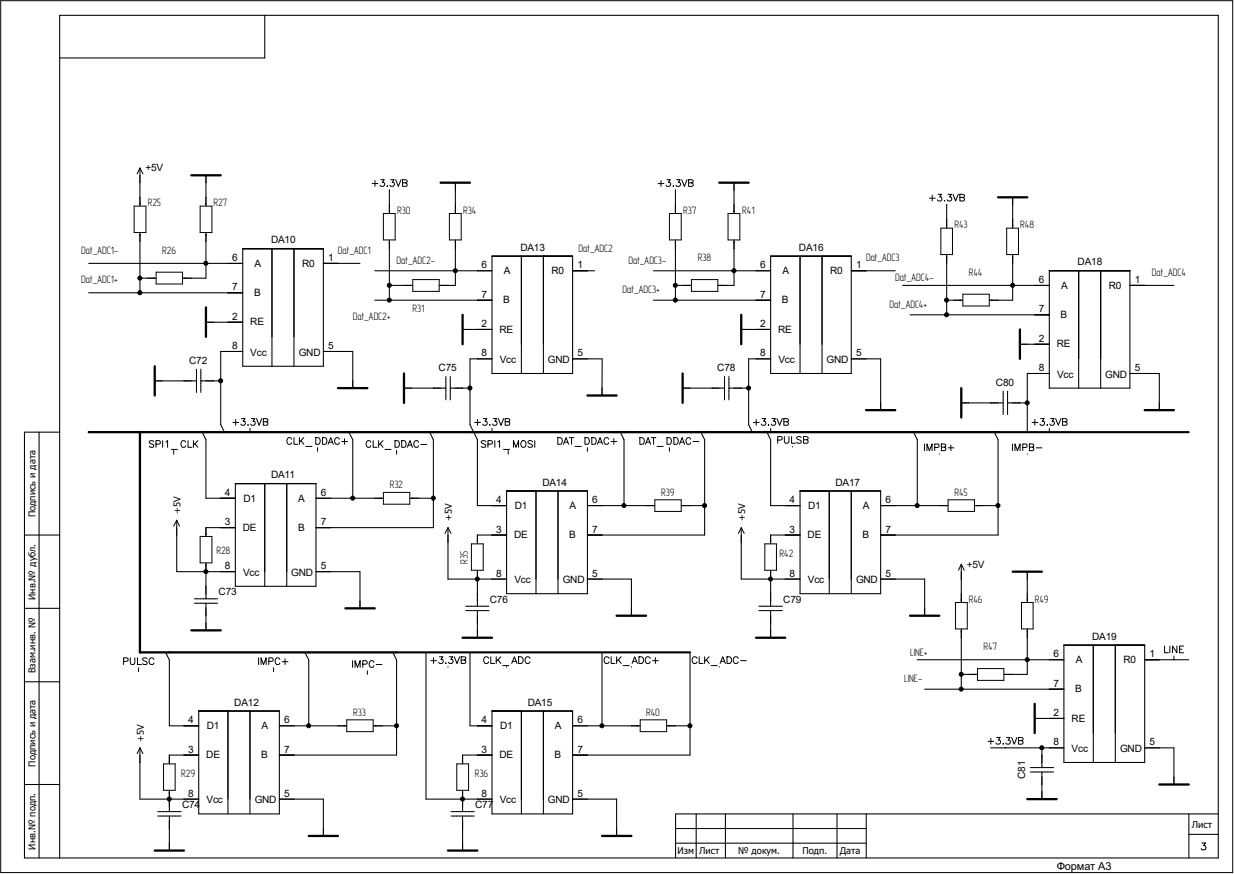
[picture p99: page 3]

XP3.2
XP3.1

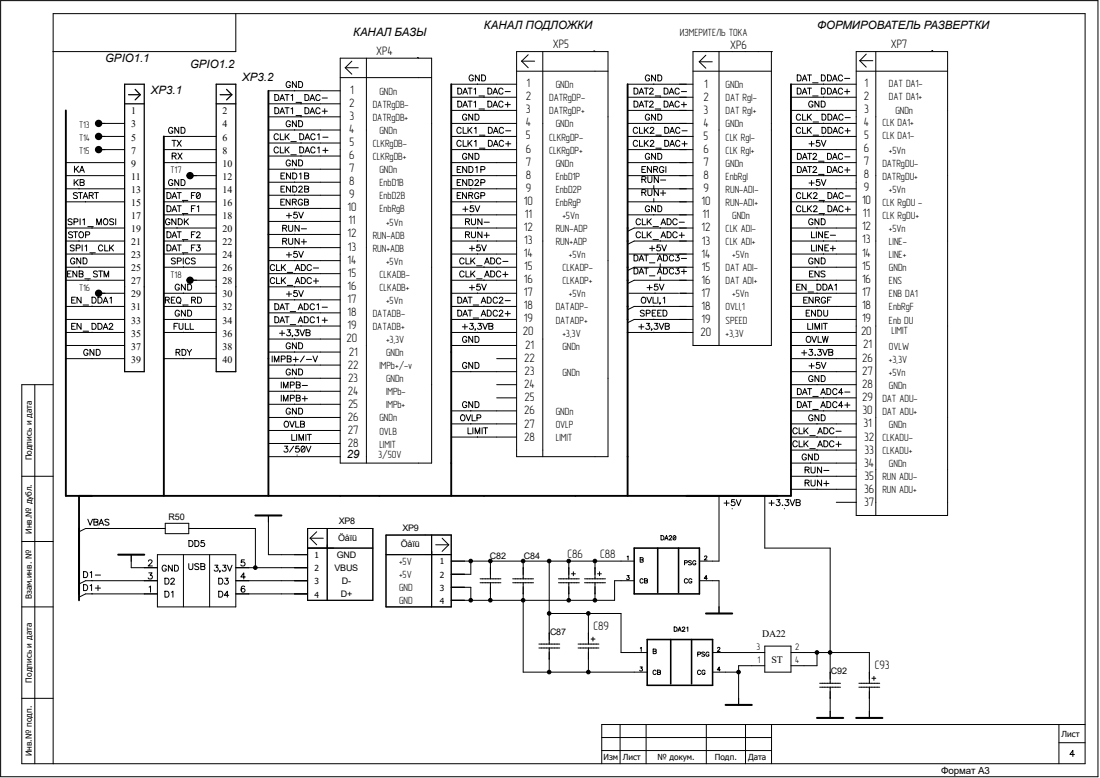
[picture p100: page 4]

Формат А3 Инв.№ подп. Подпись и дата Взам.инв. № Подпись и дата Инв.№ дубл.

Öåïü
4312 | GND VBUS D-D+

+5V +5V GND GND | 4312

XP13

XP10

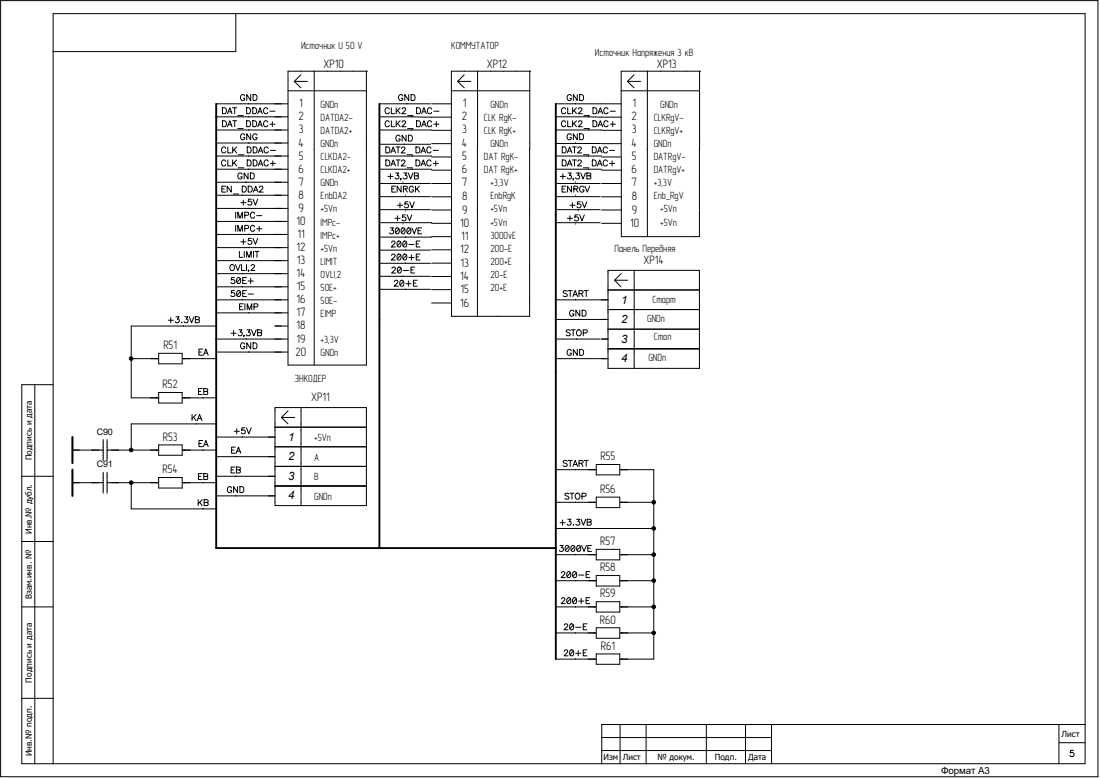
[picture p101: page 5]

Старт
GNDn
Стоп
