Sasha7b9Work/Linia/doc/_Контроллер/РД/Schematic/Контроллер_2026-08-21.pdf

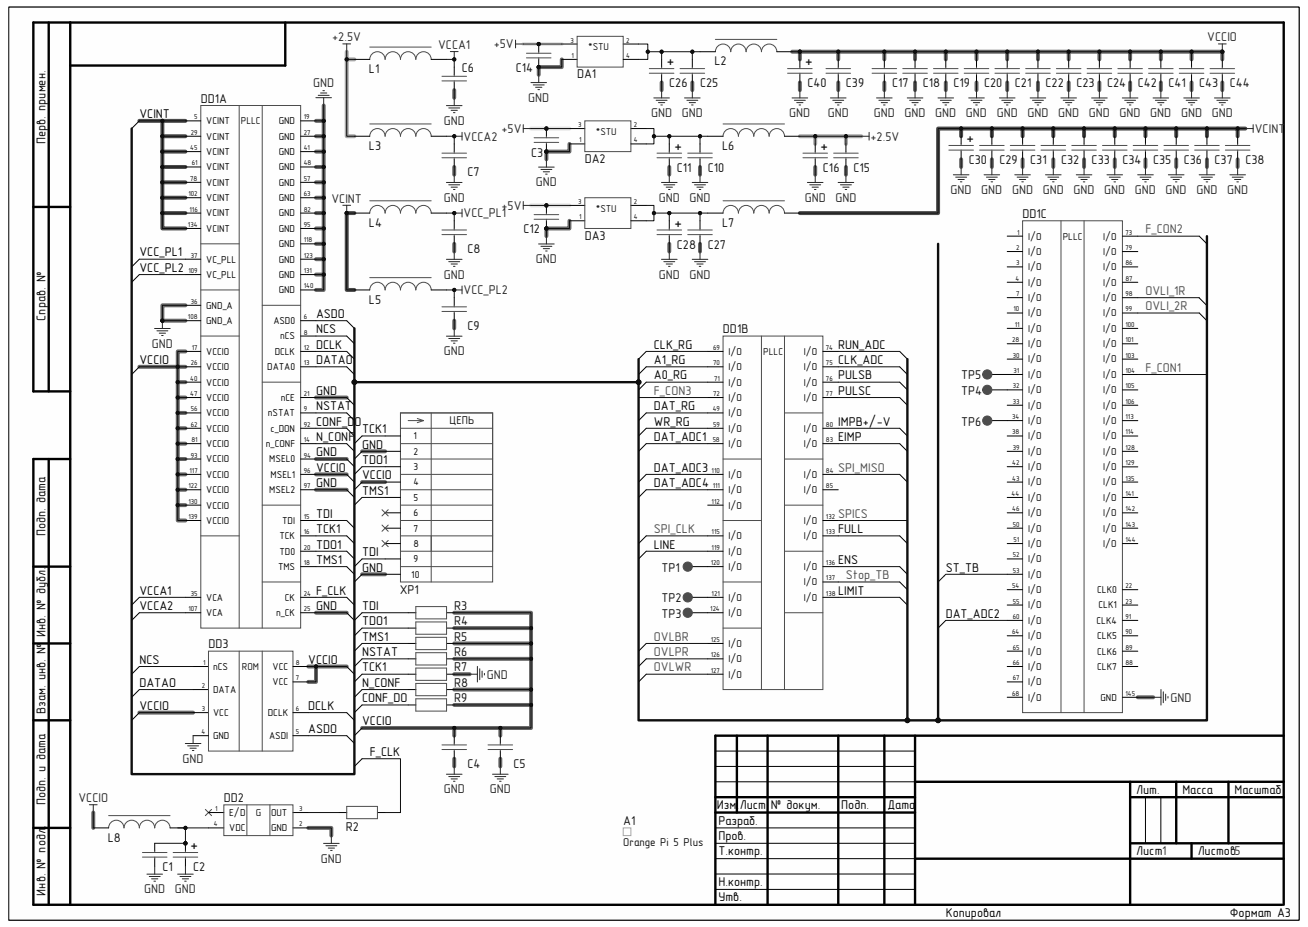
[picture p102: page 1]

Формат А3 Инв. № подл. Подп. и дата Взам. инв. № Инв. № дубл. Подп. дата Справ. № Перв. примен.

Лит. | Масса | Масштаб

Изм.Лист | № докум. | Подп. | Дата
Разраб.

Н.контр.
Утв.

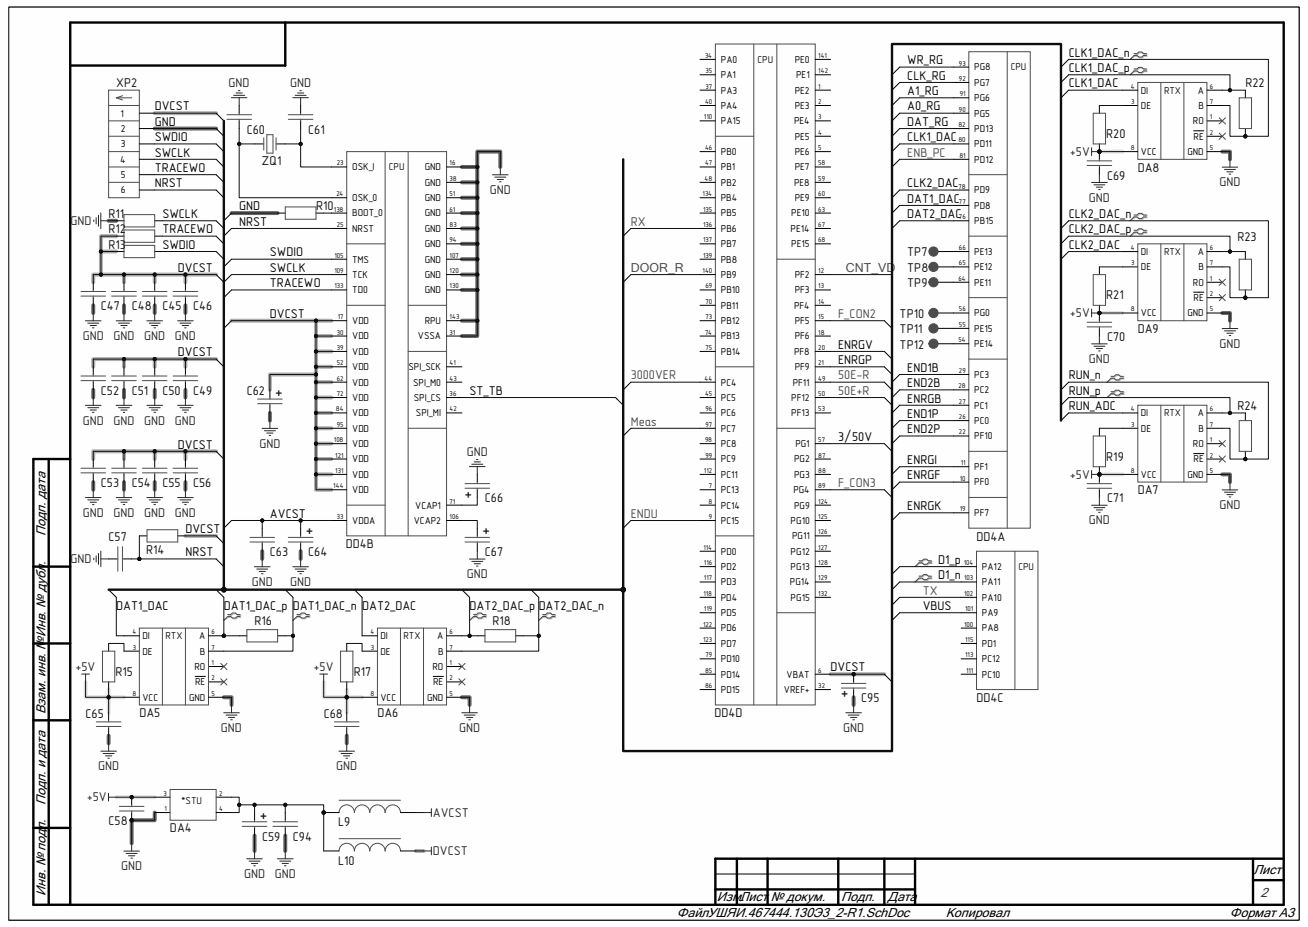
[picture p103: page 2]

Формат А3 Инв. № подл. Подп. и дата Взам. инв. №Инв. № дубл. Подп. дата

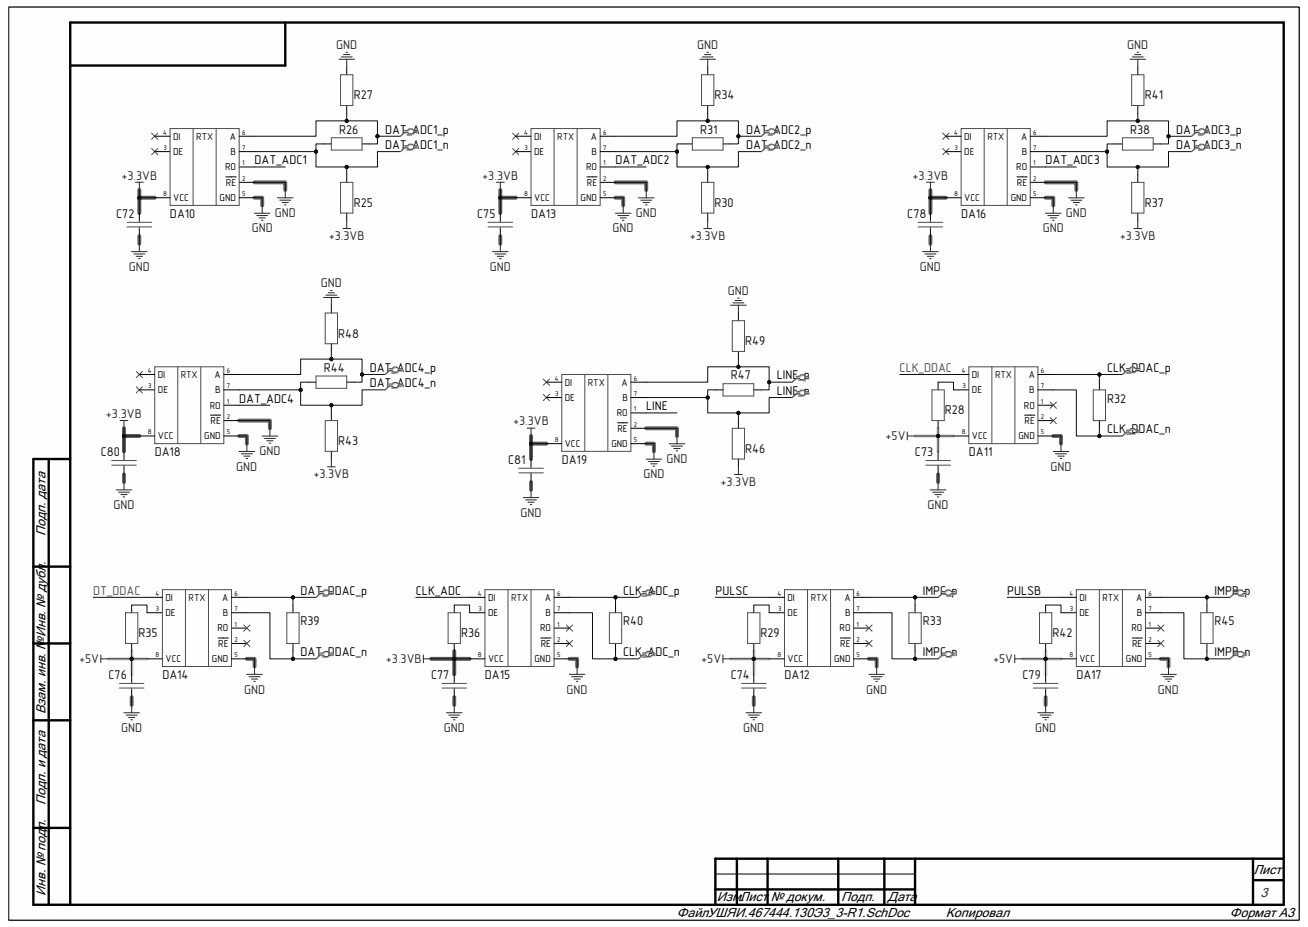
[picture p104: page 3]

Формат А3 Инв. № подл. Подп. и дата Взам. инв. №Инв. № дубл. Подп. дата

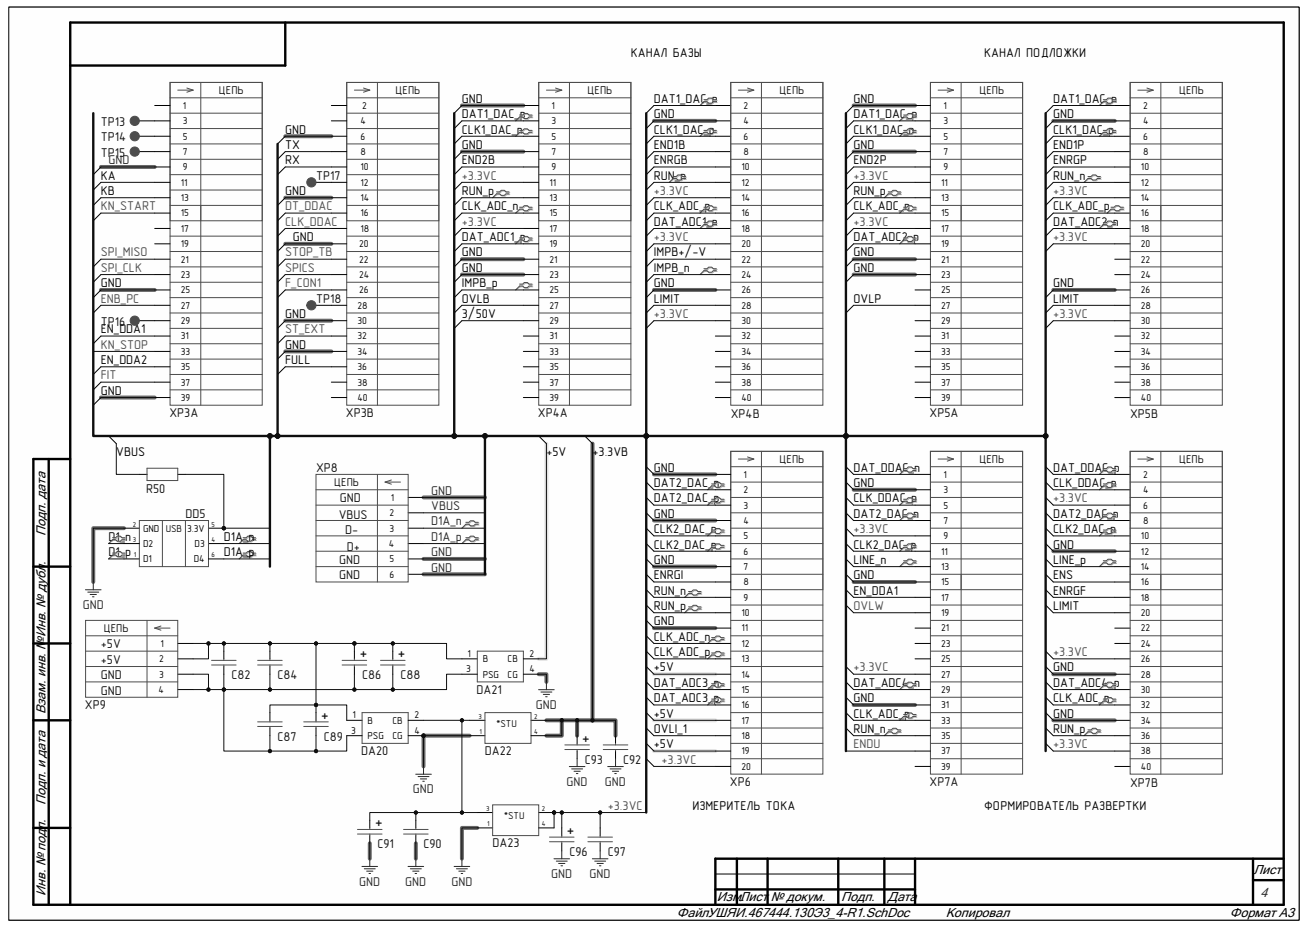
[picture p105: page 4]

Формат А3 Инв. № подл. Подп. и дата Взам. инв. №Инв. № дубл. Подп. дата

XP11 12345

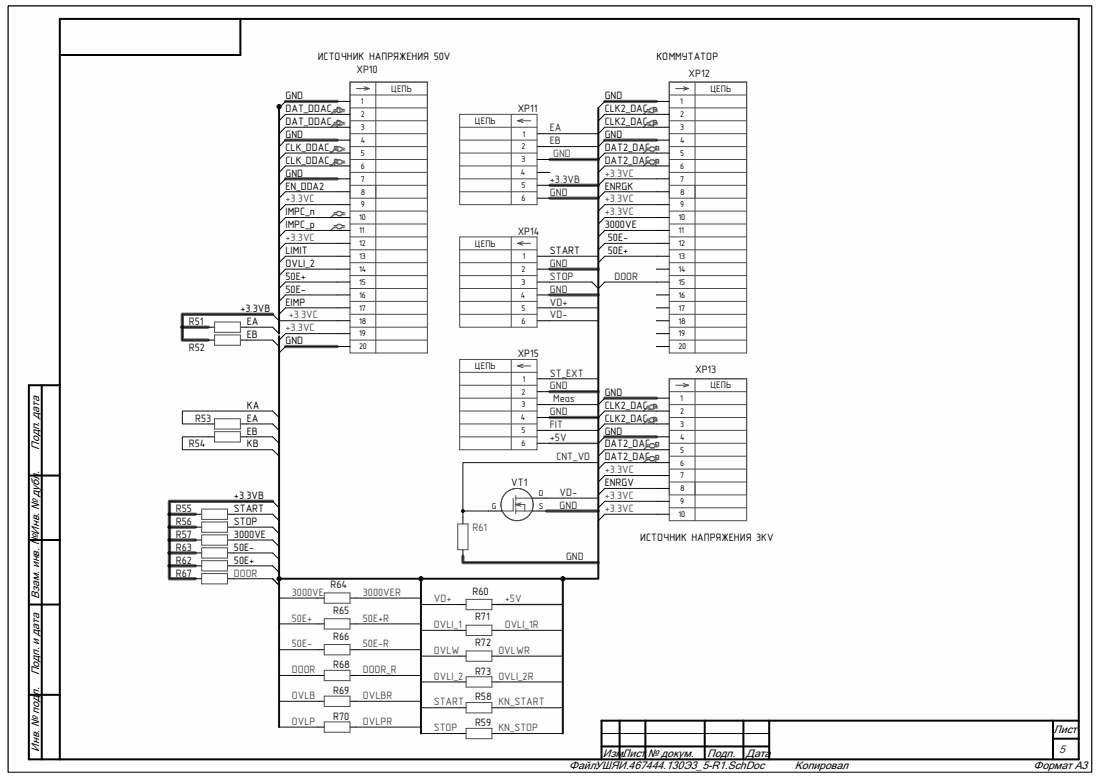
[picture p106: page 5]

Формат А3 Инв. № подл. Подп. и дата Взам. инв. №Инв. № дубл. Подп. дата
