Sasha7b9Work/Linia/doc/_Контроллер/РД/Schematic/_old/kont_lineP-b.pdf

DD1.2

DD1.1

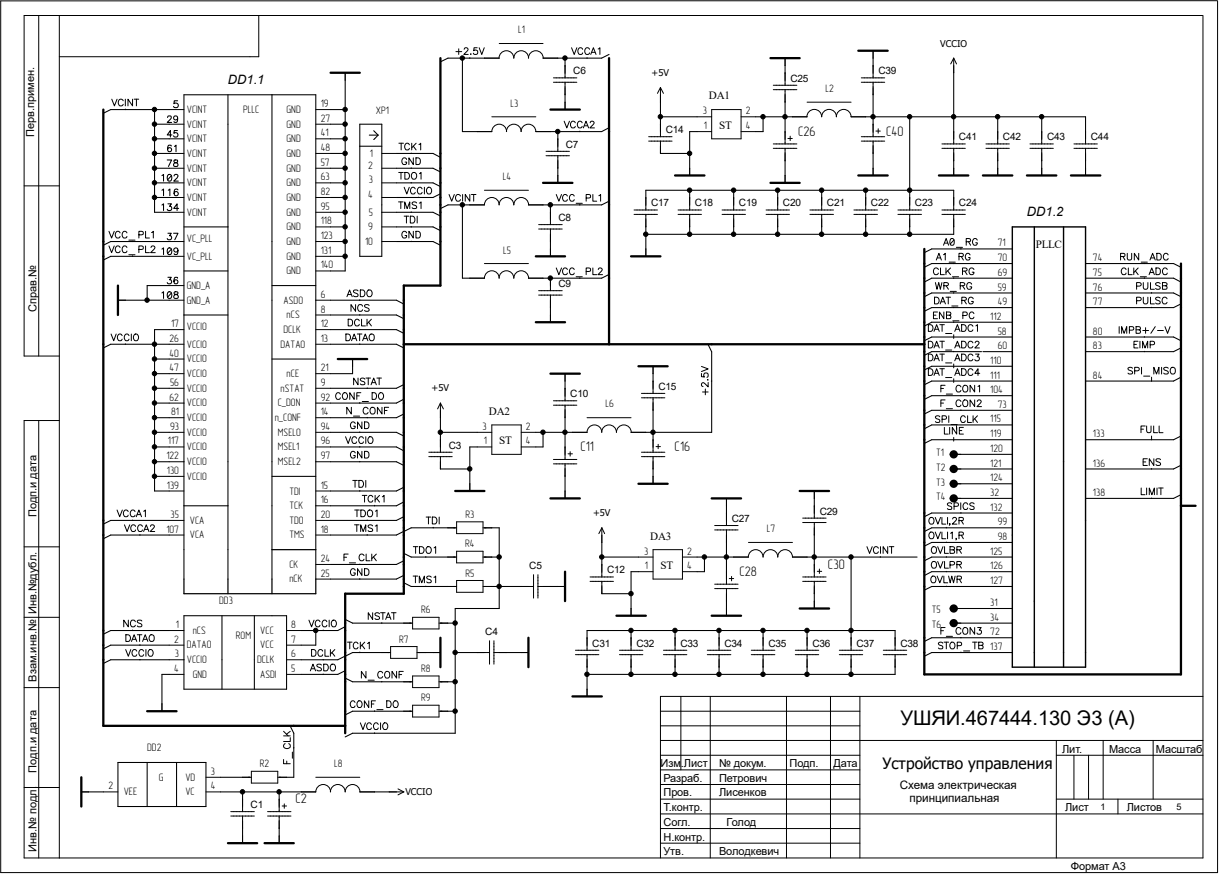
[picture p107: page 1]

133 Инв.№ подл. Подп.и дата Перв.примен.

VCINT VCINT VCINT VCINT | GND GND GND GND GND GND

VC_PLL | | 123

75 Подп.и дата Взам.инв.№ Справ.№

17 | | 8
VCCIO VCCIO VCCIO VCCIO VCCIO VCCIO VCCIO VCCIO VCCIO VCCIO VCCIO | 12
26 40 | | 13

47 | nCE nSTAT C_DON n_CONF MSEL0 MSEL1 MSEL2
56 | | 9
62 | | 92
81 | | 14
93 | | 94

УШЯИ.467444.130 Э3 (A)

Устройство управления Схема электрическая принципиальная | Лит. | Масса | Масштаб

Изм.Лист | | № докум. | Подп. | Дата
Разраб. | | Петрович
Пров. | | Лисенков
Т.контр. | | | | | Лист 1 | Листов 5
Согл. | Голод
Н.контр.
Утв. | Володкевич

DD4.1

DD4.2

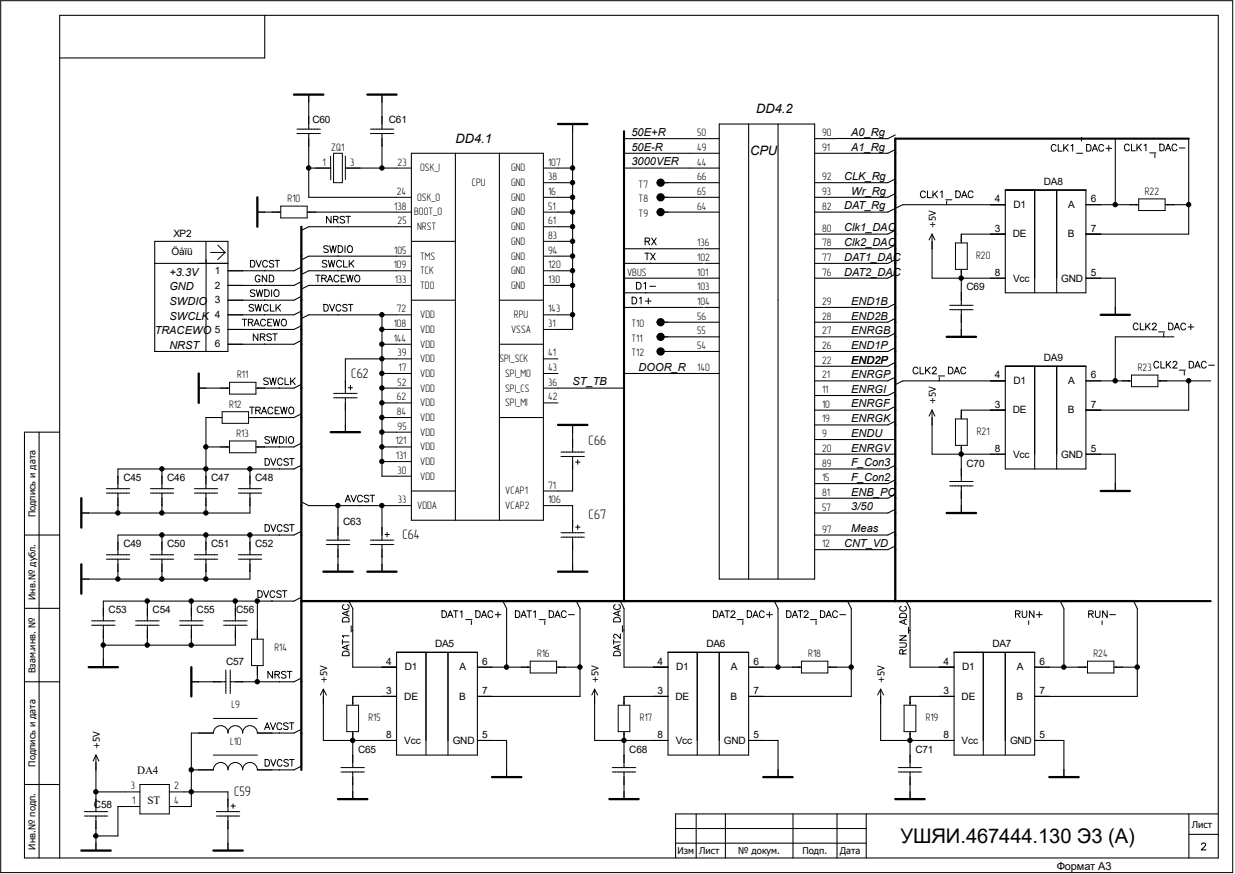
[picture p108: page 2]

VDD VDD VDD VDD VDD VDD | RPU VSSA
108 | | | 31
144 | | | 41
39 | | SPI_SCK SPI_M0 SPI_CS SPI_MI
17 | | | 43
52 | | | 36
62 | | | 42

9 Инв.№ подп. Взам.инв. № Инв.№ дубл. Подпись и дата

УШЯИ.467444.130 Э3 (A)

Изм | № докум. | Подп. | Дата

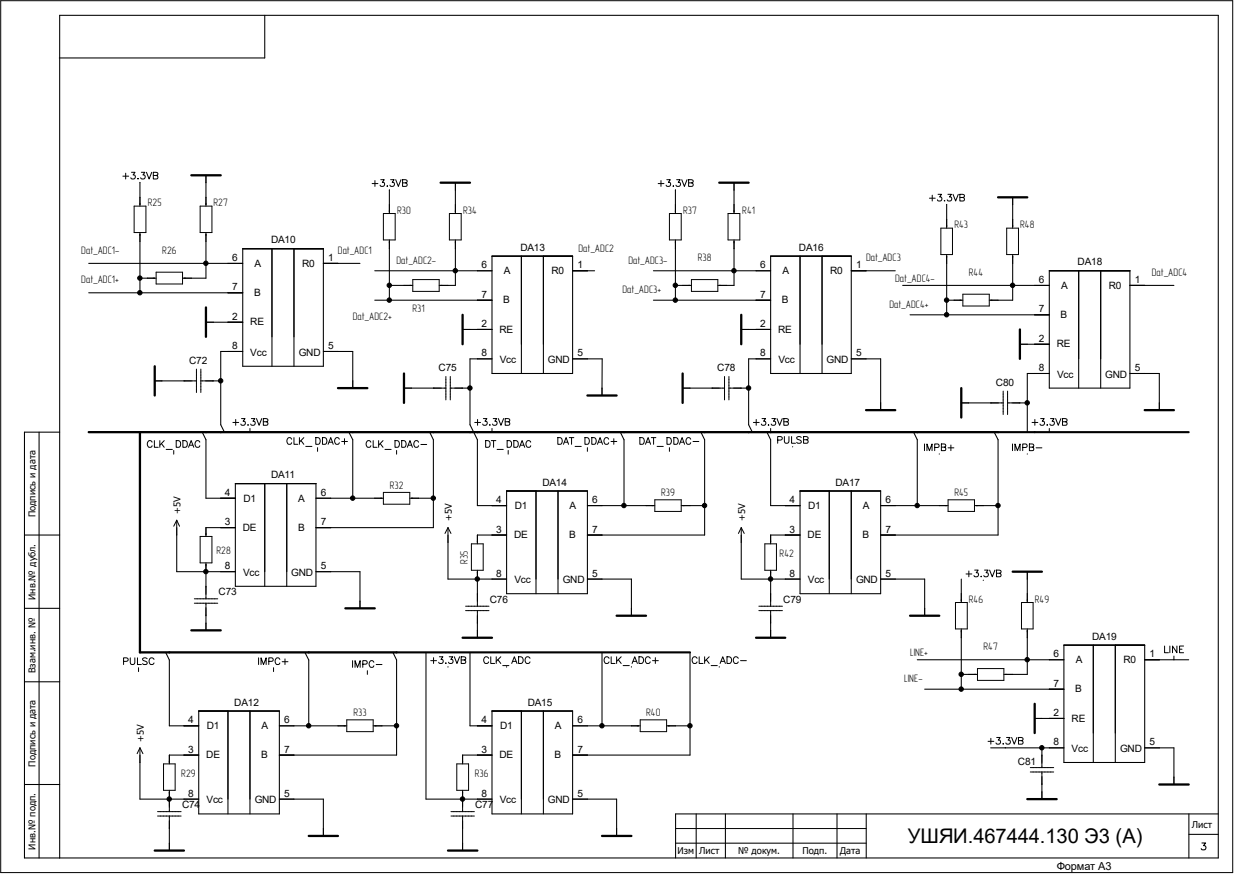
[picture p109: page 3]

XP3.2

199

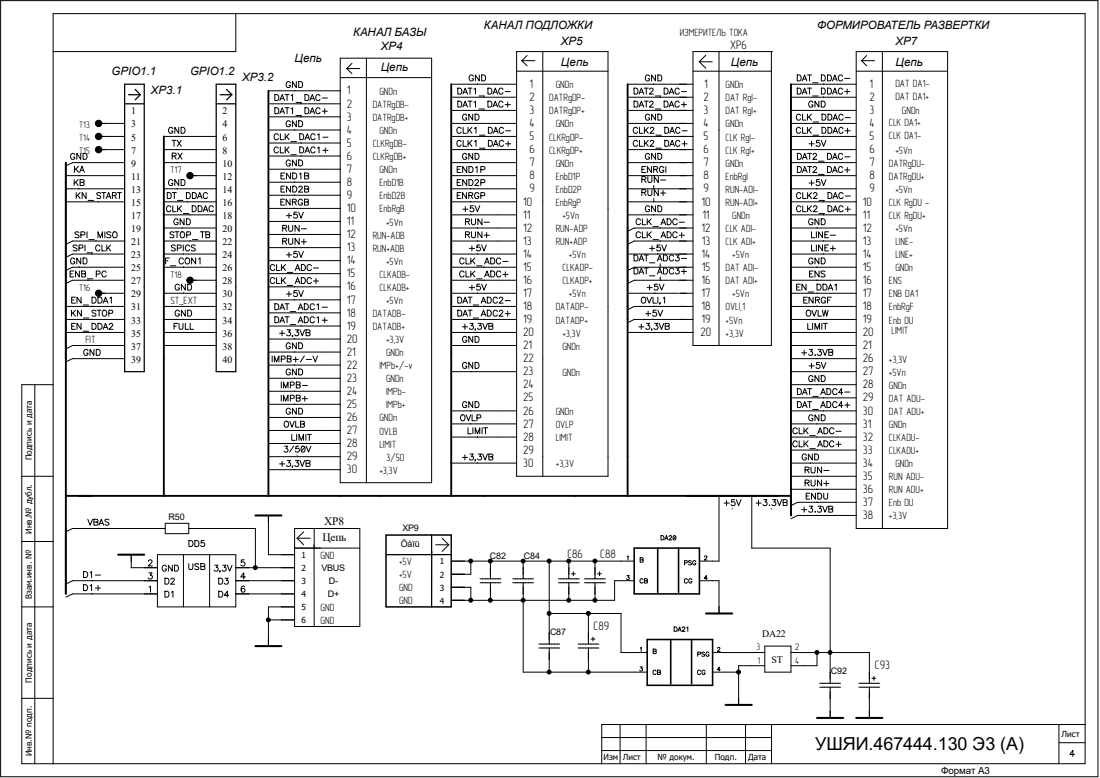
[picture p110: page 4]

Формат А3 Инв.№ подп. Подпись и дата Взам.инв. № Подпись и дата Инв.№ дубл.

Цепь
421635 | GND VBUS D-D+ GND GND

Öåïü
+5V +5V GND GND | 4312

## Цепь

## Цепь

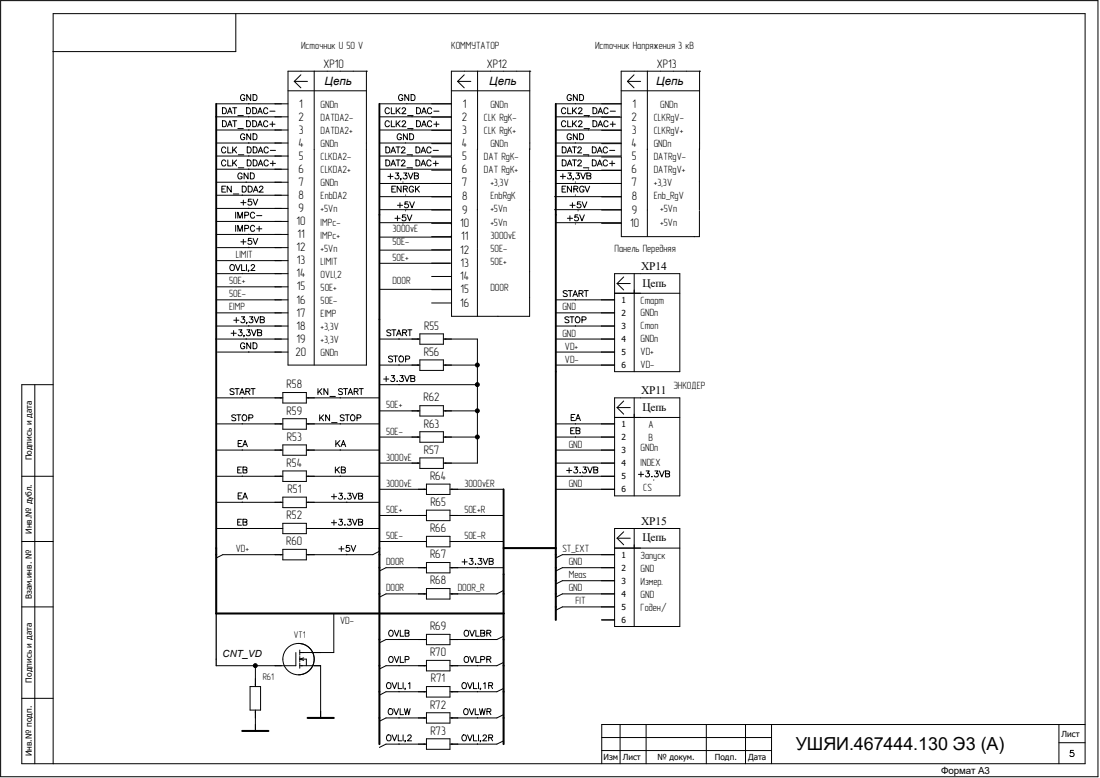
[picture p111: page 5]

CSAB Инв.№ подп. Подпись и дата Взам.инв. № Подпись и дата Инв.№ дубл.
