Sasha7b9Work/Linia/doc/_Контроллер/РД/Schematic/_old/kont_lineJ.pdf

C40

C26

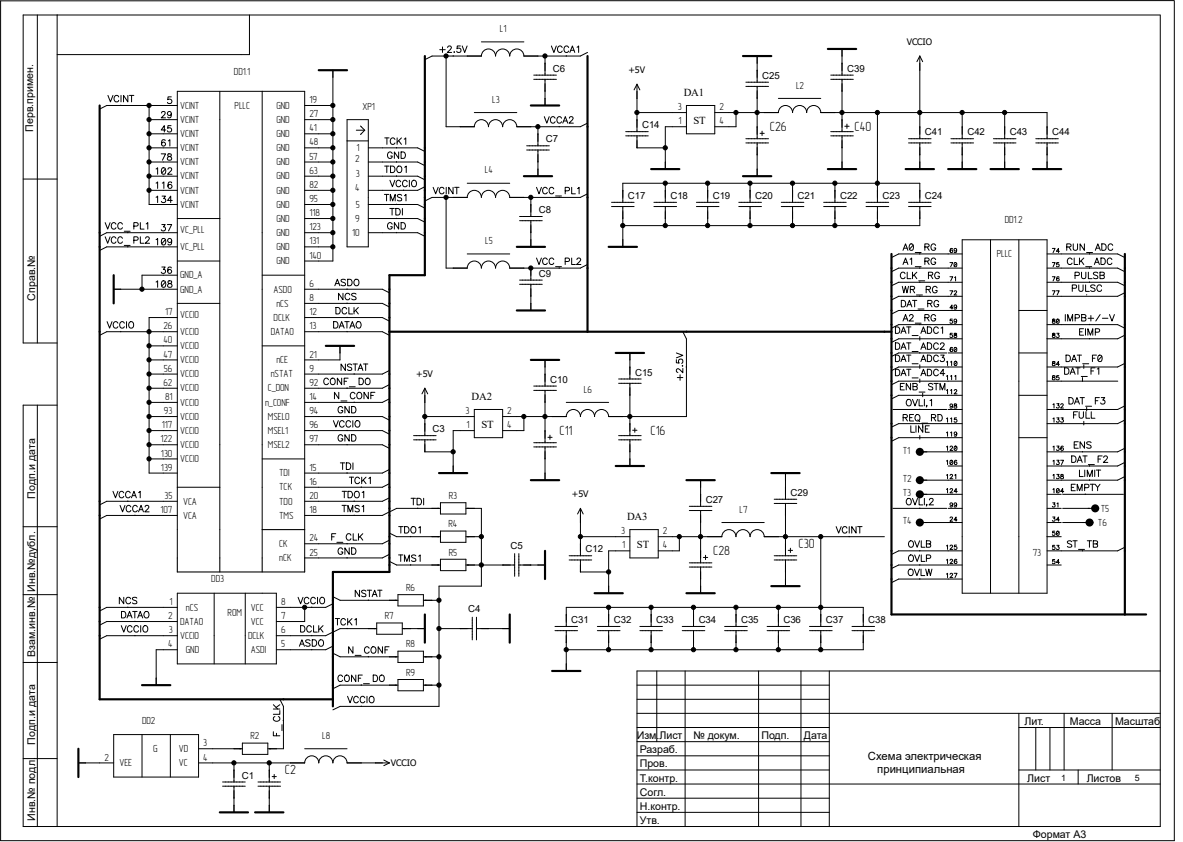
[picture p112: page 1]

VCINT VCINT VCINT VCINT | GND GND GND GND GND GND

VC_PLL | | 123

T6 Подп.и дата Взам.инв.№ Справ.№

62 | 92
81 | 14
93 | 94

Схема электрическая принципиальная | Лит. | Масса | Масштаб

Изм.Лист | № докум. | Подп. | Дата
Разраб.
Пров.
Т.контр. | | | | Лист 1 | Листов 5
Согл.
Н.контр.
Утв.

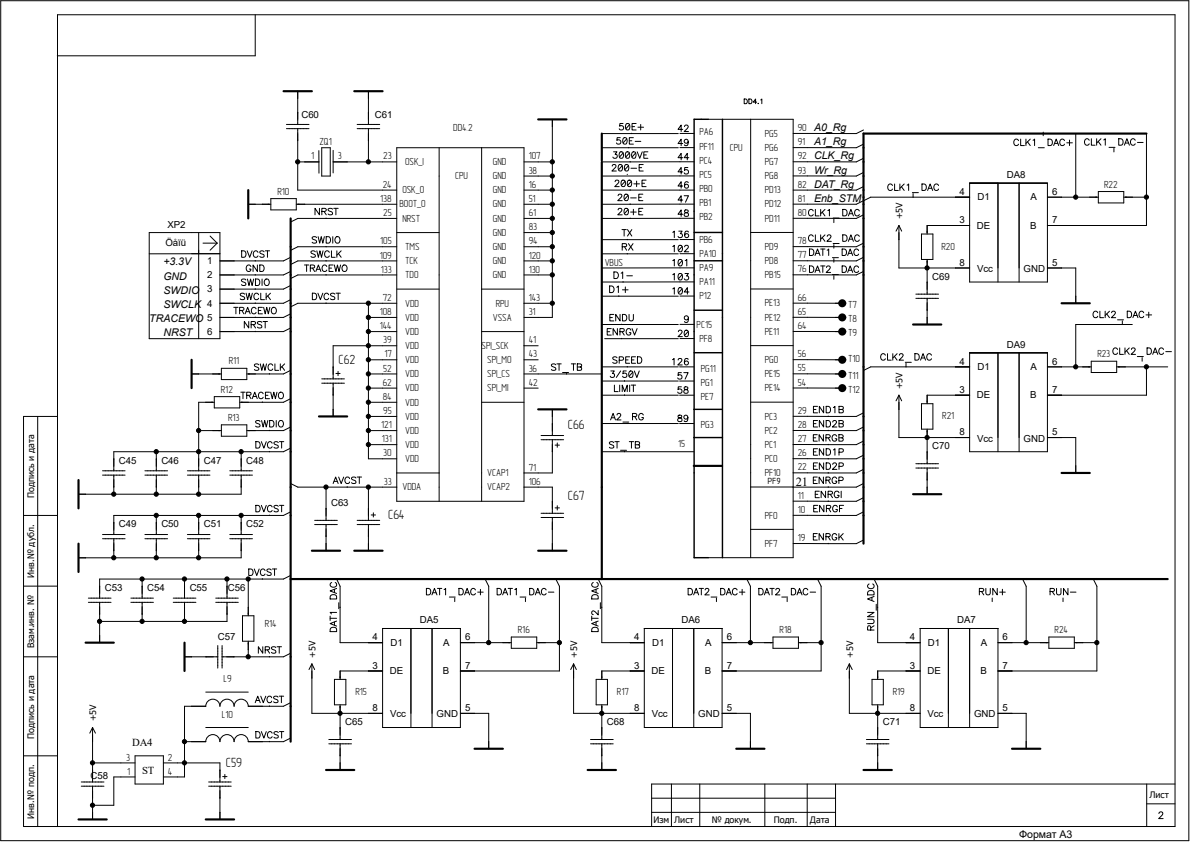
[picture p113: page 2]

OSK_I OSK_O BOOT_0 NRST | GND GND GND GND GND GND GND GND GND

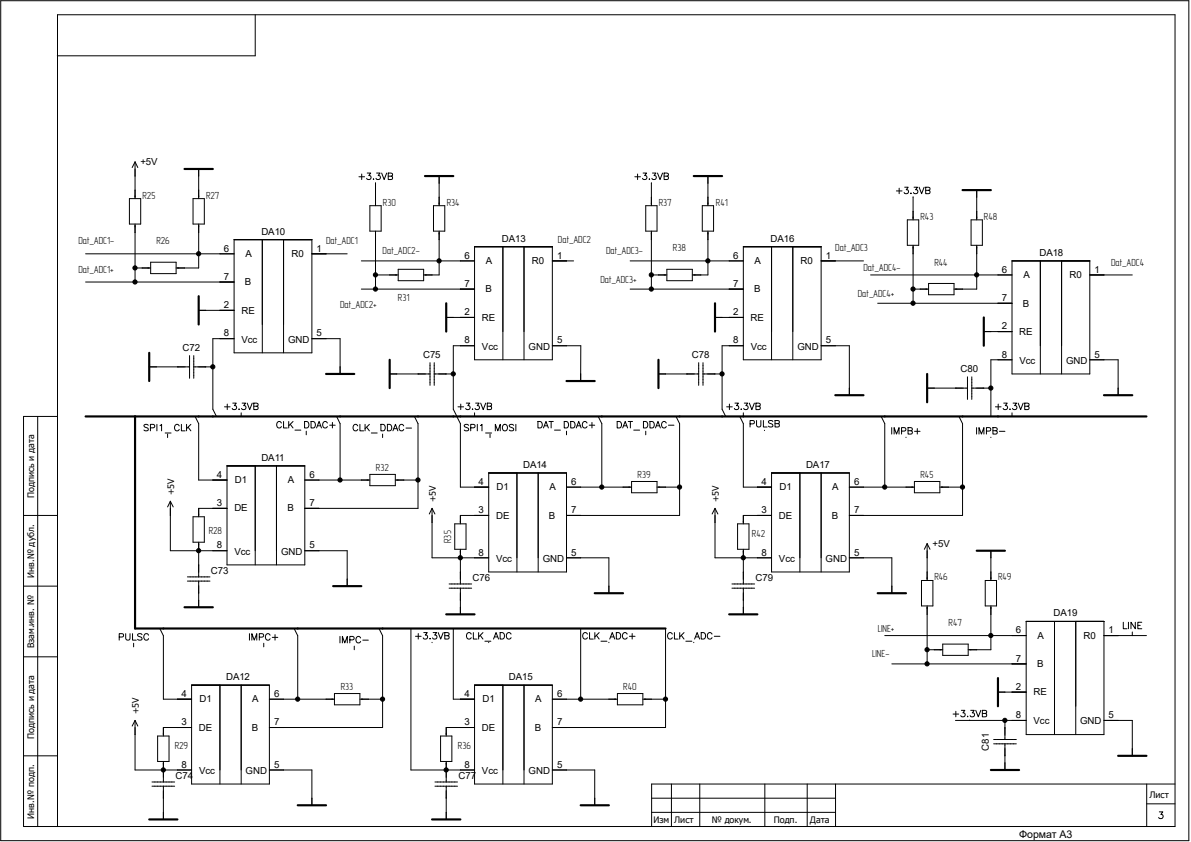
[picture p114: page 3]

XP3.2
XP3.1

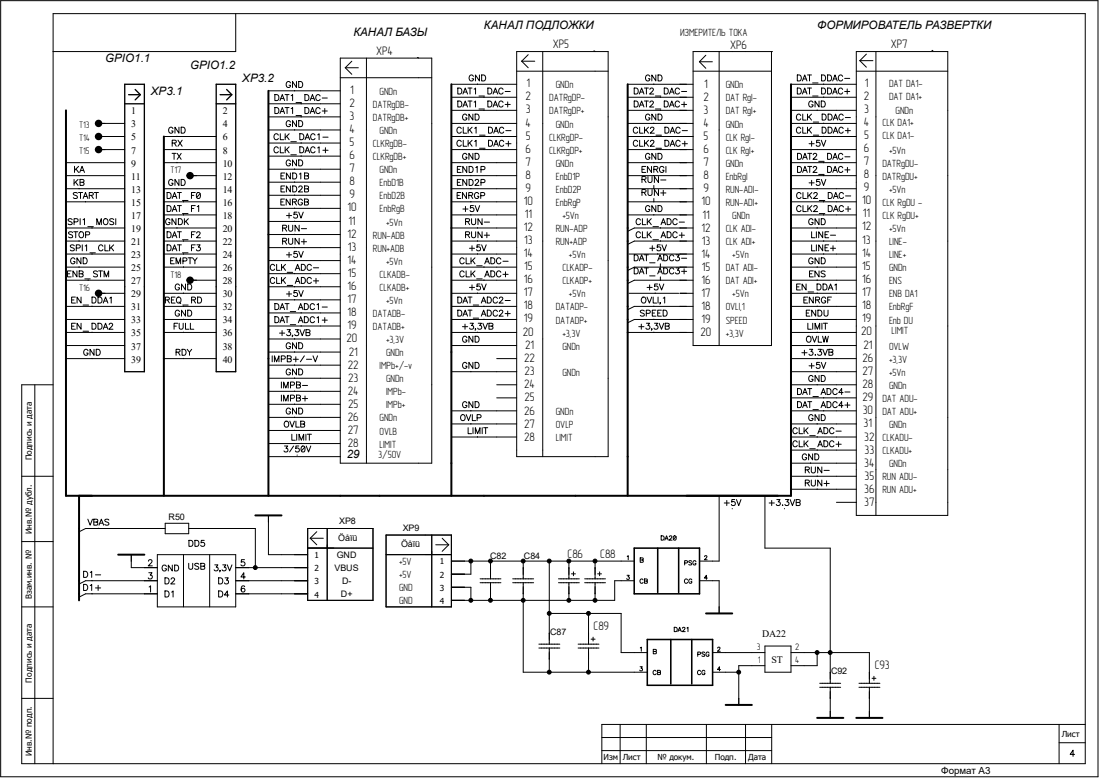
[picture p115: page 4]

Формат А3 Инв.№ подп. Подпись и дата Взам.инв. № Подпись и дата Инв.№ дубл.

Öåïü
4312 | GND VBUS D-D+

+5V +5V GND GND | 4312

XP13

XP10

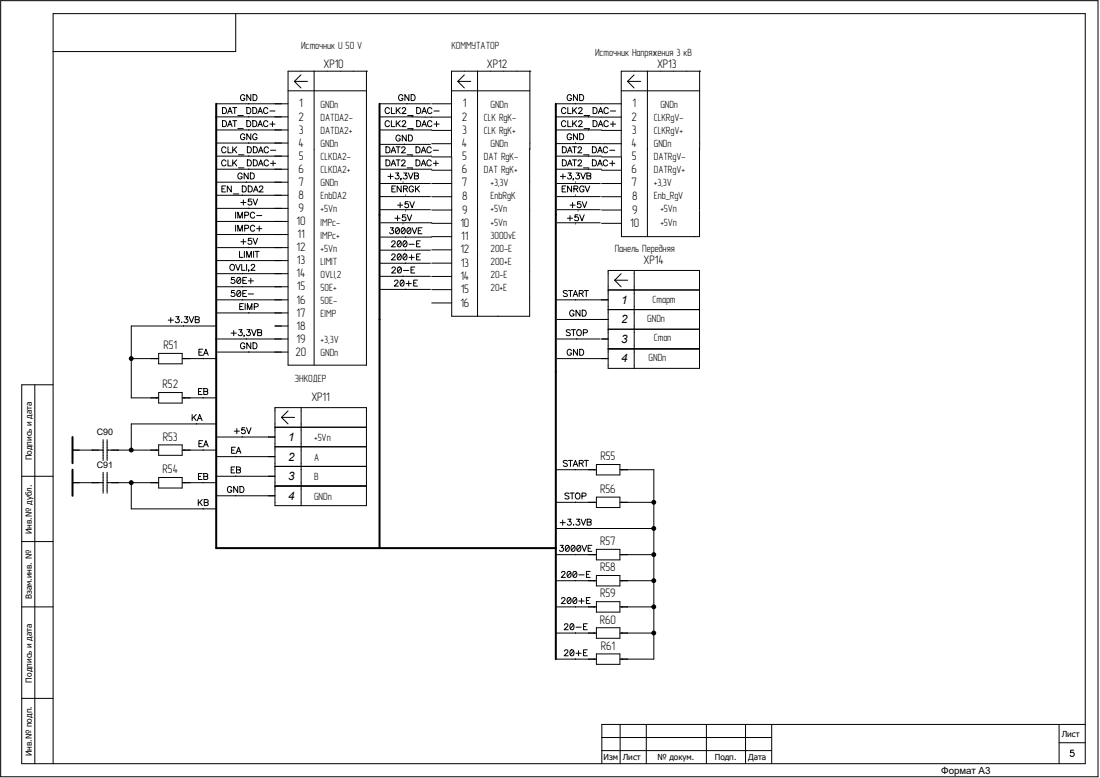
[picture p116: page 5]
