Sasha7b9Work/Linia/sources/Linia2/src/Communicator/GPIO/GPIO.cpp

// 2025/10/09 08:37:40 (c) Aleksandr Shevchenko e-mail : Sasha7b9@gmail.com
#include "defines.h"
#include "Communicator/GPIO/GPIO.h"
#include "Utils/Timer.h"
#include <thread>


// Lin specific
#include <gpiod.h>
#include <unistd.h>
#include <pthread.h>
#include <sys/select.h>
#include <sys/time.h>


PinIn pinFIFO_FULL(Pin::FULL_36);
PinIn pinSTART(Pin::KN_START_15);
PinIn pinSTOP(Pin::KN_STOP_33);
PinIn pinEncA(Pin::ENC_A_11);
PinIn pinEncB(Pin::ENC_B_13);


namespace GPIO
{
    static PinInfo pins[] =
    {
//        PinStorage::GetPinInfo(Pin::T13_03__________________FREE, true),
//        PinStorage::GetPinInfo(Pin::T14_05__________________FREE, true),
//        PinStorage::GetPinInfo(Pin::T15_07__________________FREE, true),
        PinStorage::GetPinInfo(Pin::ENC_A_11, true),
//        PinStorage::GetPinInfo(Pin::T17_12__________________FREE, true),
        PinStorage::GetPinInfo(Pin::ENC_B_13, true),
        PinStorage::GetPinInfo(Pin::KN_START_15, true),
        PinStorage::GetPinInfo(Pin::DDAC_MOSI_16_out, false),
        PinStorage::GetPinInfo(Pin::DDAC_CLK_18_out, false),
        PinStorage::GetPinInfo(Pin::F_CON2_22, true),
        PinStorage::GetPinInfo(Pin::F_CON1_26, true),
        PinStorage::GetPinInfo(Pin::ENB_PC_27, true),
        PinStorage::GetPinInfo(Pin::DDAC_CS0_31_out, false),
        PinStorage::GetPinInfo(Pin::ST_EXT_32, true),
        PinStorage::GetPinInfo(Pin::KN_STOP_33, true),
        PinStorage::GetPinInfo(Pin::DDAC_CS1_35_out, false),
        PinStorage::GetPinInfo(Pin::FULL_36, true),
        PinStorage::GetPinInfo(Pin::FIT_37, true)
    };

    constexpr size_t PINS_COUNT = std::size(pins);

    // Вспомогательные функции для получения информации о пинах
    PinInfo *GetPinInfo(Pin::Num num)
    {
        for (size_t i = 0; i < PINS_COUNT; i++)
        {
            if (pins[i].pin_num == num)
            {
                return &pins[i];
            }
        }

        return nullptr;
    }
}


namespace GPIO
{
    void Init()
    {
        LOG_WRITE("Initializing GPIO...");

        for (size_t i = 0; i < PINS_COUNT; i++)
        {
            PinInfo &info = pins[i];

            if (info.is_input)
            {
                info.hw.chip = gpiod_chip_open_by_name(info.hw.chip_name);
                if (!info.hw.chip)
                {
                    LOG_ERROR("Cannot open GPIO chip %s, pin_num %d, pin_logical %d", info.hw.chip_name, (int)info.pin_num, info.hw.pin_logical);
                    continue;
                }

                info.hw.line = gpiod_chip_get_line(info.hw.chip, (uint)info.hw.pin_logical);
                if (!info.hw.line)
                {
                    LOG_ERROR("Cannot get GPIO line %d", info.hw.pin_logical);
                    gpiod_chip_close(info.hw.chip);
                    info.hw.chip = nullptr;
                    continue;
                }

                int ret = gpiod_line_request_input_flags(info.hw.line, nullptr,
                    GPIOD_LINE_REQUEST_FLAG_BIAS_PULL_DOWN);
                if (ret < 0)
                {
                    LOG_ERROR("Cannot request GPIO line %d as input", info.hw.pin_logical);
                    gpiod_chip_close(info.hw.chip);
                    info.hw.chip = nullptr;
                    info.hw.line = nullptr;
                    continue;
                }

                info.last_state = (gpiod_line_get_value(info.hw.line) == 1);

                LOG_WRITE("GPIO input pin_num %d, %s:%d initialized", (int)info.pin_num, info.hw.chip_name, info.hw.pin_logical);
            }
            else
            {
                info.hw.chip = gpiod_chip_open_by_name(info.hw.chip_name);
                if (!info.hw.chip)
                {
                    LOG_ERROR("Cannot open GPIO chip %s pin_num %d", info.hw.chip_name, (int)info.pin_num);
                    continue;
                }

                info.hw.line = gpiod_chip_get_line(info.hw.chip, (uint)info.hw.pin_logical);
                if (!info.hw.line)
                {
                    LOG_ERROR("Cannot get GPIO line for pin %d", info.hw.pin_logical);
                    gpiod_chip_close(info.hw.chip);
                    info.hw.chip = nullptr;
                    continue;
                }

                int ret = gpiod_line_request_output(info.hw.line, nullptr, 0);
                if (ret < 0)
                {
                    LOG_ERROR("Cannot request GPIO line for pin %d as output", info.hw.pin_logical);
                    gpiod_chip_close(info.hw.chip);
                    info.hw.chip = nullptr;
                    info.hw.line = nullptr;
                    continue;
                }

                LOG_WRITE("GPIO output pin %s:%d initialized", info.hw.chip_name, info.hw.pin_logical);
            }
        }
    }

    void DeInit()
    {
        LOG_WRITE("Deinitializing GPIO...");

        for (size_t i = 0; i < PINS_COUNT; i++)
        {
            PinInfo &info = pins[i];

            if (info.hw.line)
            {
                gpiod_line_release(info.hw.line);
                info.hw.line = nullptr;
            }

            if (info.hw.chip)
            {
                gpiod_chip_close(info.hw.chip);
                info.hw.chip = nullptr;
            }
        }

        LOG_WRITE("GPIO deinitialized");
    }
}


bool PinIn::GetHardware(gpiod_line *line)
{
    return gpiod_line_get_value(line) == 1;
}


bool Pin::GetState() const
{
    PinInfo *info = GPIO::GetPinInfo(num);

    if (info && info->hw.line)
    {
        int val = gpiod_line_get_value(info->hw.line);

        if (val < 0)
        {
            LOG_ERROR("Error: Cannot read GPIO pin number %d", info->hw.pin_logical);
            return false;
        }

        return (val == 1);
    }

    return false;
}


void PinOut::Set(bool state)
{
    PinInfo *info = GPIO::GetPinInfo(num);

    if (info && info->hw.line)
    {
        if (info->is_input)
        {
            LOG_ERROR("Pin is input");
        }
        else
        {
            int ret = gpiod_line_set_value(info->hw.line, state ? 1 : 0);

            if (ret < 0)
            {
                LOG_ERROR("Error: Cannot set GPIO pin %d to %s", info->hw.pin_logical, state ? "HIGH" : "LOW");
            }
        }
    }
}


void PinOut::Set(gpiod_line *line, int state)
{
    gpiod_line_set_value(line, state);
}


void PinOut::ToHi()
{
    Set(true);
}


void PinOut::ToLow()
{
    Set(false);
}
