Sasha7b9Work/Linia/sources/Linia2/src/MainWindow.cpp

// 2023/07/04 17:46:31 (c) Aleksandr Shevchenko e-mail : Sasha7b9@gmail.com
#include "defines.h"
#include "Application.h"
#include "Settings/Settings.h"
#include "Windows/ConsoleRS232.h"
#include "MainWindow.h"
#include "GUI/PageMeasures/PageMeasures.h"
#include "GUI/PageTests/PageTests.h"
#include "GUI/PageDebug/PageDebug.h"
#include "GUI/PageMeasures/Graphics/AutoCursors.h"
#include "GUI/PageArchive/PageArchive.h"
#include "GUI/PageReports/PageReports.h"
#include "GUI/PageSettings/PageSettings.h"
#include "GUI/PageTables/PageTables.h"
#include "GUI/Controls/Notebook.h"
#include "GUI/Dialogs/Dialog.h"
#include "GUI/Controls/Windows.h"
#pragma warning(push, 0)
    #include <wx/sizer.h>
    #include <wx/statline.h>
    #include <wx/popupwin.h>
#pragma warning(pop)

MainWindow *MainWindow::self = nullptr;


ModeMainWindow::E ModeMainWindow::current = ModeMainWindow::Standard;


MainWindow::MainWindow(const wxString &title)
    : wxFrame((wxFrame *)NULL, wxID_ANY, title, wxDefaultPosition, wxDefaultSize)
{
    self = this;

#ifdef _WIN32
    SetIcon(wxICON(MAIN_ICON));
#endif

    Bind(wxEVT_MAXIMIZE, &MainWindow::OnEventMaximize, this);
    Bind(wxEVT_CLOSE_WINDOW, &MainWindow::OnEventCloseWindow, this);

    TuneFont();

    wxBoxSizer *sizer = new wxBoxSizer(wxHORIZONTAL);
    notebook = new Notebook(this);
    notebook->AddPanel(new PageSettings(notebook));
    notebook->AddPanel(new PageMeasures(notebook));
    notebook->AddPanel(new PageTests(notebook));
    notebook->AddPanel(new PageDebug(notebook));

    sizer->Add(notebook, 1, wxEXPAND | wxALL);
    SetSizer(sizer);

    notebook->SetCurrentPanel(1);       // \todo Если этого не сделать, то артефакты в отображении страниц
    notebook->SetCurrentPanel(2);

    SetPosition();

    Bind(wxEVT_CHAR_HOOK, &MainWindow::OnEventKeyHook, this);

    {
        if (GF::IsBoardOPi5Plus())
        {
            SetSize({ WIDTH, HEIGHT });

            ShowFullScreen(true);
        }
        else
        {
            SetClientSize({ WIDTH, HEIGHT });

#ifndef _WIN32
            SetWindowStyle(GetWindowStyle() & ~(wxRESIZE_BORDER | wxMAXIMIZE_BOX));
#endif
        }
    }

    new AutoCursors();

    Bind(wxEVT_LEFT_DOWN, [](wxMouseEvent &event)
        {
            // Проверяем, есть ли активный попап
            if (PopupTransientWindow *popup =  PopupTransientWindow::GetActivePoup())
            {
                // Проверяем, клик вне попапа?
                wxPoint mousePos = wxGetMousePosition();
                wxRect popupRect(popup->GetScreenPosition(), popup->GetSize());

                if (!popupRect.Contains(mousePos))
                {
                    popup->Dismiss();
                }
            }
            event.Skip();
        });

    SetMode(ModeMainWindow::Standard);
}


void MainWindow::OnEventKeyHook(wxKeyEvent &event)
{
    if (event.GetKeyCode() == 'K')
    {
        if (event.ControlDown())
        {
            ConsoleRS232::self->Show(!ConsoleRS232::self->IsShown());
        }
    }

    event.Skip();
}


void MainWindow::OnEventMaximize(wxMaximizeEvent &event)
{
    // Без этого первая максимизация окна приложения не отрабатывает на элементах сайзера

    Layout();
    GetSizer()->Layout();
    Refresh();

    event.Skip();
}


void MainWindow::TuneFont()
{
    wxFont font = GetFont();

    //------------------------------------------------------------

    wxFontFamily family = wxFONTFAMILY_DEFAULT;

    Config::ReadFontParameter("font_family", family);

    font.SetFamily(family);

    //------------------------------------------------------------

    wxString face_name = "Segoe UI";

    Config::ReadString("font_face_name", face_name);

    font.SetFaceName(face_name);

    //------------------------------------------------------------

    wxFontStyle style = wxFONTSTYLE_NORMAL;

    Config::ReadFontParameter("font_style", style);

    font.SetStyle(style);

    //------------------------------------------------------------

    int point_size = 9;

    Config::ReadInt("font_point_size", point_size);

    font.SetPointSize(point_size);

    //------------------------------------------------------------

    wxPoint pixel_size{ font.GetPixelSize().x, font.GetPixelSize().y };

    Config::Read("font_pixel_size_x", pixel_size.x);
    Config::Read("font_pixel_size_y", pixel_size.y);

    font.SetPixelSize({ pixel_size.x, pixel_size.y });

    //------------------------------------------------------------

    font.SetUnderlined(false);

    font.SetStrikethrough(false);

    //------------------------------------------------------------

    wxFontWeight weigth = wxFONTWEIGHT_NORMAL;

    Config::ReadFontParameter("font_weigth", weigth);

    font.SetWeight(weigth);

    //------------------------------------------------------------

    wxWindow::SetFont(font);
}


void MainWindow::OnEventCloseWindow(wxCloseEvent &event)
{
    LOG_WRITE("Exit");

    SET_GUI_CURRENT_PANEL->Set(notebook->GetCurrentPanelIndex());

    if (ConsoleRS232::self)
    {
        SET_GUI_POS_CONSOLE->Set(ConsoleRS232::self->GetPosition());

        wxSize size = ConsoleRS232::self->GetSize();
        SET_GUI_SIZE_CONSOLE->Set({ size.x, size.y });

        SET_GUI_MAXIMIZED_CONSOLE->Set(ConsoleRS232::self->IsMaximized());

        ConsoleRS232::self->Destroy();
    }

    position.Set(wxWindow::GetPosition());

    SET::Save();

    MainWindow::self = nullptr;

    event.Skip();
}


void MainWindow::SetMode(ModeMainWindow::E mode)
{
    ModeMainWindow::current = mode;

    if (PageMeasures::self)
    {
        PageMeasures::self ->Show(mode == ModeMainWindow::Standard || mode == ModeMainWindow::FullGraph);

        PageMeasures::self->FullScreen(mode == ModeMainWindow::FullGraph);
    }

    wxFrame::Layout();
}


void MainWindow::HideSystemPanel()
{
    Raise();

#ifdef __WXGTK__
    GtkWidget *widget = GetHandle(); // В wxGTK GetHandle() возвращает GtkWidget*
    if (widget && gtk_widget_get_window(widget))
    {
        GdkWindow *gdk_window = gtk_widget_get_window(widget);
        // Делаем окно "выше всех" средствами GDK
        gdk_window_set_keep_above(gdk_window, TRUE);
        // Принудительно поднимаем
        gdk_window_raise(gdk_window);
    }
#endif
}


void MainWindow::SetPosition()
{
    position.Load();

    wxWindow::SetPosition(position.Get());
}
