Sasha7b9Work/Linia/sources/Loader/src/Hardware/HAL/HAL.cpp

// (c) Aleksandr Shevchenko e-mail : Sasha7b9@gmail.com
#include "defines.h"
#include "Hardware/HAL/HAL.h"
#include "Hardware/HAL/HAL_PINS.h"
#include <stm32f4xx_hal.h>


namespace HAL
{
    static void SystemClockConfig();

    static void EnablePeriphery();
}


void HAL::Init()
{
    SystemClockConfig();

    EnablePeriphery();

    HAL_Init();

    HAL_USART1::Init();
}


void HAL::SystemClockConfig()
{
    RCC_OscInitTypeDef RCC_OscInitStruct = { 0 };
    RCC_ClkInitTypeDef RCC_ClkInitStruct = { 0 };

    // Configure the main internal regulator output voltage
    __HAL_RCC_PWR_CLK_ENABLE();
    __HAL_PWR_VOLTAGESCALING_CONFIG(PWR_REGULATOR_VOLTAGE_SCALE1);

    // Initializes the RCC Oscillators according to the specified parameters in the RCC_OscInitTypeDef structure.
    RCC_OscInitStruct.OscillatorType = RCC_OSCILLATORTYPE_HSE;
    RCC_OscInitStruct.HSEState = RCC_HSE_ON;
    RCC_OscInitStruct.PLL.PLLState = RCC_PLL_ON;
    RCC_OscInitStruct.PLL.PLLSource = RCC_PLLSOURCE_HSE;
    RCC_OscInitStruct.PLL.PLLM = 15;
    RCC_OscInitStruct.PLL.PLLN = 144;
    RCC_OscInitStruct.PLL.PLLP = RCC_PLLP_DIV2;
    RCC_OscInitStruct.PLL.PLLQ = 5;
    if (HAL_RCC_OscConfig(&RCC_OscInitStruct) != HAL_OK)
    {
        ERROR_HANDLER();
    }

    // Initializes the CPU, AHB and APB buses clocks
    RCC_ClkInitStruct.ClockType = RCC_CLOCKTYPE_HCLK | RCC_CLOCKTYPE_SYSCLK
        | RCC_CLOCKTYPE_PCLK1 | RCC_CLOCKTYPE_PCLK2;
    RCC_ClkInitStruct.SYSCLKSource = RCC_SYSCLKSOURCE_PLLCLK;
    RCC_ClkInitStruct.AHBCLKDivider = RCC_SYSCLK_DIV1;
    RCC_ClkInitStruct.APB1CLKDivider = RCC_HCLK_DIV4;
    RCC_ClkInitStruct.APB2CLKDivider = RCC_HCLK_DIV2;

    if (HAL_RCC_ClockConfig(&RCC_ClkInitStruct, FLASH_LATENCY_3) != HAL_OK)
    {
        ERROR_HANDLER();
    }

    /*
    RCC_OscInitTypeDef RCC_OscInitStruct = { 0 };
    RCC_ClkInitTypeDef RCC_ClkInitStruct = { 0 };

    __HAL_RCC_PWR_CLK_ENABLE();
    __HAL_PWR_VOLTAGESCALING_CONFIG(PWR_REGULATOR_VOLTAGE_SCALE1);

    RCC_OscInitStruct.OscillatorType = RCC_OSCILLATORTYPE_HSI;
    RCC_OscInitStruct.HSIState = RCC_HSI_ON;
    RCC_OscInitStruct.HSICalibrationValue = RCC_HSICALIBRATION_DEFAULT;
    RCC_OscInitStruct.PLL.PLLState = RCC_PLL_ON;
    RCC_OscInitStruct.PLL.PLLSource = RCC_PLLSOURCE_HSI;
    RCC_OscInitStruct.PLL.PLLM = 8;
    RCC_OscInitStruct.PLL.PLLN = 50;
    RCC_OscInitStruct.PLL.PLLP = RCC_PLLP_DIV2;
    RCC_OscInitStruct.PLL.PLLQ = 4;
    if (HAL_RCC_OscConfig(&RCC_OscInitStruct) != HAL_OK)
    {
        ERROR_HANDLER();
    }

    RCC_ClkInitStruct.ClockType = RCC_CLOCKTYPE_HCLK | RCC_CLOCKTYPE_SYSCLK
        | RCC_CLOCKTYPE_PCLK1 | RCC_CLOCKTYPE_PCLK2;
    RCC_ClkInitStruct.SYSCLKSource = RCC_SYSCLKSOURCE_PLLCLK;
    RCC_ClkInitStruct.AHBCLKDivider = RCC_SYSCLK_DIV1;
    RCC_ClkInitStruct.APB1CLKDivider = RCC_HCLK_DIV2;
    RCC_ClkInitStruct.APB2CLKDivider = RCC_HCLK_DIV1;

    if (HAL_RCC_ClockConfig(&RCC_ClkInitStruct, FLASH_LATENCY_1) != HAL_OK)
    {
        ERROR_HANDLER();
    }
    */
}


void HAL::EnablePeriphery()
{
    __HAL_RCC_GPIOA_CLK_ENABLE();
    __HAL_RCC_GPIOB_CLK_ENABLE();
    __HAL_RCC_GPIOC_CLK_ENABLE();
    __HAL_RCC_GPIOD_CLK_ENABLE();
    __HAL_RCC_GPIOE_CLK_ENABLE();
    __HAL_RCC_GPIOF_CLK_ENABLE();
    __HAL_RCC_GPIOG_CLK_ENABLE();
    __HAL_RCC_GPIOH_CLK_ENABLE();


    __HAL_RCC_USART1_CLK_ENABLE();      // Orange Pi 5 Plus
}


void HAL_MspInit()
{
    HAL_NVIC_SetPriorityGrouping(NVIC_PRIORITYGROUP_4);

    /* System interrupt init*/
    /* MemoryManagement_IRQn interrupt configuration */
    HAL_NVIC_SetPriority(MemoryManagement_IRQn, 0, 0);
    /* BusFault_IRQn interrupt configuration */
    HAL_NVIC_SetPriority(BusFault_IRQn, 0, 0);
    /* UsageFault_IRQn interrupt configuration */
    HAL_NVIC_SetPriority(UsageFault_IRQn, 0, 0);
    /* SVCall_IRQn interrupt configuration */
    HAL_NVIC_SetPriority(SVCall_IRQn, 0, 0);
    /* DebugMonitor_IRQn interrupt configuration */
    HAL_NVIC_SetPriority(DebugMonitor_IRQn, 0, 0);
    /* PendSV_IRQn interrupt configuration */
    HAL_NVIC_SetPriority(PendSV_IRQn, 0, 0);
    /* SysTick_IRQn interrupt configuration */
    HAL_NVIC_SetPriority(SysTick_IRQn, 0, 0);
}


void HAL::ErrorHandler(pchar /*file*/, int /*line*/)
{
//    LOG_ERROR("A critical hardware error occurred in %s:%d", file, line);
}
