Sasha7b9Work/Linia/sources/VS/Linia2/src/Device/SettingsDevice.cpp

// 2025/7/27 22:27:36 (c) Aleksandr Shevchenko e-mail : Sasha7b9@tut.by
#include "defines.h"
#include "Device/SettingsDevice.h"


struct DSettings
{
    CalK calI[DSet::Type::Count][RangeI::Count];
    CalK calU[DSet::Type::Count][RangeU::Count];
};


pchar RangeI::Name(RowRange::E row) const
{
    static const pchar names[Count][RowRange::Count] =
    {
        { "400 pA", "500 pA" },
        { "1 nA",   "1 nA" },
        { "2 nA",   "2 nA" },
        { "4 nA",   "5 nA" },
        { "10 nA",  "10 nA" },
        { "20 nA",  "20 nA" },
        { "40 nА",  "50 nА" },
        { "100 nA", "100 nA" },
        { "200 nA", "200 nA" },
        { "400 nA", "500 nA" },
        { "1 uA",   "1 uA" },
        { "2 uA",   "2 uA" },
        { "4 uA",   "5 uA" },
        { "10 uA",  "10 uA" },
        { "20 uA",  "20 uA" },
        { "40 uA",  "50 uA" },
        { "100 uA", "100 uA" },
        { "200 uA", "200 uA" },
        { "400 uA", "500 uA" },
        { "1 mA",   "1 mA" },
        { "2 mA",   "2 mA" },
        { "4 mA",   "5 mA" },
        { "10 mA",  "10 mA" },
        { "20 mA",  "20 mA" },
        { "40 mA",  "50 mA" },
        { "100 mA", "100 mA" },
        { "200 mA", "200 mA" },
        { "400 mA", "500 mA" },
        { "1 A",    "1 A" },
        { "2 A",    "2 A" },
        { "4 A",    "5 A" },
        { "10 A",   "10 A" },
        { "20 A",   "20 A" },
        { "40 A",   "50 A" },
        { "100 A",  "100 A" },
        { "200 A",  "200 A" }
    };

    return names[value][row];
}


wxString RangeI::NameStep(RowRange::E row) const
{
    wxString name = Name(row);

    wxString val = name.BeforeFirst(' ');

    wxString units = name.AfterFirst(' ');

    int int_value = 0;

    val.ToInt(&int_value);

    if (int_value == 50)
    {
        val = "2.5";
    }
    else if (int_value >= 20)
    {
        val = wxString::Format("%d", int_value / 20);
    }
    else
    {
        val = wxString::Format("%d", int_value * 100 / 2);

        if (units[0] == 'A')        units = 'm' + units;
        else if (units[0] == 'm')   units = "uA";
        else if (units[0] == 'u')   units = "nA";
        else if (units[0] == 'n')   units = "pA";
    }

    return val + " " + units;
}


wxString RangeU::NameStep(RowRange::E row) const
{
    wxString name = Name(row);

    wxString val = name.BeforeFirst(' ');

    wxString units = name.AfterFirst(' ');

    int int_value = 0;

    val.ToInt(&int_value);

    if (int_value == 50)
    {
        val = "2.5";
    }
    else if (int_value >= 20)
    {
        val = wxString::Format("%d", int_value / 20);
    }
    else
    {
        val = wxString::Format("%d", int_value * 100 / 2);

        if (units[0] == 'V')        units = 'm' + units;
        else if (units[0] == 'k')   units = "V";
        else if (units[0] == 'm')   units = "uV";
        else if (units[0] == 'u')   units = "nV";
        else if (units[0] == 'n')   units = "pV";
    }

    return val + " " + units;
}


pchar RangeU::Name(RowRange::E row) const
{
    static const pchar names[Count][RowRange::Count] =
    {
        { "1 nV",   "1 nV" },
        { "2 nV",   "2 nV" },
        { "4 nV",   "5 nV" },
        { "10 nV",  "10 nV" },
        { "20 nV",  "20 nV" },
        { "40 nV",  "50 nV" },
        { "100 nV", "100 nV" },
        { "200 nV", "200 nV" },
        { "400 nV", "500 nV" },
        { "1 uV",   "1 uV" },
        { "2 uV",   "2 uV" },
        { "4 uV",   "5 uV" },
        { "10 uV",  "10 uV" },
        { "20 uV",  "20 uV" },
        { "40 uV",  "50 uV" },
        { "100 uV", "100 uV" },
        { "200 uV", "200 uV" },
        { "400 uV", "500 uV" },
        { "1 mV",   "1 mV" },
        { "2 mV",   "2 mV" },
        { "4 mV",   "5 mV" },
        { "10 mV",  "10 mV" },
        { "20 mV",  "20 mV" },
        { "40 mV",  "50 mV" },
        { "100 mV", "100 mV" },
        { "200 mV", "200 mV" },
        { "400 mV", "500 mV" },
        { "1 V",    "1 V" },
        { "2 V",    "2 V" },
        { "4 V",    "5 V" },
        { "10 V",   "10 V" },
        { "20 V",   "20 V" },
        { "40 V",   "50 V" },
        { "100 V",  "100 V" },
        { "200 V",  "200 V" },
        { "400 V",  "500 V" },
        { "1 kV",   "1 kV" },
        { "2 kV",   "2 kV" },
        { "4 kV",   "5 kV" },
        { "10 kV",  "10 kV" }
    };

    return names[value][row];
}


static DSettings dset =
{
    {
        {
            { 0.0, 1.0 },
            { 0.0, 1.0 },
            { 0.0, 1.0 },
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
            { 0.0, 1.0 },
            { 0.0, 1.0 },
            { 0.0, 1.0 },
            { 0.0, 1.0 },
            { 0.0, 1.0 },
            { 0.0, 1.0 },
            { 0.0, 1.0 },
            { 0.0, 1.0 },
            { 0.0, 1.0 },
            { 0.0, 1.0 },
            { 0.0, 1.0 },
            { 0.0, 1.0 },
            { 0.0, 1.0 },
            { 0.0, 1.0 },
            { 0.0, 1.0 },
            { 0.0, 1.0 },
            { 0.0, 1.0 },
            { 0.0, 1.0 },
            { 0.0, 1.0 },
            { 0.0, 1.0 },
            { 0.0, 1.0 },
            { 0.0, 1.0 },
            { 0.0, 1.0 },
            { 0.0, 1.0 },
            { 0.0, 1.0 },
            { 0.0, 1.0 },
            { 0.0, 1.0 },
            { 0.0, 1.0 },
            { 0.0, 1.0 },
            { 0.0, 1.0 },
            { 0.0, 1.0 },
            { 0.0, 1.0 }
        }
    }
};


const CalK &DSet::Get(Type::E type, RangeI::E range)
{
    return dset.calI[type][range];
}


const CalK &DSet::Get(Type::E type, RangeU::E range)
{
    return dset.calU[type][range];
}


void DSet::Set(Type::E type, RangeI::E range, const CalK &cal)
{
    dset.calI[type][range] = cal;
}


void DSet::Set(Type::E type, RangeU::E range, const CalK &cal)
{
    dset.calU[type][range] = cal;
}


RangeI::E RangeI::Min(DSet::Type::E type)
{
    static const RangeI::E min[DSet::Type::Count] =
    {
        _10nA,
        _40_50nA,
        _40_50nA,
        _40_50nA,
        _40_50nA,
        _40_50nA,
        _40_50nA
    };

    return min[type];
}


RangeI::E RangeI::Max(DSet::Type::E type)
{
    static const RangeI::E max[DSet::Type::Count] =
    {
        _40_50A,
        _10A,
        _10A,
        _10A,
        _10mA,
        _10mA,
        _10mA
    };

    return max[type];
}


RangeU::E RangeU::Min(DSet::Type::E type)
{
    static const RangeU::E min[DSet::Type::Count] =
    {
        _400_500mV,
        _1V,
        _1V,
        _1V,
        _1V,
        _1V,
        _1V
    };

    return min[type];
}


RangeU::E RangeU::Max(DSet::Type::E type)
{
    static const RangeU::E max[DSet::Type::Count] =
    {
        _2kV,
        _40_50V,
        _40_50V,
        _40_50V,
        _40_50V,
        _40_50V,
        _40_50V
    };

    return max[type];
}


void RangeI::FillArrayStrings(wxArrayString &arr, DSet::Type::E type, bool steps)
{
    arr.clear();
    for (int i = RangeI::Min(type); i <= RangeI::Max(type); i++)
    {
        if (steps)
        {
            arr.push_back(RangeI((RangeI::E)i).NameStep(RowRange::ForType(type)));
        }
        else
        {
            arr.push_back(RangeI((RangeI::E)i).Name(RowRange::ForType(type)));
        }
    }
}


void RangeU::FillArrayStrings(wxArrayString &arr, DSet::Type::E type, bool steps)
{
    arr.clear();

    for (int i = RangeU::Min(type); i <= RangeU::Max(type); i++)
    {
        if (steps)
        {
            arr.push_back(RangeU((RangeU::E)i).NameStep(RowRange::ForType(type)));
        }
        else
        {
            arr.push_back(RangeU((RangeU::E)i).Name(RowRange::ForType(type)));
        }
    }
}


RowRange::E RowRange::ForType(DSet::Type::E type)
{
    static const E row[DSet::Type::Count] =
    {
        _125,
        _125,
        _124,
        _124,
        _124,
        _124,
        _124
    };

    return row[type];
}
