Sasha7b9Work/Linia/sources/Linia2/src/Application.cpp

// 2023/07/04 17:46:31 (c) Aleksandr Shevchenko e-mail : Sasha7b9@gmail.com
#include "defines.h"
#include "Application.h"
#include "Settings/Settings.h"
#include "MainWindow.h"
#include "Communicator/UART/UART.h"
#include "Communicator/SPI/SPI.h"
#include "GUI/Dialogs/AutoRebootDialog.h"
#include "SoftTests/SoftTests.h"
#include "IPPP/Real/Chips.h"
#include "Windows/ConsoleRS232.h"
#include "Settings/FileJSON.h"
#include "Communicator/ClientHTTP/ClientHTTP.h"
#include "IPPP/IDevice.h"
#include "GUI/PageDebug/PanelRight.h"
#include "GUI/PageDebug/PageDebug.h"
#pragma warning(push, 0)
    #include <wx/msgdlg.h>
#pragma warning(pop)
#include <cstdlib>
#include <locale>
#ifndef _WIN32
    #include <csignal>
#endif


wxIMPLEMENT_APP(Application);


Application *Application::self = nullptr;


#ifndef _WIN32

static std::atomic<int> g_signal_received{ 0 };

void Application::SignalHandler(int sig)
{
    // Устанавливаем флаг, а не делаем что-то сложное
    g_signal_received = sig;
}

static void CloseApplication()
{
    LOG_WRITE("CloseApplication()");

    if (Application::self)
    {
        if (MainWindow::self)
        {
            MainWindow::self->Close(true);
        }

        Application::self->Yield();

        Application::self->ExitMainLoop();
    }
}

#endif


class NullLog : public wxLog
{
public:
    virtual void DoLogRecord(wxLogLevel,
        const wxString &,
        const wxLogRecordInfo &) override
    {
        // Ничего не делаем - просто игнорируем все логи
    }
};


#ifndef _WIN32
// Функция-фильтр для логов
void glib_log_filter(const gchar *log_domain,
    GLogLevelFlags log_level,
    const gchar *message,
    gpointer user_data)
{
    // Игнорируем всё, что содержит "Gtk" или является предупреждением/критикой
    if (log_domain && (g_strcmp0(log_domain, "Gtk") == 0 ||
        g_strcmp0(log_domain, "Gtk-WARNING") == 0))
    {
        return; // Полностью подавляем
    }

    // Если нужно подавить только WARNING и CRITICAL, раскомментируйте следующее:
    // if (log_level & (G_LOG_LEVEL_WARNING | G_LOG_LEVEL_CRITICAL)) {
    //     return;
    // }

    // Для всех остальных сообщений — стандартный вывод
    g_log_default_handler(log_domain, log_level, message, user_data);
}
#endif


bool Application::OnInit()
{
    Application::self = this;

    // Попытка отключить предупреждения вида "Gtk-WARNING"
    wxLog::SetActiveTarget(new NullLog());

    // Попытка отключить предупреждения вида "Gtk-WARNING"
    // Устанавливаем переменные окружения для GTK (для Linux)
#ifndef __WXMSW__
    g_log_set_handler(NULL, (GLogLevelFlags)(G_LOG_LEVEL_WARNING | G_LOG_LEVEL_CRITICAL),
        [](const gchar *log_domain, GLogLevelFlags level, const gchar *message, gpointer user_data)
        {
            (void)log_domain;
            (void)level;
            (void)message;
            (void)user_data;
            // Игнорируем предупреждения
        }, NULL);

    // Устанавливаем обработчик для доменов Gtk и GLib-GObject
    g_log_set_handler("Gtk",
        (GLogLevelFlags)(G_LOG_LEVEL_MASK | G_LOG_FLAG_FATAL | G_LOG_FLAG_RECURSION),
        (GLogFunc)glib_log_filter,
        NULL);
    g_log_set_handler("GLib-GObject",
        (GLogLevelFlags)(G_LOG_LEVEL_MASK | G_LOG_FLAG_FATAL | G_LOG_FLAG_RECURSION),
        (GLogFunc)glib_log_filter,
        NULL);

    setenv("G_MESSAGES_DEBUG", "0", 1);
    setenv("GTK_DEBUG", "0", 1);
    setenv("NO_AT_BRIDGE", "1", 1);
#endif

    std::locale::global(std::locale(""));  // Установка системной локали
    setlocale(LC_ALL, "");

    if (!wxApp::OnInit())
    {
        return false;
    }

#ifndef __WXMSW__
    // Включаем отображение иконок в контекстных меню GTK3
    GtkSettings *settings = gtk_settings_get_default();
    g_object_set(settings, "gtk-menu-images", TRUE, NULL);
#endif

    SET::Init();

    Log::Init();

    Config::Init();

    SET::Load();

    // we use a PNG image in our HTML page
    wxImage::AddHandler(new wxPNGHandler);

    ConsoleRS232::Create();

    Chip::Init();

    IDevice::impl = IDevice::Create();

    // create and show the main application window
    new MainWindow(L("ИППП 4"));

    timer.SetOwner(this, timer.GetId());

    if (!UART::IsAvailability())
    {
        wxString message = wxString::Format(L("Устройство UART %s не обнаружено."), UART_DEVICE);

        LOG_ERROR(message.c_str().AsChar());

        AutoRebootDialog dialog(MainWindow::self, message, 10, []
            {
                IGNORE_RESULT(std::system("shutdown -r now"));
            });

        dialog.ShowModal();
    }

    if (!SPI::IsAvailability())
    {
        wxString message = wxString::Format(L("Устройство SPI %s не обнаружено."), SPI_DEVICE);

        LOG_ERROR(message.c_str().AsChar());

        AutoRebootDialog dialog(MainWindow::self, message, 10, []
            {
                IGNORE_RESULT(std::system("shutdown -r now"));
            });

        dialog.ShowModal();
    }

    timer.Start(10);

    if (!SoftTests::RunAll())
    {
        wxMessageBox(wxString::Format(L("Во время выполнения тестов произошли ошибки.\nДополнительная информация в файле %s."),
            Log::FileName().c_str().AsChar()), L("Ошибка"), wxOK | wxCENTRE | wxICON_ERROR);
    }

#ifdef _WIN32

//    ComPort::Connect(PanelUpper::self->GetNumPort());

#endif

    if (SET_DEBUG_MODE->GetBool())
    {
        MainWindow::self->SetMode(ModeMainWindow::Debug);
    }

    if (!GF::IsBoardOPi5Plus())
    {
//        MainWindow::self->Maximize(true);
    }

    MainWindow::self->Show();

    Bind(wxEVT_TIMER, [](wxTimerEvent &)
        {
            static std::mutex mutex;

            if (mutex.try_lock())
            {
#ifndef _WIN32
                int sig = g_signal_received.load();
                if (sig != 0)
                {
                    g_signal_received.store(0);
                    LOG_WRITE("Received signal %d, closing", sig);
                    CloseApplication();   // ← безопасно: в главном потоке
                }
#endif

                IDevice::impl->ApplicationTask();

                Log::PeriodicTask();

                PageDebug::self->PeriodicTask();

                mutex.unlock();
            };

        }, timer.GetId());


    loggerHTTP.Connect();

#ifdef _WIN32
#else
    struct sigaction sa;
    sa.sa_handler = &Application::SignalHandler;
    sigemptyset(&sa.sa_mask);
    sa.sa_flags = 0;  // не SA_RESTART — чтобы прервать блокирующие вызовы

    sigaction(SIGTERM, &sa, nullptr);
    sigaction(SIGINT, &sa, nullptr);
    sigaction(SIGHUP, &sa, nullptr);

//    signal(SIGTERM, [](int)
//        {
//            CloseApplication();
//        });
//
//    signal(SIGINT, [](int)
//        {
//            CloseApplication();
//        });
//
//    signal(SIGHUP, [](int)
//        {
//            CloseApplication();
//        });
#endif

    IDevice::impl->Init();

    IDevice::impl->SendCommand(":INFO");

    return true;
}


int Application::OnExit()
{
    timer.Stop();

    IDevice::impl->DeInit();

    if (MainWindow::self)
    {
        MainWindow::self->Close(true);
    }

    LOG_WRITE("Exit");

    Config::DeInit();

    loggerHTTP.Disconnect();

    Log::DeInit();

    return wxApp::OnExit();
}
