Sasha7b9Work/Linia/sources/Linia2/src/IPPP/Device/Device.h

// 2025/09/11 08:48:15 (c) Aleksandr Shevchenko e-mail : Sasha7b9@tut.by
#pragma once
#include "IPPP/Device/IDevice.h"


class Device : public IDevice
{
public:

    Device() = default;

    virtual ~Device();

    virtual bool Init() override;

    virtual void Update() override;

    virtual void Shutdown() override;

    virtual bool IsConnected() const override;

    virtual void SendCommand(pchar format, ...) const override;

private:

    std::atomic<bool> running = false;
    std::atomic<bool> connected = false;
};
