Sasha7b9Work/Linia/sources/VS/Linia2/src/IPPP/IPPP.cpp

// 2025/09/07 16:36:30 (c) Aleksandr Shevchenko e-mail : Sasha7b9@tut.by
#include "defines.h"
#include "IPPP/IPPP.h"
#include "IPPP/Device/IDevice.h"
#include "IPPP/Device/DeviceEmulator.h"
#include "Communicator/GPIO/GPIO.h"


IPPP *IPPP::impl = nullptr;
