Sasha7b9Work/Linia/sources/Loader/src/Upgrader.cpp

// 2026/09/22 12:19:56 (c) Aleksandr Shevchenko e-mail : Sasha7b9@gmail.com
#include "defines.h"
#include "Upgrader.h"
#include "Hardware/HAL/HAL.h"
#include "Device/OPi5Plus/SCPI.h"
#include "Device/OPi5Plus/OPi5Plus.h"
#include "Utils/GlobalFunctions.h"
#include "Hardware/Timer.h"
#include <stm32f4xx_hal.h>


#ifdef WIN32
    #pragma warning(push)
    #pragma warning(disable : 4312)     // 'type cast': conversion from 'uint' to 'const void *' of greater size
#endif


namespace Upgrader
{
    static uint offset = 0;
    static int current_block = -1;

    static TimeMeterMS timer_duration;          // Таймер длительности обновления

    // Действия, который нужно сделать при возникновении ошибки
    static void ErrorUpgrade();
}


void Upgrader::BeginUpgrade()
{
    LOG_WRITE("Begin upgrade");

    offset = 0;

    current_block = -1;

    // Команда начала обновления уже получена, стираем сектор, где будет храниться прошивка
    HAL_FLASH::Firmware::EraseSector();

    OPi5Plus::SCPI::SendString(":UPGRADE:START");

    timer_duration.Reset();
}


void Upgrader::ReceiveBlock(int _num_block, int _size_block, uint _crc32_block)
{
    if (_num_block - 1 != current_block)
    {
        ErrorUpgrade();

        return;
    }

    current_block = _num_block;

    OPi5Plus::_text_mode = false;

    BufferOSDP buffer(_size_block);

    OPi5Plus::SCPI::SendFormat(":UPGRADE:HEAD %d %d %X", current_block, _size_block, _crc32_block);

    TimeMeterMS meter_full;

    int prev_bytes = 0;

    while (HAL_USART1::BytesInBuffer() < _size_block)
    {
        Timer::DelayMS(1);
        static TimeMeterMS meter;

        if (meter.ElapsedMS() > 2)
        {
            meter.Reset();
        }

        if ((prev_bytes != 0) &&
            (prev_bytes == HAL_USART1::BytesInBuffer()))
        {
            HAL_USART1::GetData(buffer);

            OPi5Plus::_text_mode = true;

            ErrorUpgrade();

            return;
        }

        prev_bytes = HAL_USART1::BytesInBuffer();
    }

    HAL_USART1::GetData(buffer);

    OPi5Plus::_text_mode = true;

    HAL_FLASH::Firmware::WriteBuffer(offset, buffer.Data(0), _size_block);

    uint crc32 = GF::CalculateCRC32(buffer.Data(0), _size_block);

    OPi5Plus::SCPI::SendFormat(":UPGRADE:CONTENT %d %d %X", current_block, _size_block, crc32);

    offset += _size_block;
}


void Upgrader::Start(int /*size*/, uint /*crc32*/)
{
    BeginUpgrade();
}


void Upgrader::End(int _size, uint _crc32)
{
    if (_size != (int)offset)
    {
        ErrorUpgrade();
    }
    else if (_crc32 != GF::CalculateCRC32((const void *)HAL_FLASH::Firmware::Address(), (int)offset))
    {
        ErrorUpgrade();
    }
    else
    {
        LOG_WRITE("Firmware received. Burning ...");

        uint crc32 = 0;

        int counter = 0;

        do
        {
            if (counter > 1)
            {
                LOG_ERROR("Burning fail %d", counter);
            }

            crc32 = GF::CalculateCRC32((const void *)HAL_FLASH::Firmware::Address(), (int)offset);

            HAL_FLASH::EraseSector(0x08000000);     // /
            HAL_FLASH::EraseSector(0x08004000);     // | Стираем первые пять секторов для записи основной прошивки
            HAL_FLASH::EraseSector(0x08008000);     // |
            HAL_FLASH::EraseSector(0x0800C000);     // |
            HAL_FLASH::EraseSector(0x08010000);     // /

            HAL_FLASH::WriteBuffer(0x08000000, (const void *)HAL_FLASH::Firmware::Address(), (int)offset);

            if (++counter > 10)
            {
                ErrorUpgrade();

                return;
            }

        } while (crc32 != GF::CalculateCRC32((const void *)0x08000000, (int)offset));

        OPi5Plus::SCPI::SendFormat(":UPGRADE:END %d, %X", offset, _crc32);

        LOG_WRITE("Time upgrade %u ms", timer_duration.ElapsedMS());

        HAL_NVIC_SystemReset();
    }
}


void Upgrader::ErrorUpgrade()
{
    OPi5Plus::_text_mode = true;
    current_block = -1;

    LOG_ERROR("Error upgrade");

    OPi5Plus::SCPI::SendString(":UPGRADE:ERROR");
}


#ifdef WIN32
    #pragma warning(pop)
#endif
