Sasha7b9Work/Linia/sources/Linia2/src/Application.h

// 2023/07/04 17:46:31 (c) Aleksandr Shevchenko e-mail : Sasha7b9@gmail.com
#pragma once
#include "Communicator/ClientHTTP/ClientHTTP.h"
#pragma warning(push, 0)
    #include <wx/app.h>
    #include <wx/timer.h>
#pragma warning(pop)



class Application : public wxApp
{
public:

    static Application *self;

    virtual bool OnInit() wxOVERRIDE;

    ClientHTTP loggerHTTP{ "188.127.240.34", 8080 };

private:

    wxTimer timer;          // По этому таймеру работает главный цикл

    virtual int OnExit() wxOVERRIDE;

    static void SignalHandler(int sig);

public:

    void ReInit();
};
