Sasha7b9Work/Linia/sources/Linia2/src/IPPP/Real/Chips.cpp

// 2025/10/17 11:39:25 (c) Aleksandr Shevchenko e-mail : Sasha7b9@gmail.com
#include "defines.h"
#include "IPPP/Real/Chips.h"
#include "IPPP/IDevice.h"
#include "Communicator/SPI/SPI.h"


DAC *dacs[DAC::Count];
REG *regs[REG::Count];
FPGA *fpgas[FPGA::Count];


void Chip::Init()
{
    for (int i = 0; i < DAC::Count; i++)
    {
        dacs[i] = new DAC((DAC::E)i);
    }

    for (int i = 0; i < REG::Count; i++)
    {
        regs[i] = new REG((REG::E)i);
    }

    for (int i = 0; i < FPGA::Count; i++)
    {
        fpgas[i] = new FPGA((FPGA::E)i);
    }
}


DAC::DAC(E _v) : v(_v)
{

}


wxString DAC::GetNameDevice() const
{
    return wxString::Format("DAC%d", (int)v);
}


int DAC::BitDepth() const
{
    static const int depth[Count] =
    {
        16,   // _0_ChannelC_Form
        16,   // _1_ChannelC_Meas
        14,   // _2_ChannelB_DAC1
        12,   // _3_ChannelB_DAC2
        16,   // _4_ChannelS_DAC1
        16,   // _5_ChannelS_DAC2
        16    // _6_Source_50V
    };

    return depth[v];
}


REG::REG(E _v) : v(_v)
{

}


wxString REG::GetNameDevice() const
{
    return wxString::Format("REG%d", (int)v);
}


int REG::BitDepth() const
{
    static const int depth[Count] =
    {
         8,     // _0_Source3kV
        16,     // _1_Commutator
         8,     // _2_ChannelC
        24,     // _3_ChannelB
        32,     // _4_ChannelS
         8      // _5_MeasCurrent
    };

    return depth[v];
}


FPGA::FPGA(E _v) : v(_v)
{

}


wxString FPGA::GetNameDevice() const
{
    return wxString::Format("FPGA%d", (int)v);
}


int FPGA::BitDepth() const
{
    static const int depth[Count] =
    {
        9,
        8,
        8
    };

    return depth[v];
}


void Chip::WriteValue(uint value) const
{
    if (IsDAC())
    {
        DAC *dac = (DAC *)this;

        if (SPI::WriteDynamicDAC(dac->GetType(), (uint16)value))
        {
            return;
        }
    }

    IDevice::impl->SendCommand(":%s:WRITE %X", GetNameDevice().c_str().AsChar(), value); //-V111
}


void Chip::WriteWidthToDevice() const
{
    IDevice::impl->SendCommand(":%s:LENGTH %d", GetNameDevice().c_str().AsChar(), BitDepth()); //-V111
}
