Sasha7b9Work/Linia/sources/Linia2/src/IPPP/Emulator/EmulatorDevice.h

// 2025/08/29 18:05:35 (c) Aleksandr Shevchenko e-mail : Sasha7b9@gmail.com
#pragma once
#include "IPPP/IDevice.h"


class EmulatorDevice : public IDevice
{
public:

    EmulatorDevice() = default;

    virtual ~EmulatorDevice();

    virtual bool Init() override;

    virtual void ApplicationTask() override;

    virtual void DeInit() override;

    virtual bool IsConnected() const override;

    virtual void SendCommand(pchar format, ...) const override;

    virtual bool ReadData(int data_dac[NUMBER_ADC][POINTS_IN_SAMPLE_ADC], int data_code[POINTS_IN_SAMPLE_ADC]) override;

private:

    static void CallbackOnReceive(uint8 *, int);
};
