Sasha7b9Work/Linia/sources/Linia2/src/description.h

#pragma once

/*
    *** Структура проекта ***

    Communicator        Средства работы с разъёмом GPIO
        CompPort        Работает вместо UART, когда программа запускается на ПК с ОС Windows. Плата устройства с контроллером stm32 подключается
                            к ПК по USB
        GPIO            Ручное управление портами
        SPI             Чтение данных из ПЛИС, запись в динамические ЦАПы
        UART            Коммуникация с контроллером stm32
    Data                Структуры данных измерений
    IPP                 Высокоуровневые абстракции ИППП
        Emulator        Эмулятор ИППП для работы на ПК с Windows или Linux
        Keyboard        Органы управления на лицевой панели ИППП - кнопки, энкодер
        Real            "Боевой" ИППП, с которым идёт реальная работа
        SCPI            Интерфейс общения с контроллером stm32
    GUI                 Графический интерфейс пользователя
        Controls        Элементы GUI
        PageTests       На этой странице можно выбрать, создаить и настроить требуемый тест


    *** Обновление прошивки stm32 ***

    1. По кнопке на панели Отладка - Контроллер-
    1. Отправляем запрос на обновление прошивки
        :FIRMWARE:UPDATE
    2. Ожидаем ответ
        :FIRMWARE:UPDATE READY
    3. 
*/
