Sasha7b9Work/Linia/sources/Linia2/src/option.h

// 2023/11/25 13:27:48 (c) Aleksandr Shevchenko e-mail : Sasha7b9@gmail.com
#pragma once

// Количество считываемых АЦП
#define NUMBER_ADC        4

// Количество считываемых точек из каждого АЦП
#define POINTS_IN_SAMPLE_ADC 200
