Sasha7b9Work/Linia/sources/Linia2/src/Panels/PanelDebug/NotebookDebug.cpp

// 2025/6/3 14:06:23 (c) Aleksandr Shevchenko e-mail : Sasha7b9@tut.by
#include "defines.h"
#include "Panels/PanelDebug/NotebookDebug.h"
#include "Panels/PanelDebug/PageTestsGPIO.h"
#include "Panels/PanelDebug/PagesBlocks/PageFPGA.h"
#include "Panels/PanelDebug/PagesBlocks/PageSource3kV.h"
#include "Panels/PanelDebug/PagesBlocks/PageCommutator.h"
#include "Panels/PanelDebug/PagesBlocks/PageChannelC.h"
#include "Panels/PanelDebug/PagesBlocks/PageChannelB.h"
#include "Panels/PanelDebug/PagesBlocks/PageChannelS.h"
#include "Panels/PanelDebug/PagesBlocks/PageMeasCurrent.h"
#include "Panels/PanelDebug/PagesBlocks/PageSource50V.h"


NotebookDebug *NotebookDebug::self = nullptr;


NotebookDebug::NotebookDebug(wxWindow *parent) :
    wxNotebook(parent, wxID_ANY, wxDefaultPosition, wxDefaultSize, wxBK_TOP)
{
    self = this;

    AppendNewPage(new PageTestsGPIO(this));
    AppendNewPage(new PageFPGA(this));
    AppendNewPage(new PageCommutator(this));
    AppendNewPage(new PageSource3kV(this));
    AppendNewPage(new PageChannelC(this));
    AppendNewPage(new PageChannelB(this));
    AppendNewPage(new PageChannelS(this));
    AppendNewPage(new PageMeasCurrent(this));
    AppendNewPage(new PageSource50V(this));

    wxWindowBase::Layout();

    Bind(wxEVT_NOTEBOOK_PAGE_CHANGING, &NotebookDebug::OnEventPageChanged, this);
}


void NotebookDebug::AppendNewPage(wxPanel *page)
{
    wxNotebook::AddPage(page, page->GetName());
}


void NotebookDebug::Init()
{
    PageTestsGPIO::self->Init();
}


void NotebookDebug::DeInit()
{
    PageTestsGPIO::self->DeInit();
}


void NotebookDebug::Update()
{
    PageTestsGPIO::self->Update();
}


void NotebookDebug::Pack()
{
    PageTestsGPIO::self->Pack();
    PageFPGA::self->Pack();
    PageCommutator::self->Pack();
    PageSource3kV::self->Pack();
    PageChannelC::self->Pack();
    PageChannelB::self->Pack();
    PageChannelS::self->Pack();
    PageMeasCurrent::self->Pack();
    PageSource50V::self->Pack();

    Config::WriteInt("pagedebug_page", GetSelection());
}


void NotebookDebug::Unpack()
{
    PageTestsGPIO::self->Unpack();
    PageFPGA::self->Unpack();
    PageCommutator::self->Unpack();
    PageSource3kV::self->Unpack();
    PageChannelC::self->Unpack();
    PageChannelB::self->Unpack();
    PageChannelS::self->Unpack();
    PageMeasCurrent::self->Unpack();
    PageSource50V::self->Unpack();

    SetSelection((size_t)Config::ReadInt("pagedebug_page", 0));
}


void NotebookDebug::OnEventPageChanged(wxBookCtrlEvent &event)
{
    if (switching_allowed)
    {
        Pack();
    }
    else
    {
        event.Veto();
    }
}


void NotebookDebug::EnableSwitching(bool enable)
{
    switching_allowed = enable;
}
