Sasha7b9Work/Linia/sources/VS/Linia2/src/Panels/PanelModeUpper.cpp

// 2025/6/1 17:14:36 (c) Aleksandr Shevchenko e-mail : Sasha7b9@tut.by
#include "defines.h"
#include "Panels/PanelModeUpper.h"
#include "MainWindow.h"


PanelModeUpper *PanelModeUpper::self = nullptr;


PanelModeUpper::PanelModeUpper(wxWindow* parent) :
    Panel(parent, MainWindow::WIDTH1, 0, MainWindow::WIDTH2, MainWindow::HEIGHT1)
{
    self = this;

    new wxStaticText(this, wxID_ANY, wxString::Format("ver. %d : %s", VERSION_BUILD, DATE_BUILD), { 480, 53 });
}
