Sasha7b9Work/Linia/sources/VS/Linia2/src/Panels/PanelDebug/NotebookChips.h

// 2025/6/3 14:06:45 (c) Aleksandr Shevchenko e-mail : Sasha7b9@tut.by
#pragma once


class NotebookChips : public wxNotebook
{
public:

    NotebookChips(wxWindow *parent);

    static NotebookChips *self;

    void Init();

    void Update();

    void DeInit();
};
