Sasha7b9Work/Linia/sources/VS/Linia2/src/Panels/Panel12_Debug/PageAD5443.h

// 2025/08/30 11:23:29 (c) Aleksandr Shevchenko e-mail : Sasha7b9@tut.by
#pragma once
#include "Panels/Panel12_Debug/PageChip.h"


class PageAD5443 : public PageChip
{
public:

    PageAD5443(wxNotebook *);

    static PageAD5443 *self;
};
