Sasha7b9Work/Linia/sources/Linia2/src/GUI/Controls/SpinBox.h

// 2025/7/23 14:18:36 (c) Aleksandr Shevchenko e-mail : Sasha7b9@gmail.com
#pragma once
#include "GUI/Controls/Panel.h"
#include "GUI/Controls/Button.h"
#pragma warning(push, 0)
    #include <wx/textctrl.h>
#pragma warning(pop)


/*
*   Собственный спинбокс. Разработанн ввиду того, что стандартный на Linux очень большой
*/


class SpinBox : public Panel
{
public:

    SpinBox(wxWindow *parent, const wxSize &, int min, int max);

    int GetValue() const;

    void SetValue(int);

private:

    int min = 0;
    int max = 0;

    wxTextCtrl *text = nullptr;
    Button *btnMore = nullptr;
    Button *btnLess = nullptr;

    void OnEventButton(wxCommandEvent &);
};
