Sasha7b9Work/Linia/(commit log)

2025-05-31 Добавлены файлы wxWidgets
2025-06-01 Добавлены исходники от CIC. Запускается
2025-06-01 Теперь нельзя изменить размер окна
2025-06-01 Создаётся новая панель
2025-06-01 Не работают кнопки
2025-06-03 Добавлена кнопка ОТЛАДКА
2025-06-03 По нажатию кнопки ОТЛАДКА открывается страница отладки
2025-06-03 Notebook растянут на весь экран
2025-06-03 Три страницы для микросхем
2025-06-04 Размер бита зафиксирован на 20
2025-06-04 Перешли на GraphicsContext
2025-06-05 Добавлены файлы контроллера от IntelAvto
2025-06-05 vs_keil работаетЭ
2025-07-12 Кнопки меню ТЕСТ
2025-07-12 Кнопки меню НАСТРОЙКИ
2025-07-12 Кнопки меню АРХИВ
2025-07-12 Кнопки меню ГРАФИК
2025-07-13 Заготовка для панели 3
2025-07-13 Заготовка для рисования
2025-07-13 Очень медленно работает перемещение
2025-07-14 Перешли на wxGraphicsContext
2025-07-23 Заготовка для кастомного спинбокса
2025-07-25 Сетка нормально показаана
2025-07-26 Кнопки выхода из отладочного режима
2025-07-27 Правая кнопка мыши на сетке арихва
2025-07-30 Первая попытка задать диапазоны
2025-08-01 Реализованы ряды 124 и 125 в токе
2025-08-01 Теперь по Esc диалоги закрываются
2025-08-04 Поддержка сборки для arm64
2025-08-08 Теперь картинки полупроводников могут затеняться
2025-08-08 Выбор картинки категории мышкой
2025-08-08 Пробуем скрипт для конвертирования картинок в *.h
2025-08-08 В скрипт build.bat добавлены команды копирования файлов
2025-08-08 Подсказки
2025-08-09 Не получается отрисовать на кнопке
2025-08-09 Кнопка с рисунком
2025-08-09 Заготовка для всплывающего окна
2025-08-09 Выведены текстовые кнопки
2025-08-09 Выбор развёртки сделан
2025-08-09 Теперь всплывающее окно на кнопки с рисунками создаётся один раз
2025-08-09 Возвращаемся к многократному созданию окна с выбором кнопок - на линукс Show()/Hide() вызывает ошибки
2025-08-09 Выбранная кнопка отображается
2025-08-11 Добавлены: 6 режимов STM32, валидация параметров, RS-232 протокол, автоматическое логирование, колбэки и обработка ошибок
2025-08-11 Удалёно проэкт Device
2025-08-11 Добавлено ButtonsCombo
2025-08-13 Работает ComboButtons для напряжений
2025-08-13 Работает ComboButtons работает для токов
2025-08-13 События ButtonCombo подключены
2025-08-13 Подключены события wxEVT_COMBO у всех самодельных комбобоксов
2025-08-13 Подправлен слайдер
2025-08-13 комбобоксы диапазонов сделаны красиво
2025-08-14 Слайдер смещения правильно показывает
2025-08-14 слайдер лимита правильно показывает
2025-08-14 refacat. Добавлена страница канала S
2025-08-15 Готовимся отображать рисунок на кнопке
2025-08-19 Подготовились к отрисовке схемы
2025-08-20 spi create
2025-08-20 Проба поборость невидимые кнопки на апельсинке
2025-08-20 Ещё лучше
2025-08-21 add build_arm64.sh, removing unnecessary sh scripts, fix spi
    [SPI.cpp]
2025-08-21 assembly fix
2025-08-22 correct stab for windows
    [SPI.cpp]
2025-08-22 refact SPI.cpp
2025-08-22 форматирование
2025-08-22 Переименован файл конфигурации
2025-08-25 refact SPI
2025-08-26 refact spi and conditional compilation
2025-08-28 Схема добавлена
    [kont_lineJ.sch]
2025-08-28 Теперь все контролы одинаковые
2025-08-28 Нажатие в левую часть кнопки даёт инкремент
2025-08-29 Удалён тупиковый путь сериализации
2025-08-29 Продлжаем сохранять настройки
2025-08-29 Теперь значения из комбобоксов сохраняются в виде строк, а не индексов
2025-08-29 Сохраняется номер активной страницы
2025-08-29 Не работает сохранение SliderFloat
2025-08-29 Работает сохранение SliderFloat
2025-08-29 Удалена локализация
2025-08-29 удалён файл *.loc
2025-08-30 Добавлены файлы для микросхем модулей
2025-08-30 Пробуем добавить поле для ввода десятичного значения
2025-08-30 Удалена возможность обратного порядка бит
2025-08-30 Чекбоксы битов отрабатывают текстовое значение
2025-08-30 Текстовое поле отрабатывает изменения чекбоксов
2025-08-30 Готовимся к командам
2025-08-30 Команды выбираются кнопками
2025-08-31 Работает собственное событие кнопки2
2025-09-01 Кнопка выбора категории автоматически скрывается
2025-09-01 Создаётся каталог mod
2025-09-01 Пофикшен вылет на менюшках
2025-09-01 Менюшки
2025-09-01 create UART
2025-09-01 Заготовка для GPIO
2025-09-02 Ошибка на Linux@
2025-09-02 Удалены пины SPI из GPIO
2025-09-03 Делаем тесты
2025-09-03 Удалены лишние пробелы из UART.cpp
2025-09-03 Создан поток для опроса пинов GPIO
2025-09-03 Адреса SPI, UART вынесены в заголовочные файлы
2025-09-03 В SPI.cpp удалён исключительный случай для Linux x64. Теперь оно обрабатывается так же, как для Win
2025-09-04 UART refact
2025-09-04 Изображены порты ввода/вывода
2025-09-04 GPIO готовы к испытаниям
2025-09-04 Добавлены резистор и конденсатор
2025-09-05 Уточнение типа генератора канала B
2025-09-05 Удалены ресурсы
2025-09-05 Добавлены ресурсы
2025-09-05 Уточнение типа генератора канала S
2025-09-05 Начинаем компиляцию gpio.cpp под Windows
2025-09-05 GPIO компилируется на Windows
2025-09-05 SPI компилируется на Windows
2025-09-05 UART компилируется на Windows
2025-09-06 Сообщения перенаправлены в файл лога
2025-09-06 Реализован EmulatorDevice под текущий интерфейс
2025-09-06 Продолжаем инициализировать gpio на Windows
2025-09-06 В лог не выводится название функции
2025-09-06 Начинаем делать полный экран
2025-09-06 Переключение в режим полного экрана
2025-09-06 Панель ошибок мигает
2025-09-06 Убрали паразитный скроллбар из PanelErros
2025-09-06 Убрали кнопку из PanelErrors - на Linux она не поддерживается
2025-09-06 Добавление/удаление ошибок PanelErrors
2025-09-06 Всплаывающее окно в комбобоксах с краю всплывает на более нормальном месте
2025-09-06 Исправлен баг в логе
    [Application.cpp, defines.h]
2025-09-07 Заготовки для конвертеров данных
2025-09-07 Исправлено преобразование значений АЦП
    [defines.h]
2025-09-07 Добавлено устройство IPPP
2025-09-07 Добавлен источник по каналу C
2025-09-07 Добавлена функция для обратного преоразования данных
2025-09-07 Начинаем тесты
2025-09-07 Реализованы тесты для конвертера данных
2025-09-07 Не выскакивают ошибки, если нет файла с изображением из ресурсов
2025-09-08 Добавлены pdf схемы
2025-09-09 Восстановлены тесты данных
2025-09-09 В Application добавлены функции для приёма сообщений от Device
2025-09-09 Вернули перемещение сетки
2025-09-09 Уменьшена ширина зоны отрисовки
2025-09-10 Отменён сдвиг пунктирных линий на сетке
2025-09-10 сетка
2025-09-10 рисуем сетку
2025-09-10 Отрисовка сетки закончена на данный момент
2025-09-10 IPPP теперь класс
2025-09-11 Device refact
2025-09-11 Удалён поток из DeviceIPPP
2025-09-11 Начинаем клавиатуру
2025-09-23 Настройки UART законстанчены
2025-09-23 refact UART
2025-10-02 Добавлены недостающие пины
2025-10-02 Кнопка закрытия окна
2025-10-03 максимальный уровень отладочной информации в Linux
2025-10-03 Проект вёрнут в нормальное состояние. Только отлючена инициализация GPIO
2025-10-03 Подключена инициализация GPIO
2025-10-03 Операции с GUI вынесены из потоков
2025-10-03 Скорректирован алгоритм чтения FPGA@
2025-10-03 уменьшено процессорное время на GPIO (наверное)
2025-10-03 Восстановлена неудаляемость лога
2025-10-03 Возможно, скрипт теперь универсальный для Linux - и на x64 и на arm64
2025-10-06 Принимаем данные
2025-10-07 Добавлена возможность изменения функции на приём по UART
2025-10-07 Сделан приём по UART на отладочной странице (теоретическти)
2025-10-07 Добавлена индикация версииЭ
2025-10-07 Добавлена страница для источника 3 кВ
2025-10-07 Добавлена страница для коммутатора
2025-10-07 Добавлена страница для канала B
2025-10-07 Добавлена страница для канала S
2025-10-07 Добавлена страница для источника тока
2025-10-07 Добавлена страница источника 50 В
2025-10-07 Боремся с вылетом на приёме по UART
2025-10-07 Пробуем UART
2025-10-08 Кажется, работает связь по UART
2025-10-08 Скорость UART увеличена до 2000000
2025-10-08 Скорость UART вёрнута до 921600
2025-10-08 Ускорено чтение пина
2025-10-09 Подключен опрос портов ввода-вывода
2025-10-09 Добавлено измерение среднего времени чтения FPGA
2025-10-09 Отключены 1 set, 1 get pin
2025-10-09 Отключена установка ещё одного пина во вложенном цикле
2025-10-09 Отключены все операции во вложенном цикле
2025-10-09 Оставлена оперция логического ИЛИ во внутреннем цикле
2025-10-09 Добавлена статистика по времени работы с пинами
2025-10-14 wxWidtets обновлены до 3.3.1
2025-10-14 wxWidgets вёрнуто к 2.8.1
2025-10-15 Удалены ADC
2025-10-16 Засылка значений в регистре по кнопке ЗАПИСАТЬ
2025-10-16 Устранён вылет на повторном открытии таблицы смещений и коэффициентов
2025-10-17 Добавлена заготовка для диалога с автоматическим закрытием
2025-10-17 Подключена автоматическая перезагрузка при необнаружении UART либо SPI
2025-10-17 При запуске обновляются десятичные поля в регистрах
2025-10-17 Нормально отрабатывают комбобоксы команд
2025-10-17 Устанавливается красный цвет на инвалидный выбор комбобокса
2025-10-17 Рефакторнули, но вот беда - вылетает, потому что нету чипов
2025-10-17 Заготовка для сохранения значений регистров
2025-10-17 Значения регистров сохраняются
2025-10-20 Заблокированы страницы wxNotebook PageDebug при включённых автозасылках
2025-10-23 Добавлены графически ещё две развёртки
2025-10-23 Страница ПЛИС готова
2025-10-23 Улучшена информативность вывода о GPIO
2025-10-24 Сделан приём лога от stm32
2025-10-24 работает лог
2025-10-24 Начинаем переделку окошек меню
2025-10-24 отмена
2025-10-24 Проверим выпадение меню на Ubuntu Desktop
2025-10-24 Начинаем переносить панель модели
2025-10-24 Панель модели перемещена
2025-10-24 Удалено отображение таблицы
2025-10-24 Увеличен размер клетки сетки
2025-10-24 Скорректированы положения окон меню
2025-10-30 переход на wxWidgets 3.3.1
2025-10-30 Подправили пути для сборки под linux
2025-11-06 Теперь свой IP определяется и на Windows
2025-11-14 Пытаемся ускорить сборку wxWidgets и оптимизировать наше приложение
2025-11-14 Восстановлена компилируемость на windows
2025-11-21 Переход на Visual Studio 2026
2025-11-21 Все скрипты собраны в одном каталоге. Собирается на Windows
2025-11-21 x64-версия на Windows
2025-12-04 Отлключена отладочная панель энкодера - слшиком много времени занимает
2025-12-04 Не создаётся панель GPIO
2025-12-05 MCU проект перенесён сюда
    [kont_lineJ.sch, kont_lineJ_1.sch]
2025-12-05 Device MCU компилируется под win
2026-01-15 Сделаны кнопки Старт, Стоп для FPGA
2026-01-15 Должны посылаться команды старт/стоп развёрток
2026-01-15 Device Готово к приёму команд Развёртка Старт/Развёртка Стоп
2026-01-15 Закончено управление развёрткой без проверки
2026-01-15 Исправлен баг с нулевыми размерами регисторв
2026-01-15 Отладочная версия
2026-01-15 Не инициализируются пины
2026-01-16 Запуск проходит на TP5
2026-01-16 Управляется от Orange Pi 5 Plus
2026-01-19 Добавили файлы USBD. Не компилируется
2026-01-19 USB сконфигурирован, но не определеяется
2026-01-19 Не определяется USB
2026-01-19 Device USB определяется
2026-01-19 Работает управление с Orange Pi 5 Plus
2026-01-19 Компилируется vs_keil версия
2026-01-19 Device Заготовка для обработки данных с VCP
2026-01-19 Device Должно обрабатываться управление с VCP
2026-01-19 Сделана запись в ComPort, но зависает при попытке что-то туда записать
2026-01-20 Device Работает управление с компьютера
2026-01-20 Можно выбрать ком-порт из панели управления
2026-01-20 Работает управление с панели в полном объёме
2026-01-21 COM-порт должен работать только на Windows
2026-01-23 Попытка улучшить подключение к COM-порту
2026-01-24 Начинаем делать правую панель на отладочной панели
2026-01-24 Кнопки Старт/Стоп перенесены на правую панель
2026-01-24 Orange Pi передаёт в контроллер период запуска развёртки при нажатии кнопки Старт
2026-01-25 Device Теперь отрабатывает принимаемый период запуска развёртки
2026-01-26 Отладочная прошивка
2026-01-27 Начинаем забивать регистр канала базы
2026-01-27 Забиты диапазоны источника напряжения базы
2026-01-27 Забиты диапазоны источника тока базы
2026-01-28 Теперь при выборе диапазона в канале B обновляются значения на кнопках групп битов
2026-01-28 Комбобоксы диапазонов в канале B отрабатывают нормально
2026-02-03 Скорректированы значения полей регистра каналы базы
2026-02-03 Должно записываться значение в регистра базы REG3 из панели
2026-03-09 Сделана ручка для DAC
2026-03-09 Теперь курсор мыши остаётся на месте при вращении ручки
2026-03-09 Соответствующие DACи пишутся с помощью Orange Pi@
2026-03-10 Готовимся к хитрой системе старт/стоп
2026-03-10 Добавлена возможность задействовать эмулятор
2026-03-10 Подключён эмулятор
2026-03-11 Надпись ЭМУЛЯТОР
2026-03-11 Заготовка для событий
2026-03-11 Не отображается сетка
2026-03-11 Кое-как неправильно выводит сетку.
2026-03-12 СТало ещё медленней
2026-03-12 Буффер в память тоже медленно рисует
2026-03-12 Вернулись к самой быстрой - первоначальной отрисовке
2026-03-12 Устранена неоднозначность размеров для Display
2026-03-12 Поделаны немного шкалы
2026-03-12 Подкорректировы записи в блок Базы
2026-03-12 Работает мини-карта
2026-03-13 Первый вариант ручного построения кривых биполярного транзистора
2026-03-13 Отличные кривые получены для транзисторов
2026-03-13 Улушилась производительность - убрал лишние отрисовки дисплея
2026-03-13 Первая версия смещения сигнала
2026-03-13 Двигается не сигнал, а сетка
2026-03-13 Теперь цвет графиков изменяется из меню
2026-03-13 Добавлен класс для отрисовки сплайнами
2026-03-13 Рисует сплайнами
2026-03-14 Сглаживание отключается, если графики сильно выходят за пределы экрана - чтобы быстродействие не падало
2026-03-15 Сохранение в настройках трекинга по X и Y
2026-03-16 Заготовка для окна расчёта
2026-03-16 Окно не перетаскивается, но и не вылетает
2026-03-16 Окно перетаскивается, но иногда отпускается
2026-03-16 Пошло двигаться окно
2026-03-16 Сохранение положения на экране окна РАСЧЁТ
2026-03-17 Готовимся к созданию модального DraggedWindow
2026-03-17 Не работает DraggedDialog
2026-03-17 Кажется, работает модальное окно на Windows
2026-03-17 Рисуется кастомный заголовок
2026-03-17 Работают три переключателя окна КУРСОРЫ
2026-03-18 Пытаемся починить позицию окна КУРСОРЫ
2026-03-18 Не работает позиционирование окон
2026-03-18 Увеличили длительность клоков при записи в регистры
2026-03-18 Первая версия отсчёта микросекунд
2026-03-19 Период клока - 4 мкс, длительность записи одного байта - 30 мкс
2026-03-19 Улучшаем цвета регистров
2026-03-19 Улучшены цвета на регистрах
2026-03-20 Виджет файлового менеджера
2026-03-20 Компилируется win-версия
2026-03-20 Исправлен баг, когда при нажатой кнопке "Автозапись" можно было переключать страницы wxNotebook
    [NotebookDebug.cpp]
2026-03-20 Теперь пила может засылаться в ЦАПы
2026-03-23 Из ГУИ удалены 8 и 9 развёртки
2026-03-23 Режим эмулятора вынесен в настройки
2026-03-23 Фабричный паттерн для I_IPPP
2026-03-26 Не работает установка значений DAC
2026-03-26 Вроде бы работает DAC
2026-03-26 refaсt
2026-03-26 Уменьшена скорость поворота ручки
2026-04-01 Убрали функцию чтения данных из ПЛИС
2026-04-02 Удалена страница Orange Pi
2026-04-03 Улучшен SliderInt
2026-04-03 Отлкючены логи о записях - тормозили компьютер
2026-04-06 Отключили логи от Device
2026-04-06 Отключены логи из Device
2026-04-07 Запись СТОП в альтеру по 66 PE13
2026-04-09 Возврат к старому длинному чипселекту SPI, потому что новый, который сделал ИИ, не заработал
2026-04-09 Пробуем завести аппаратный CS SPI0
2026-04-09 Не получилось сделать аппаратный SPI - занят вывод 24
2026-04-13 Засылка СТОП при инициализации платы контроллера
2026-04-15 Анимирована одиночная засылка
2026-07-29 Теперь подключился rapidJSON через vcpkg
2026-07-29 Удалил vcpkg, так как rapidJSON можно использовать и без него
2026-07-30 Второй проект Линии
2026-07-30 Удалены лишние файлы из Linia3
2026-07-30 Идея с Linia3 провалилась
2026-08-18 Удалена Linia3
2026-08-18 Добавлены файлы от последнего макетного релиза
2026-08-18 Компилируются старая и новая версии
2026-08-18 Сделана запись в динамические ЦАП
2026-08-19 Восстановлено отображение ОБОВЛЕНИЕ ПРОШИВКИ
2026-08-20 Добавлено MyComputer
2026-08-21 Тестовое чтение данных из альтеры
2026-08-24 Удалён случайно затесавшийся curl
2026-08-25 Начинаем добавлять динамические переменные - с доступом только по имени
2026-08-25 Теперь в лог выводит не только дату, но и время запуска
2026-08-25 Пытаемся сделать вывод контрольного значения
2026-08-31 Загружаются значения регистров из настроек
2026-08-31 Исправлена отрисовка точек. Теперь точки рисуются правильно на Windows и Linux
2026-09-01 Первая версия кнопок
2026-09-01 Теперь кнопки опять над регистрами
2026-09-01 Глобальный рефакторинг - нету IPPP, чтение данных в потоке
2026-09-02 Начинаем рисовать транзистор
2026-09-03 Рисуем тест
2026-09-14 удалили wxBufferedPaintDC - было много артефактов
2026-09-15 Размер регистра тока уменьшен до 8 бит
2026-09-17 Добавлена функциональность XP10:50+, XP10:50-
2026-09-17 Исправлены баги с 50+,50-
2026-09-17 Device. Исправлен пин. Удалён неиспользуемый пин
2026-09-22 stm32 : Заготовка для Loader
2026-09-22 stm32 refact
2026-09-22 stm32 Device Переход на загрузчик
2026-09-22 stm32 Loader Исправлен адрес таблицы прерываний
2026-09-22 stm32 Loader Добавлены функции работы с FLASH
2026-09-22 stm32 Loader Удалён CDC
2026-09-22 stm32 Loader
2026-09-22 Приближаемся к обновлениюЭ
2026-09-23 Linia2 Корректируем обновление прошивки
2026-09-23 Пробуем обновлённую версию обновляльщика
2026-09-24 Запускаем обновление
2026-09-24 Откат на один, потому что перестало обновляться
2026-09-24 stm32 Удалён класс String, в котором std::malloc() вызывал вылет
2026-09-30 Отрисовка конденсатора
2026-09-30 Надписи
2026-10-07 Пробуем откатиться для локализации бага с ComboButtons
2026-10-07 Откат на 1-е октября
2026-10-07 Откат на 1-е октября 11 часов
2026-10-07 Откат на 30-е сентября
2026-10-07 Откат на 28-е сентября
2026-10-07 Откат на 28 сен 17.33
2026-10-07 Откат на 29 сен 13:14
2026-10-07 Откат на 29 сен 14:29
2026-10-07 К чёрту откаты. Будем искать баг
2026-10-07 Пробуем отключить измерители и источники в коллекторе
2026-10-08 Частично нормально элементы переключаютс
2026-10-08 Заготовка для слайдера смещения каналов
2026-10-15 Модификация SliderInt
2026-10-15 Устранено взаимное заскакивание слайдеров ограничения в источнике коллектора
2026-10-27 Первая версия сохранения PanelCategory. Глючит
2026-10-27 Работает сохранение/загрузка PanelCategory
